asterane/the-grid/electronics/current-sources/board_prototype_1.jpg

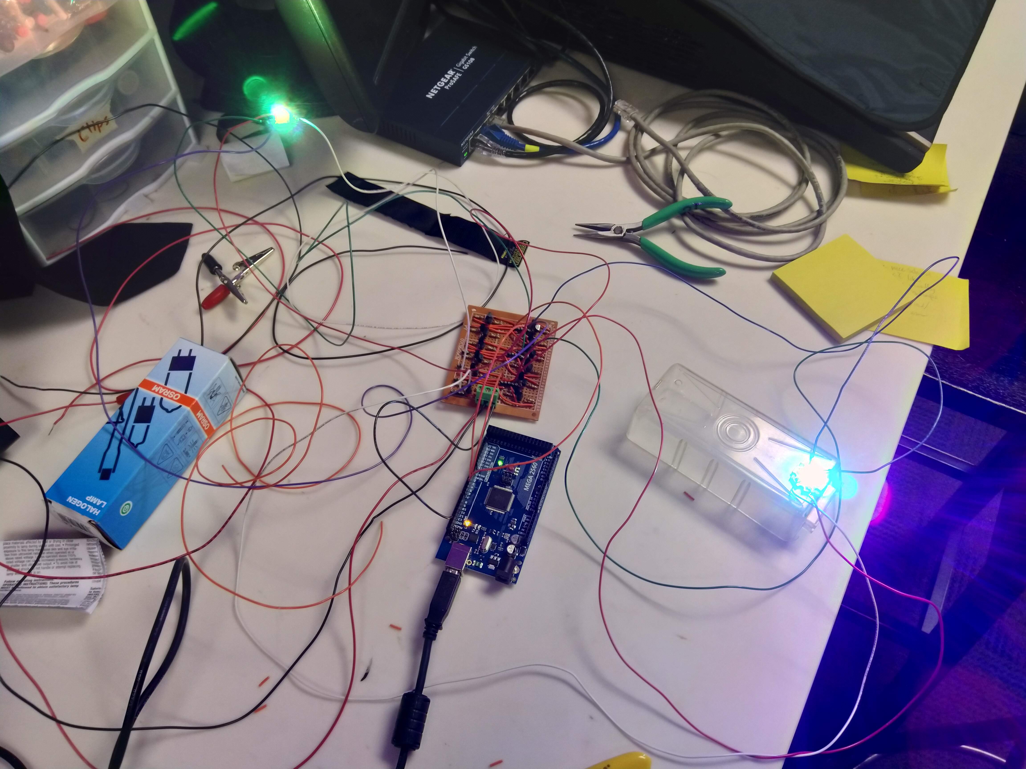
electronics/current-sources/board_prototype_1.jpg
