asterane/the-grid/electronics/current-sources/board_prototype_2.jpg

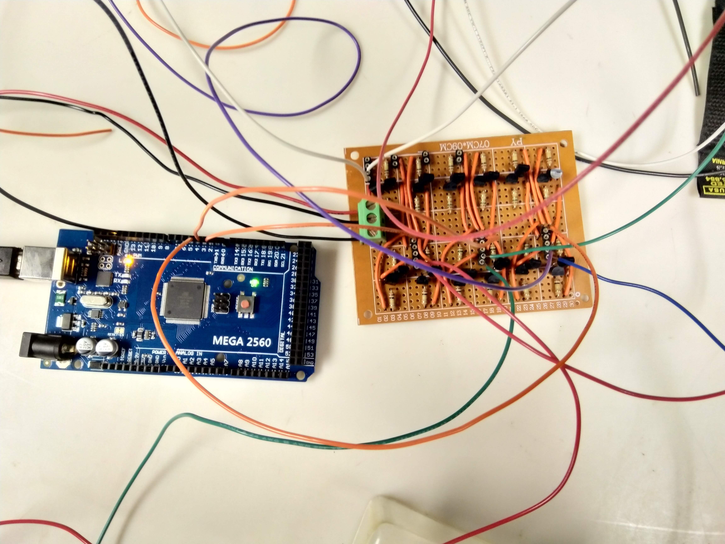
electronics/current-sources/board_prototype_2.jpg
