asterane/the-grid/electronics/current-sources/board_prototype_3.jpg

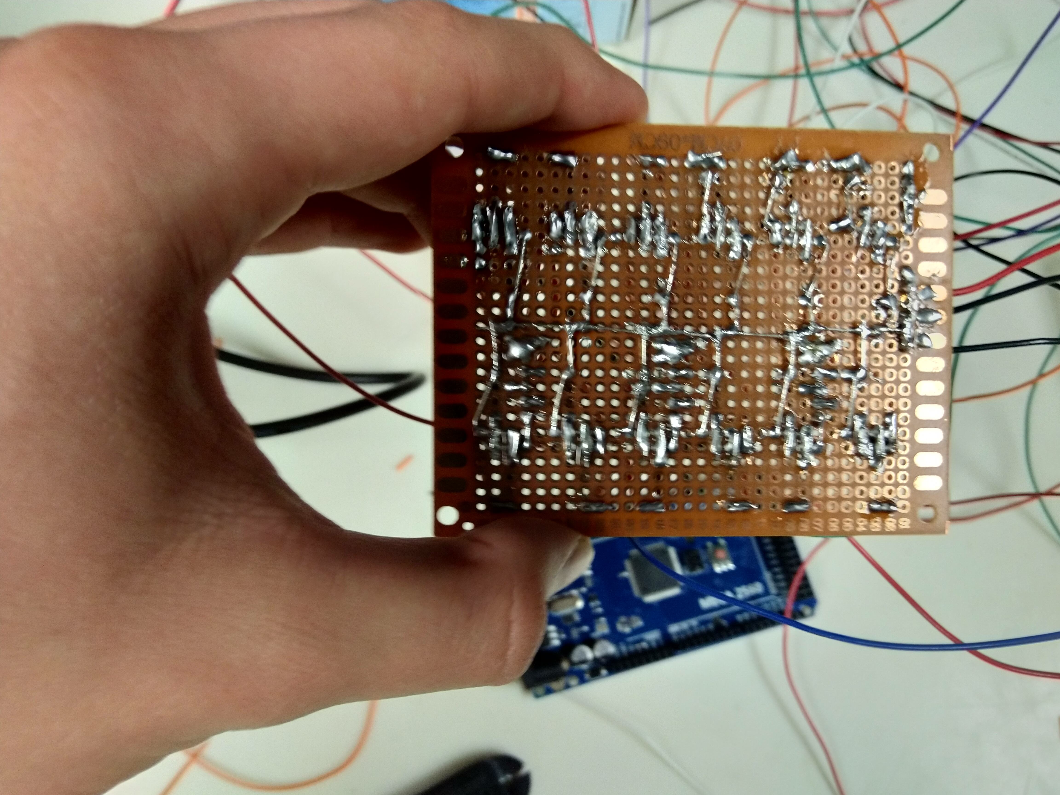
electronics/current-sources/board_prototype_3.jpg
