asterane/the-grid/electronics/current-sources/board_prototype_4.jpg

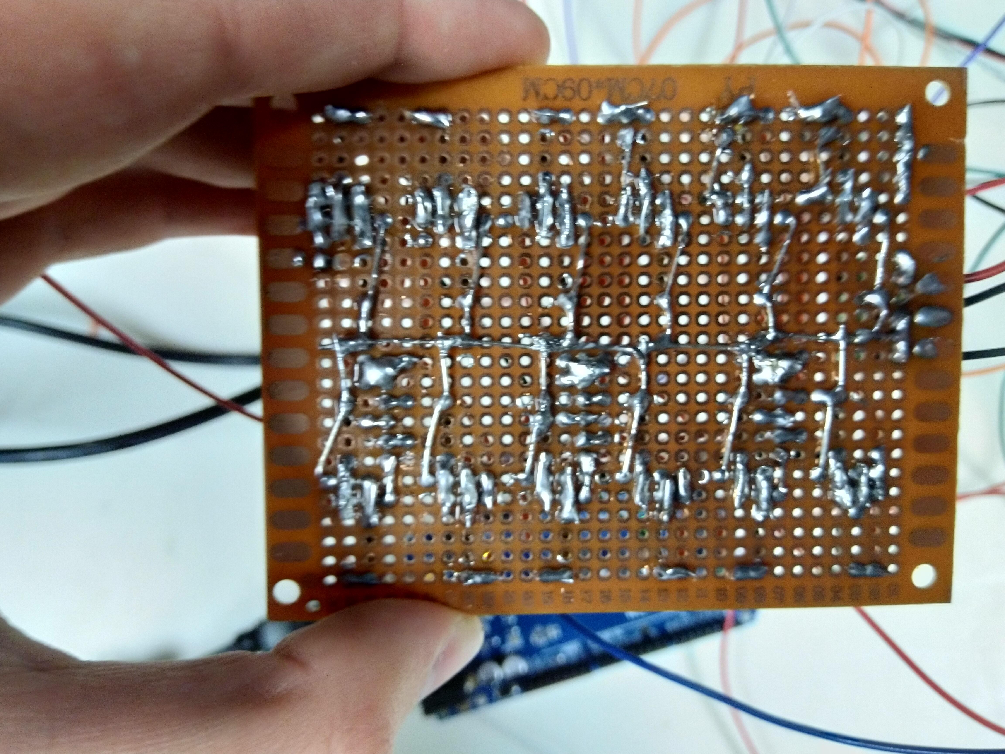
electronics/current-sources/board_prototype_4.jpg
