asterane/the-grid/electronics/current-sources/board_prototype_5.jpg

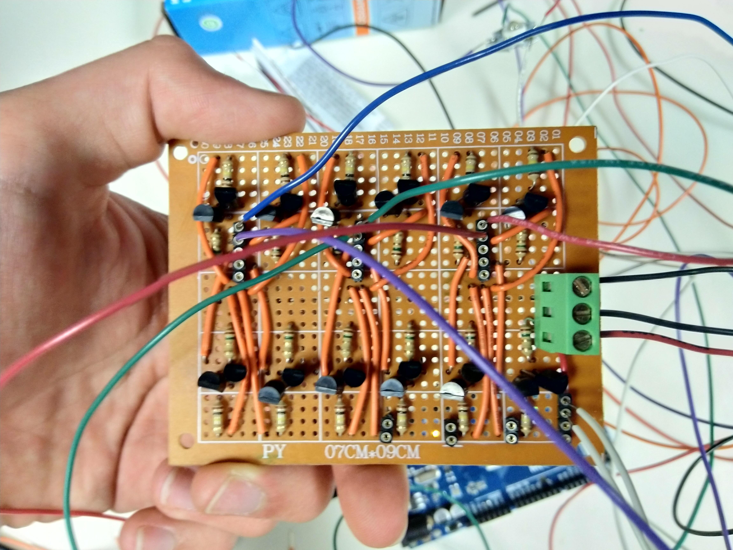
electronics/current-sources/board_prototype_5.jpg
