asterane/the-grid/electronics/current-sources/board_prototype_6.jpg

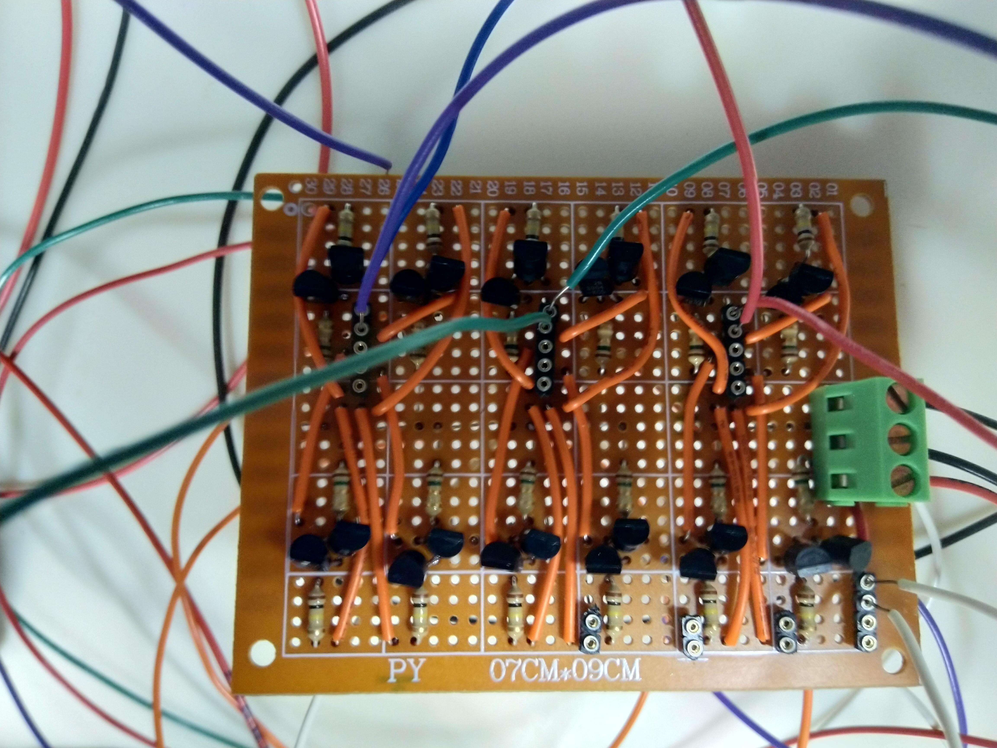
electronics/current-sources/board_prototype_6.jpg
