asterane/the-grid/electronics/current-sources/finished_boards_1.jpg

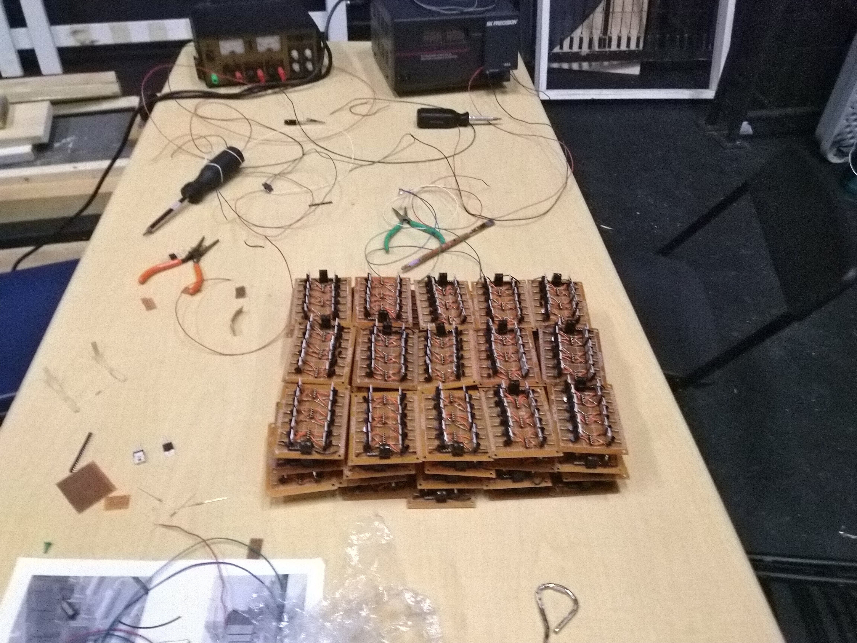
electronics/current-sources/finished_boards_1.jpg
