asterane/the-grid/electronics/current-sources/finished_boards_2.jpg

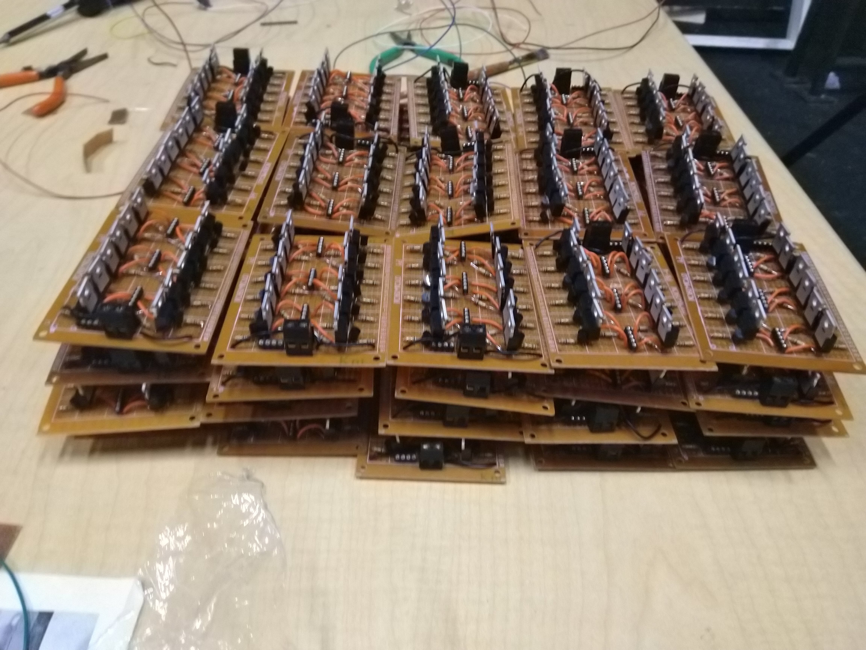
electronics/current-sources/finished_boards_2.jpg
