asterane/the-grid/electronics/current-sources/renderings/board1.png

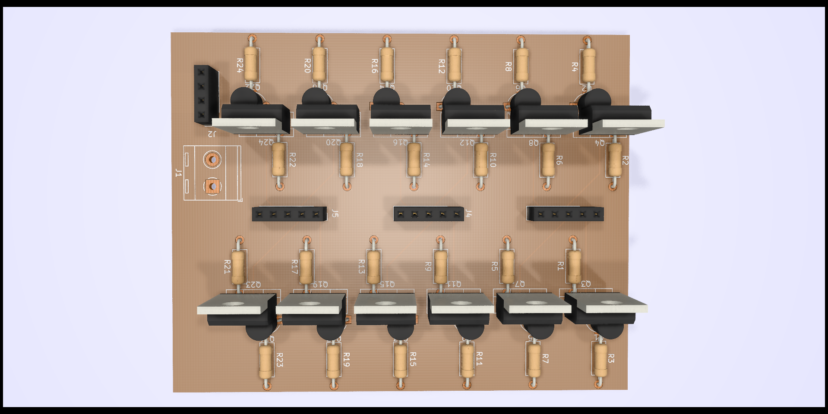
electronics/current-sources/renderings/board1.png
