asterane/the-grid/electronics/current-sources/renderings/board2.png

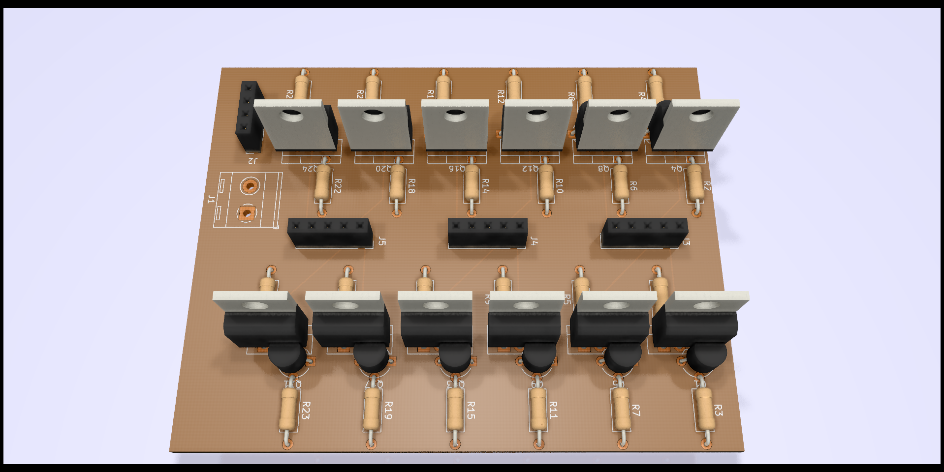
electronics/current-sources/renderings/board2.png
