asterane/the-grid/electronics/current-sources/renderings/board3.png

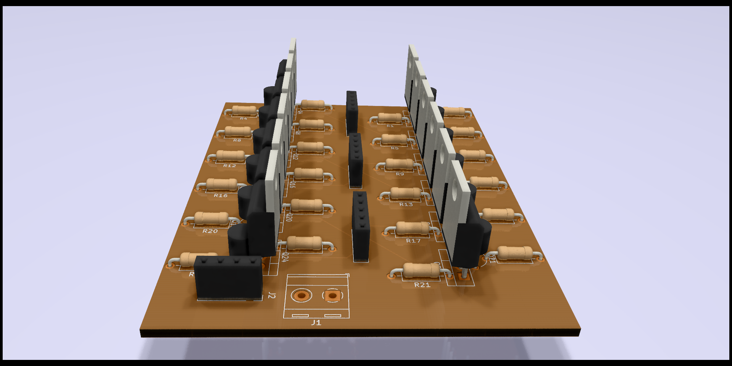
electronics/current-sources/renderings/board3.png
