asterane/the-grid/electronics/current-sources/renderings/board4.png

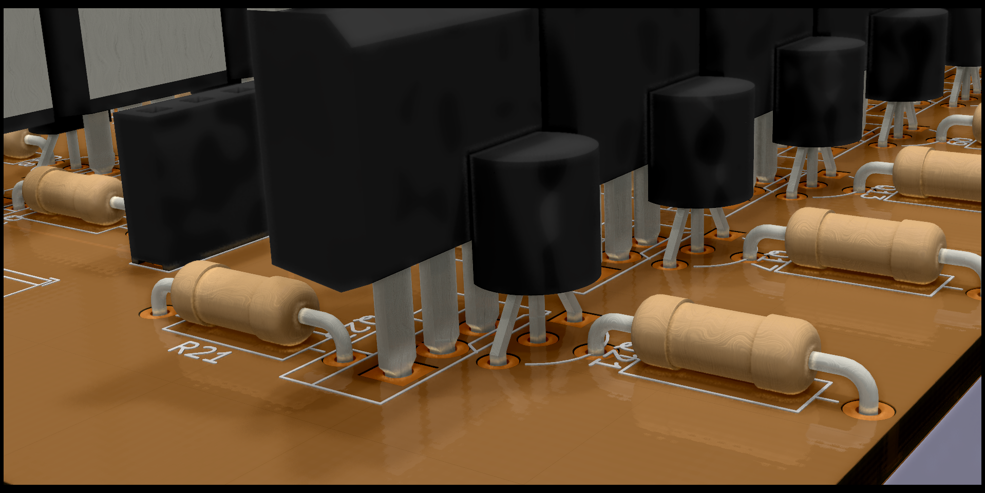
electronics/current-sources/renderings/board4.png
