asterane/the-grid/electronics/current-sources/renderings/board5.png

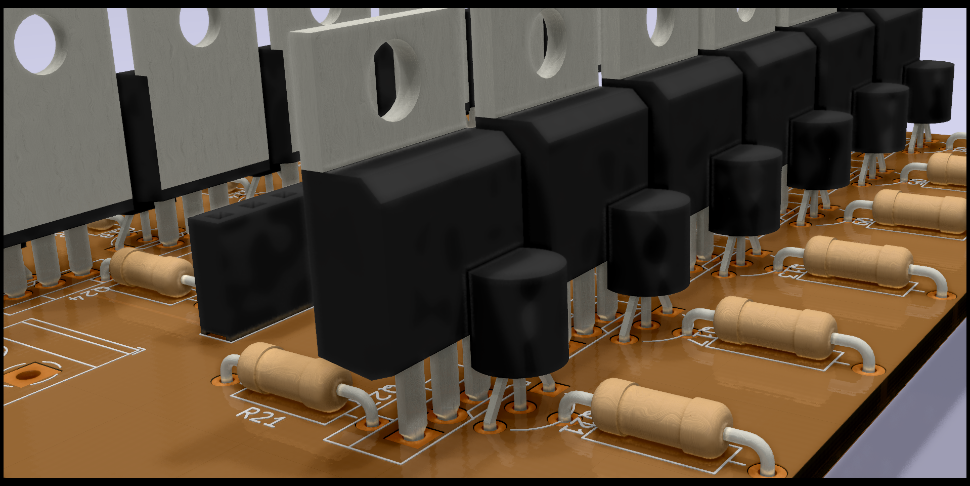
electronics/current-sources/renderings/board5.png
