asterane/the-grid/electronics/current-sources/renderings/board6.png

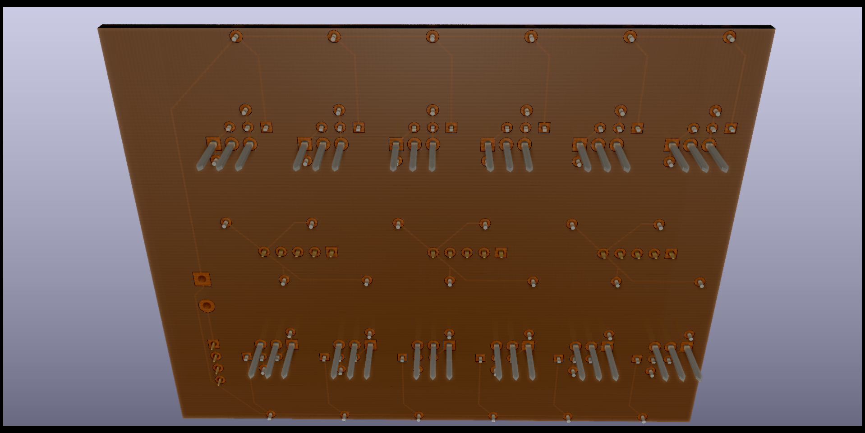
electronics/current-sources/renderings/board6.png
