asterane/the-grid/electronics/current-sources/renderings/board7.png

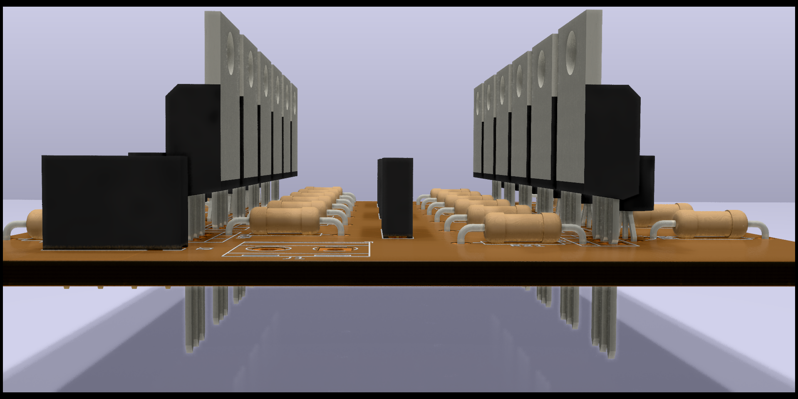
electronics/current-sources/renderings/board7.png
