asterane/the-grid/electronics/current-sources/renderings/board8.png

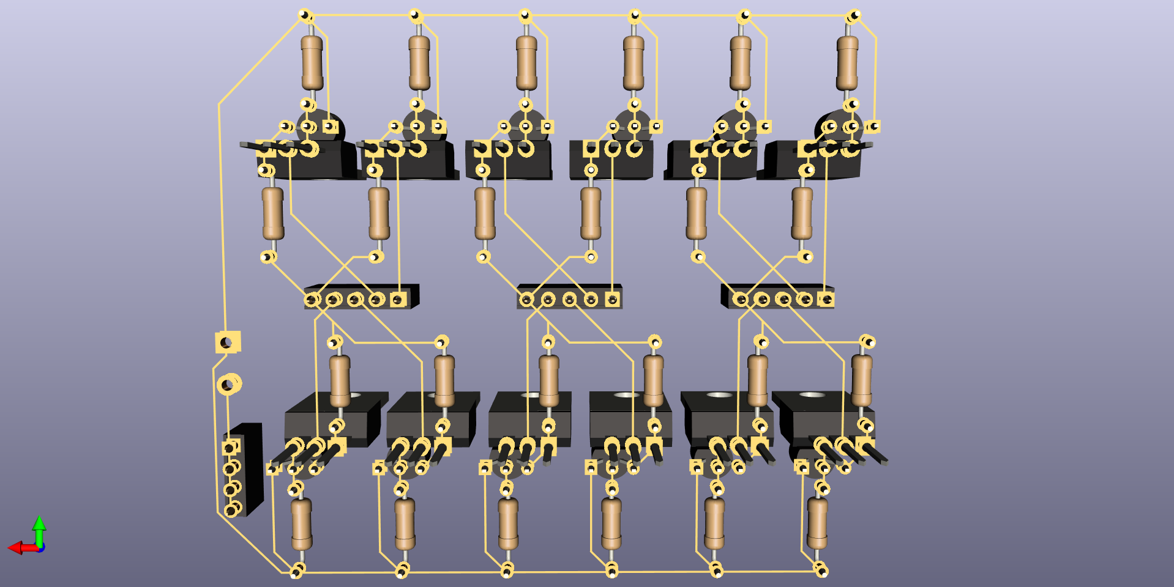
electronics/current-sources/renderings/board8.png
