asterane/the-grid/electronics/current-sources/renderings/board9.png

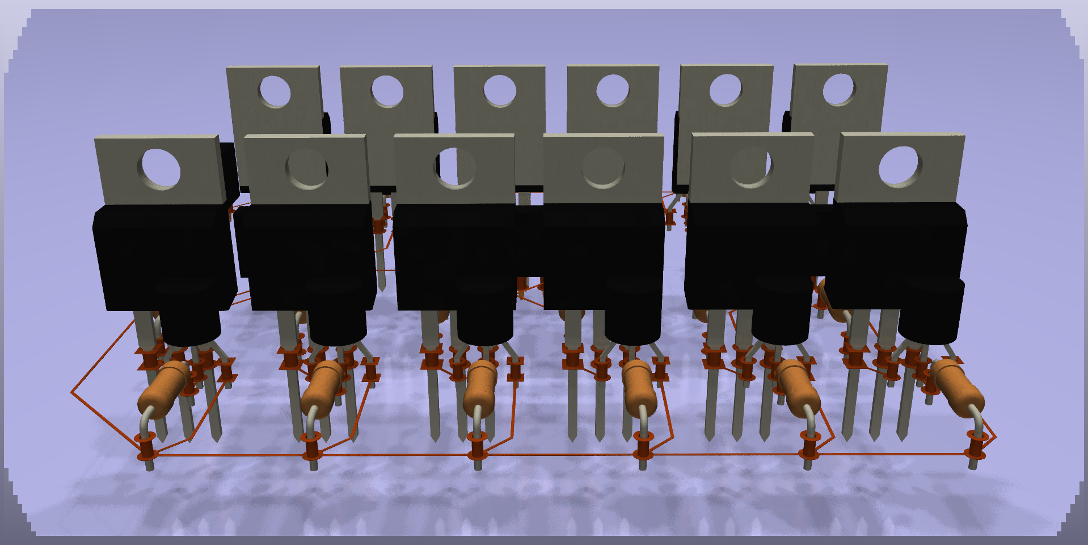
electronics/current-sources/renderings/board9.png
