asterane/the-grid/electronics/current-sources/renderings/board10.png

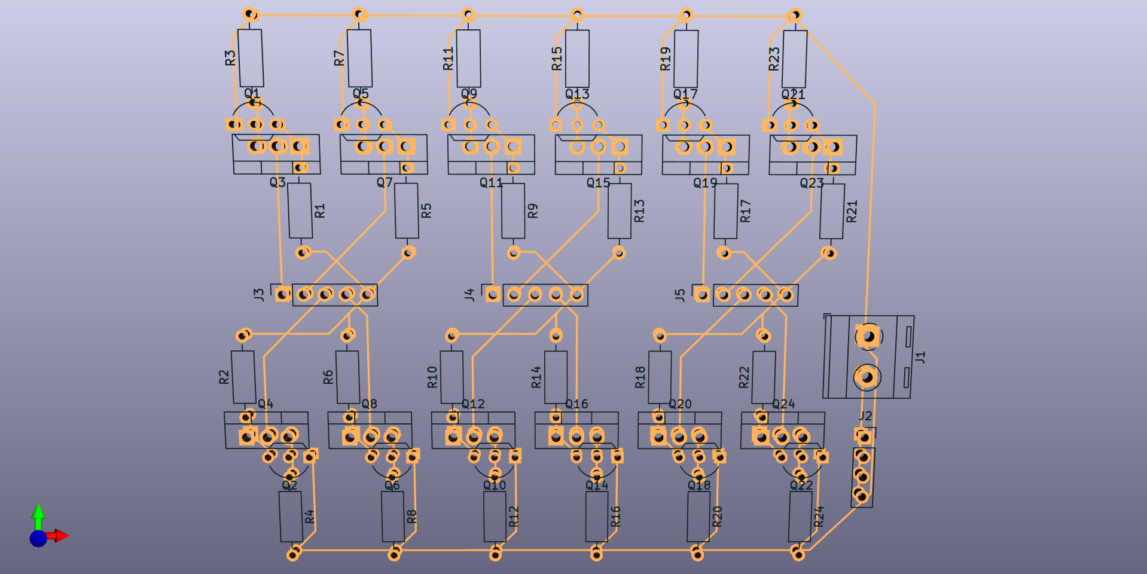
electronics/current-sources/renderings/board10.png
