asterane/the-grid/electronics/current-sources/renderings/board11.png

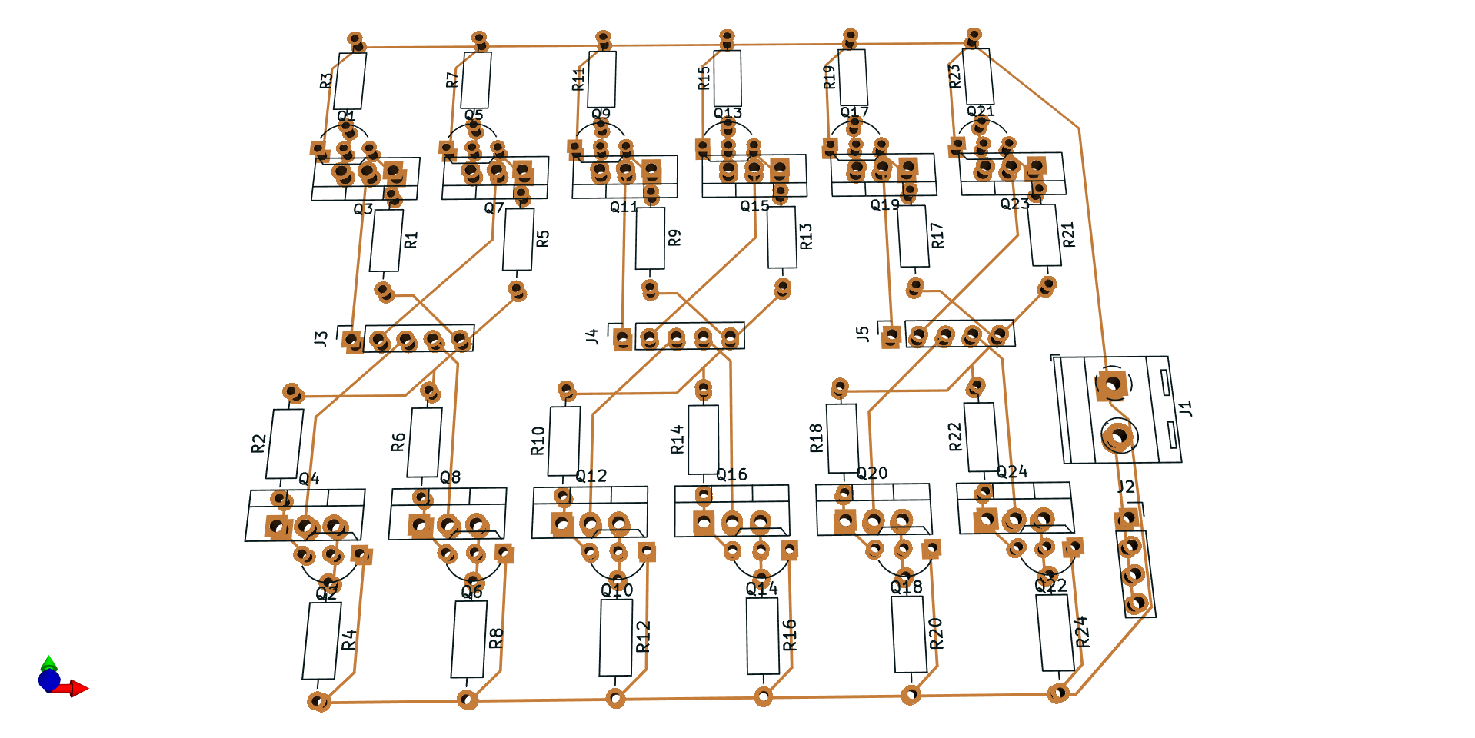
electronics/current-sources/renderings/board11.png
