asterane/the-grid/electronics/current-sources/renderings/board12.png

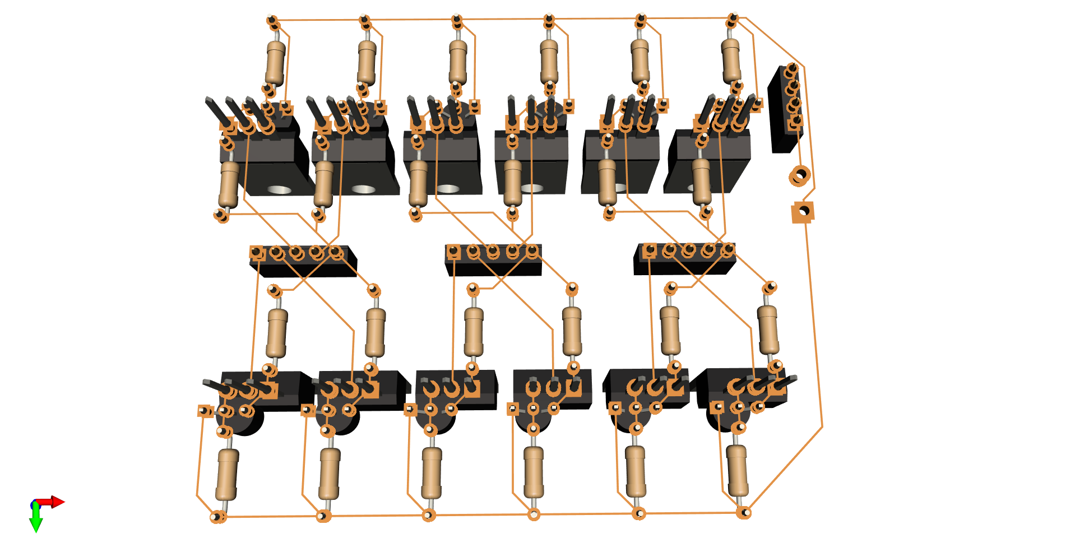
electronics/current-sources/renderings/board12.png
