asterane/the-grid/electronics/current-sources/renderings/board13.png

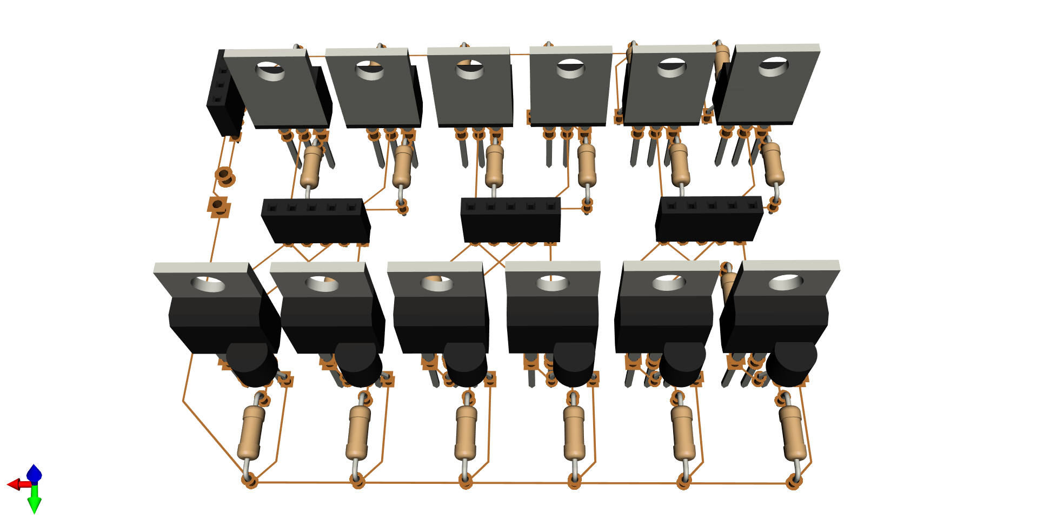
electronics/current-sources/renderings/board13.png
