asterane/the-grid/electronics/current-sources/renderings/board14.png

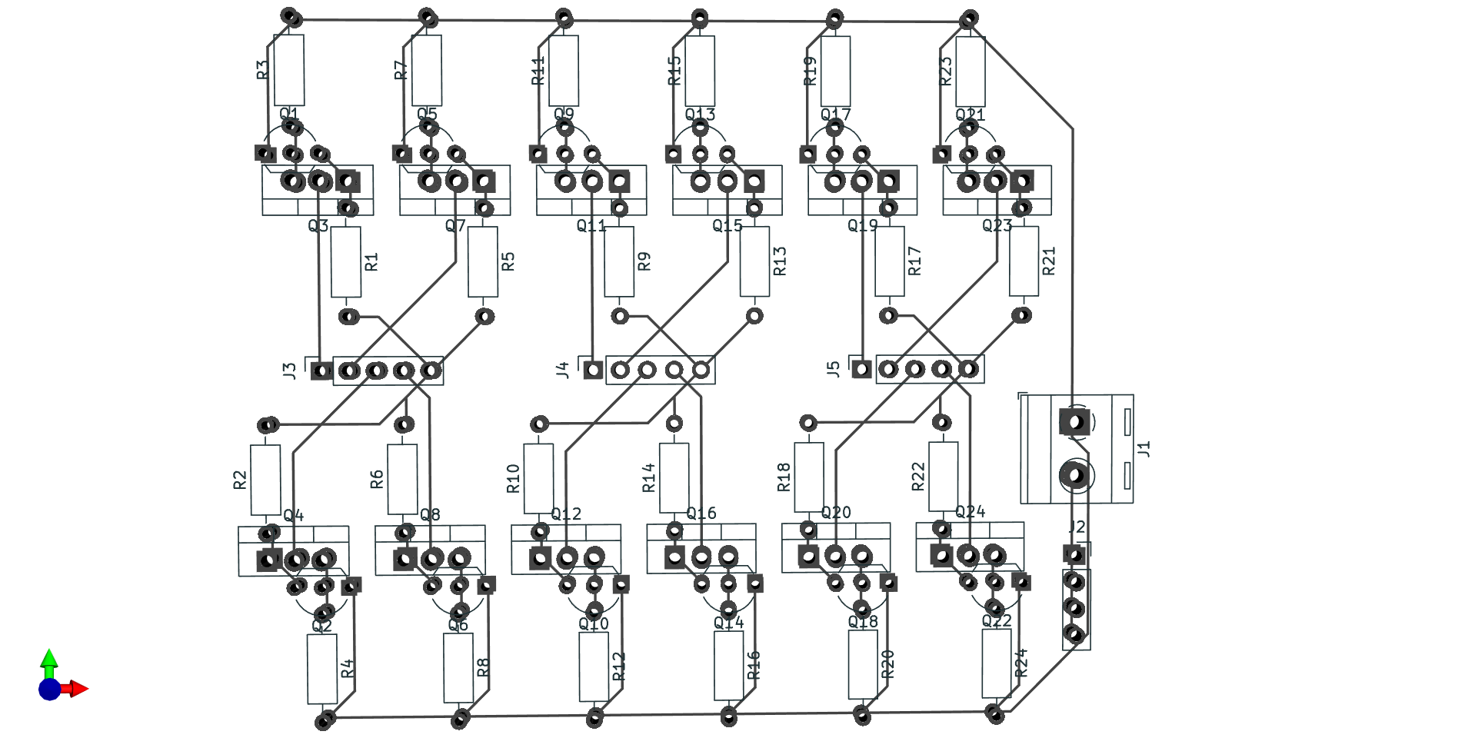
electronics/current-sources/renderings/board14.png
