asterane/the-grid/electronics/current-sources/renderings/board15.png

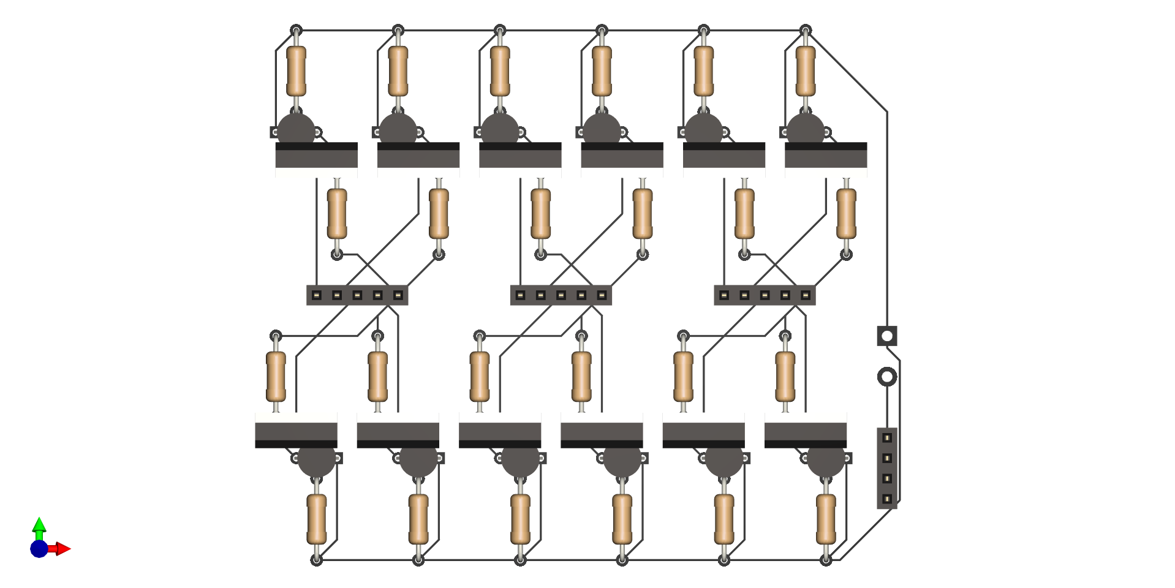
electronics/current-sources/renderings/board15.png
