asterane/the-grid/electronics/current-sources/renderings/board16.png

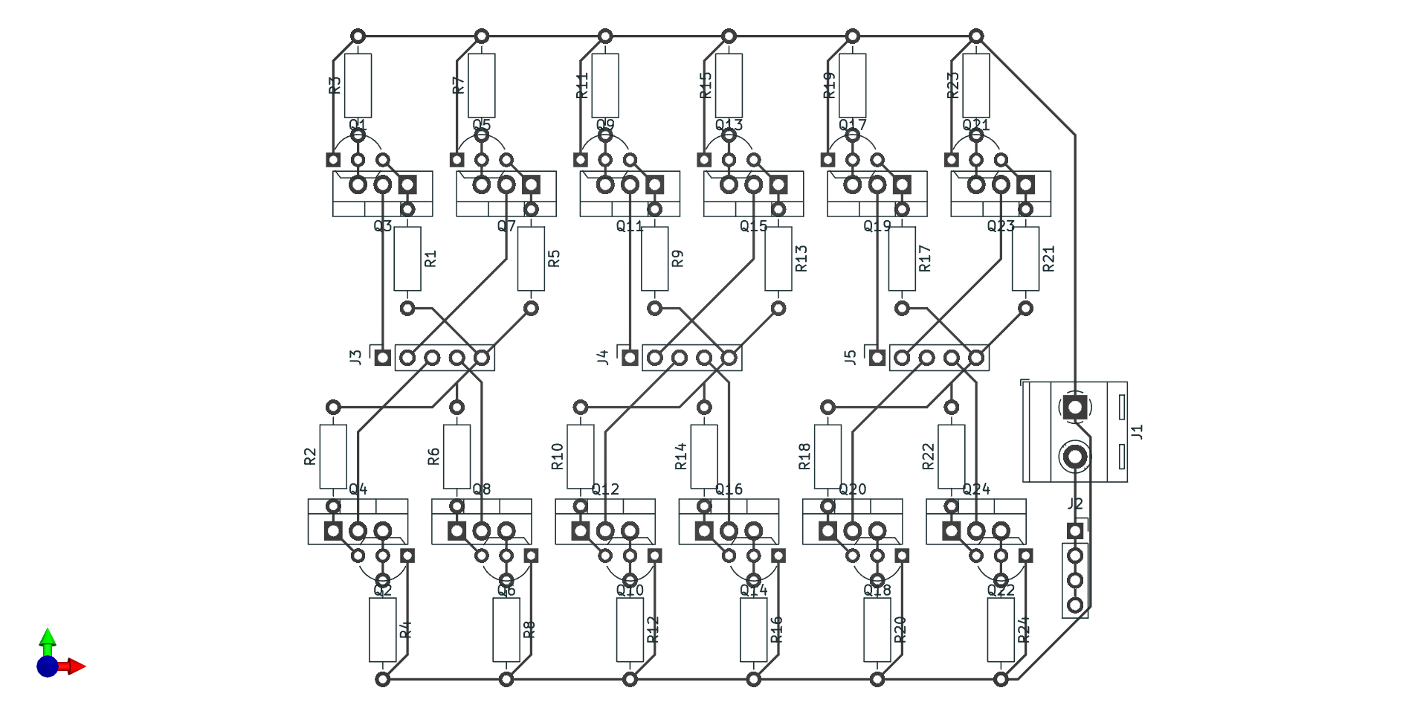
electronics/current-sources/renderings/board16.png
