asterane/the-grid/electronics/current-sources/renderings/board17.png

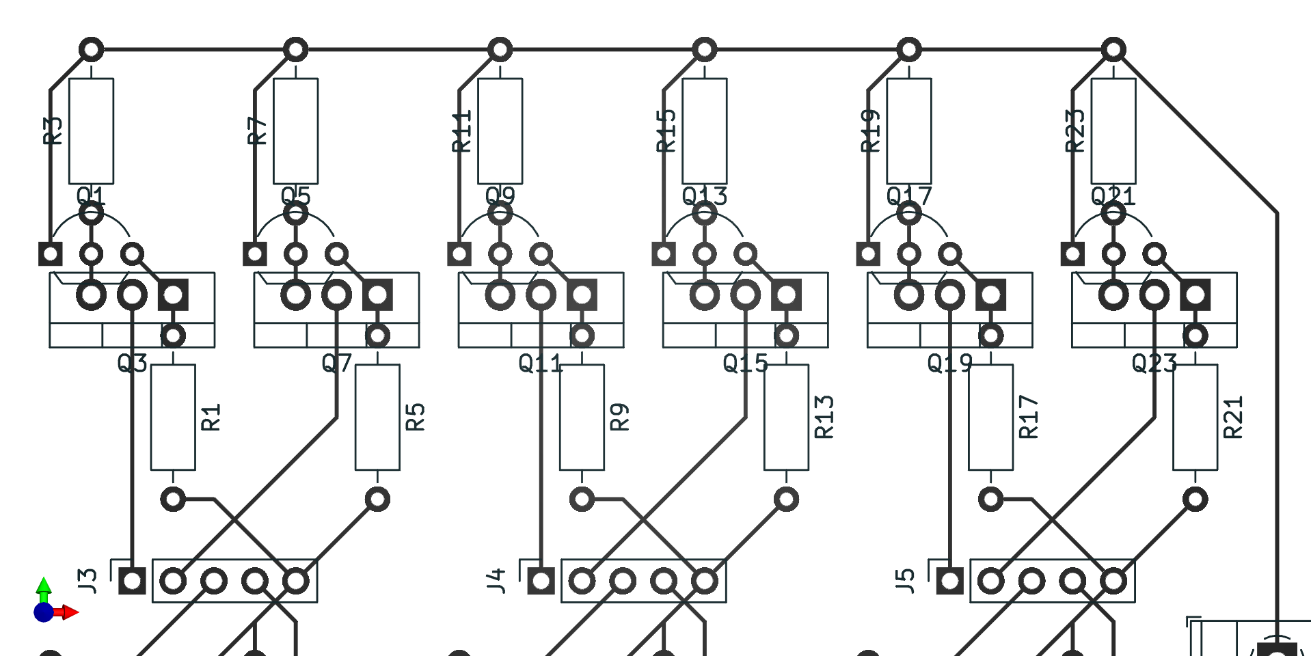
electronics/current-sources/renderings/board17.png
