asterane/the-grid/electronics/current-sources/renderings/board18.png

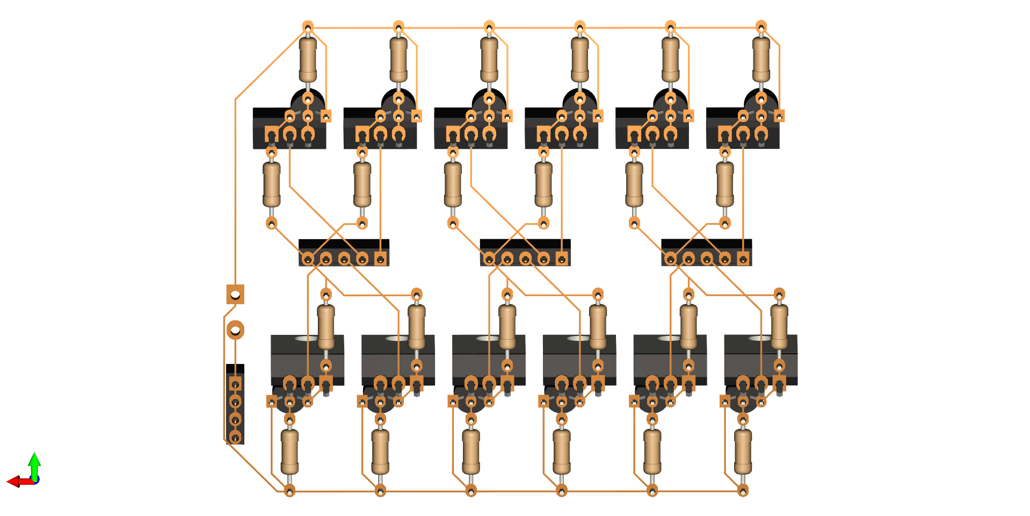
electronics/current-sources/renderings/board18.png
