asterane/the-grid/electronics/integration_01.jpg

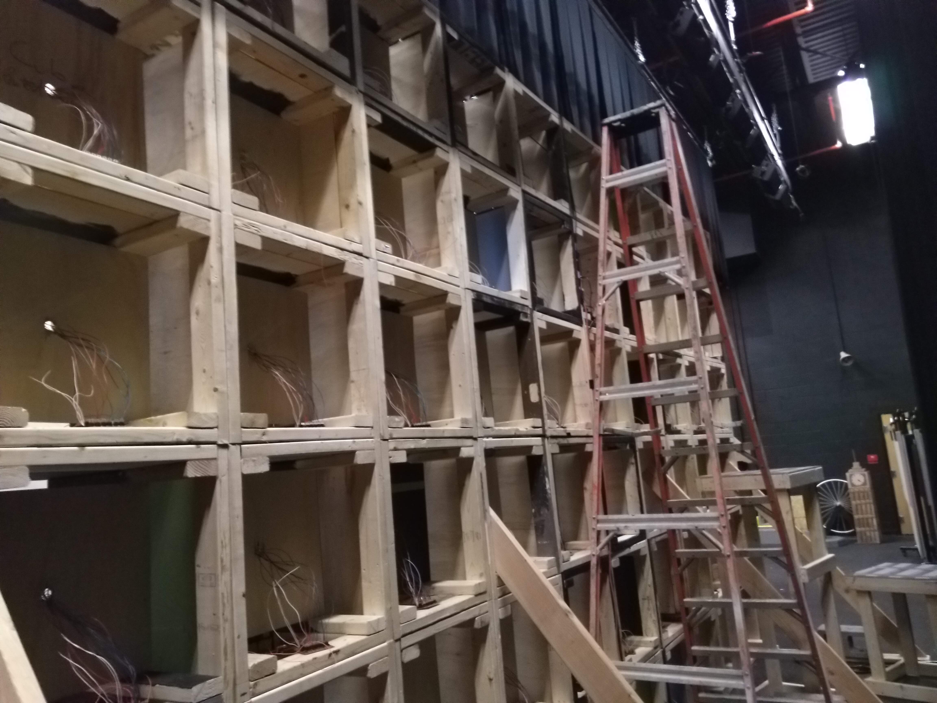
electronics/integration_01.jpg
