asterane/the-grid/electronics/integration_02.jpg

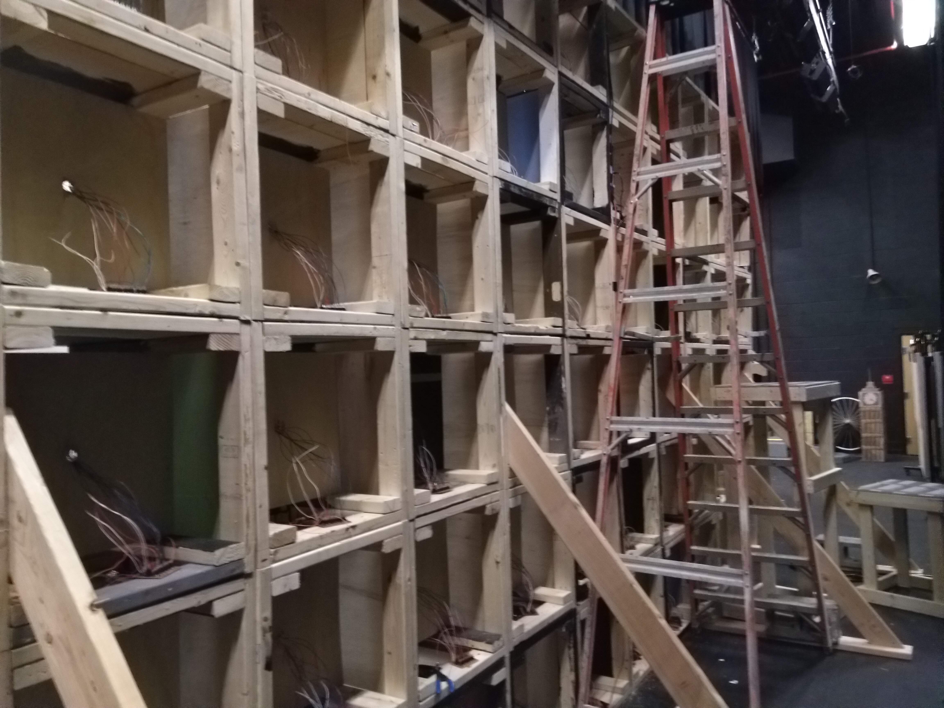
electronics/integration_02.jpg
