asterane/the-grid/electronics/integration_03.jpg

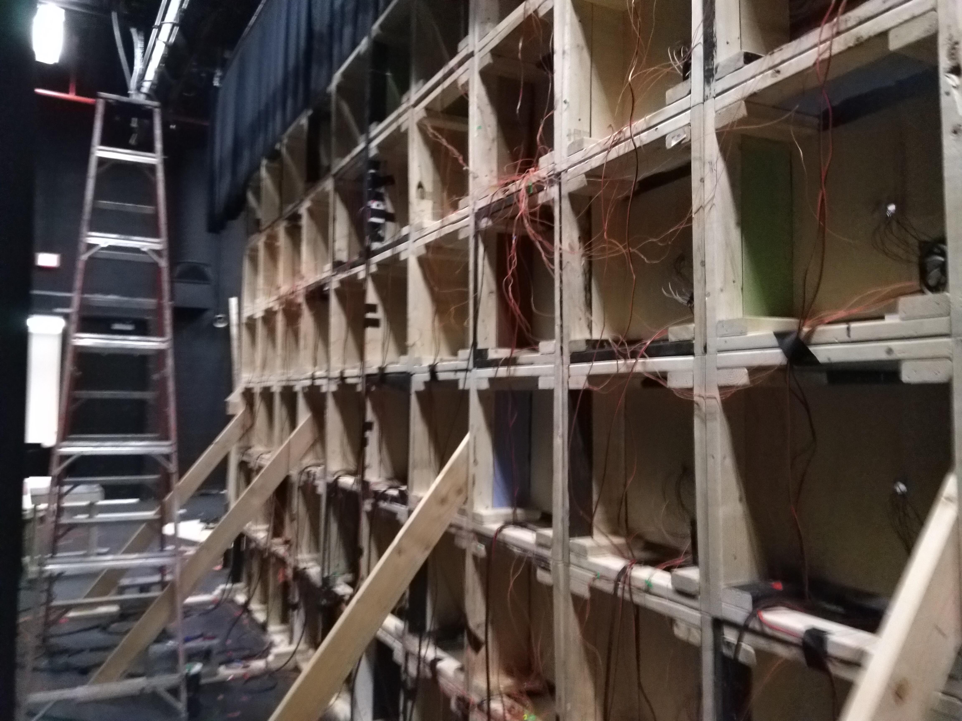
electronics/integration_03.jpg
