asterane/the-grid/electronics/integration_04.jpg

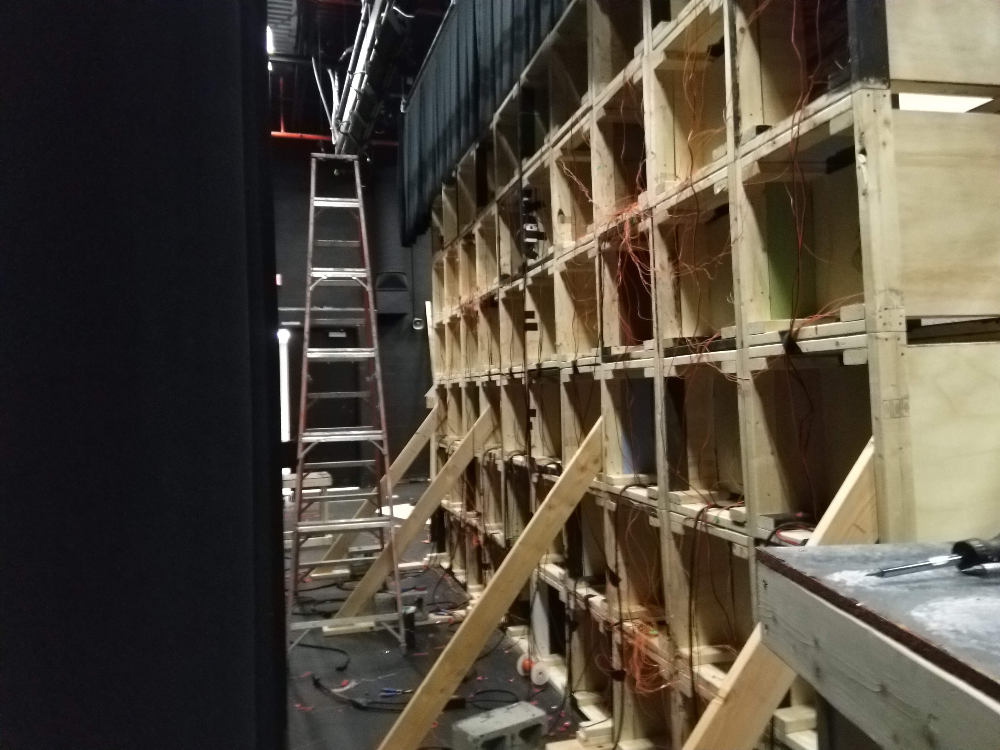
electronics/integration_04.jpg
