asterane/the-grid/electronics/integration_05.jpg

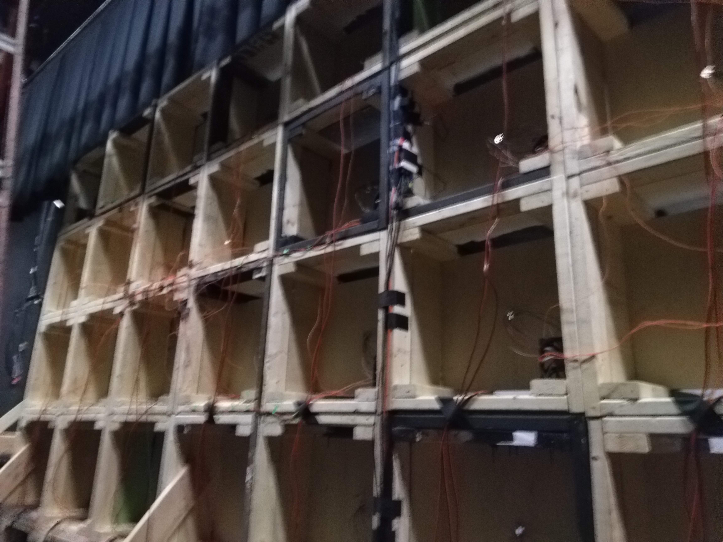
electronics/integration_05.jpg
