asterane/the-grid/electronics/integration_06.jpg

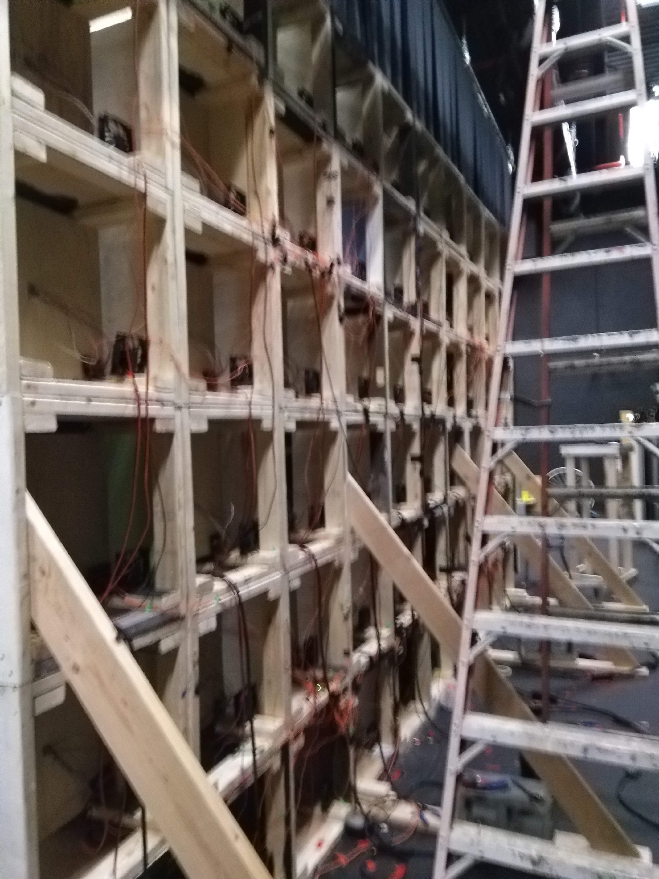
electronics/integration_06.jpg
