asterane/the-grid/electronics/integration_07.jpg

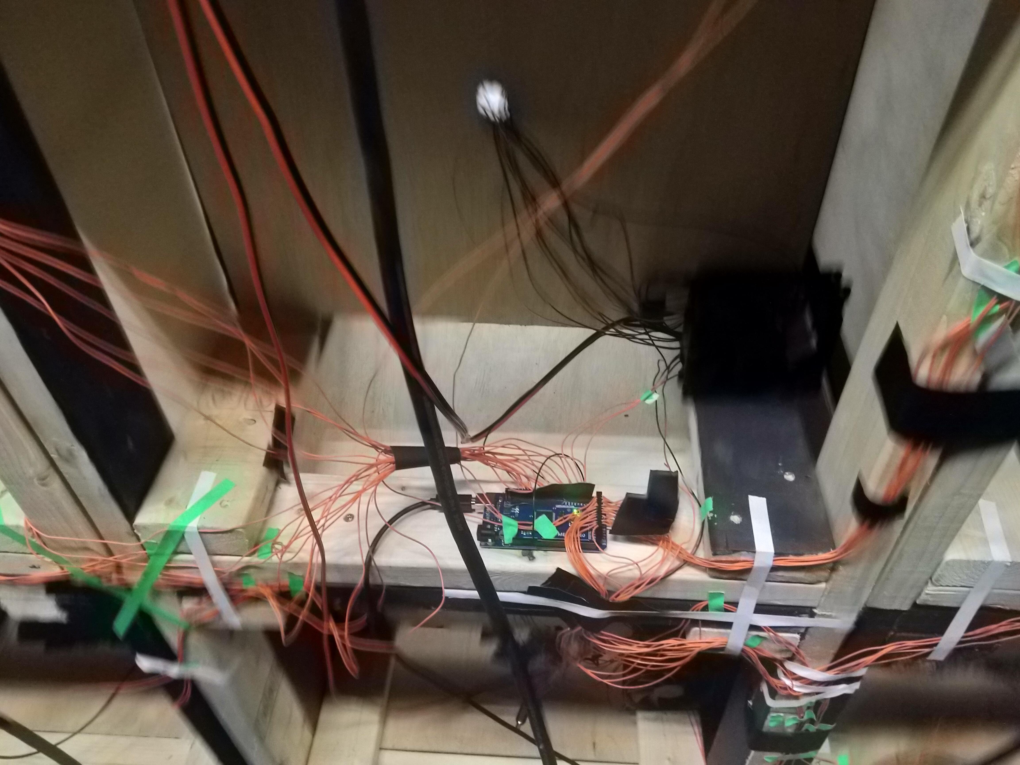
electronics/integration_07.jpg
