asterane/the-grid/electronics/integration_08.jpg

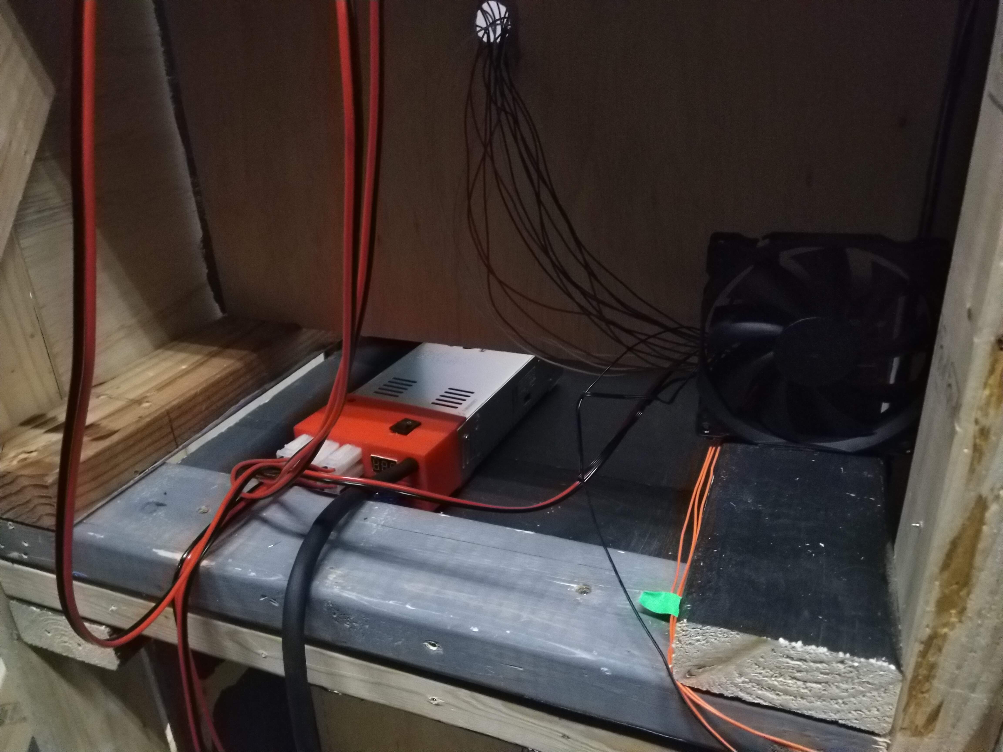
electronics/integration_08.jpg
