asterane/the-grid/electronics/integration_09.jpg

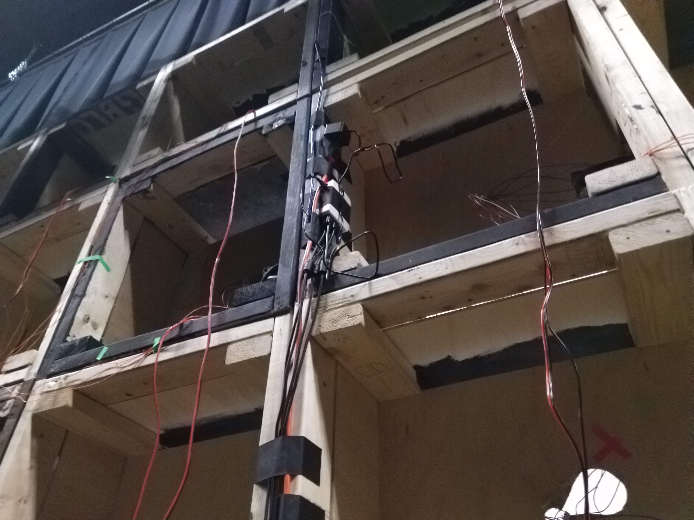
electronics/integration_09.jpg
