asterane/the-grid/electronics/integration_10.jpg

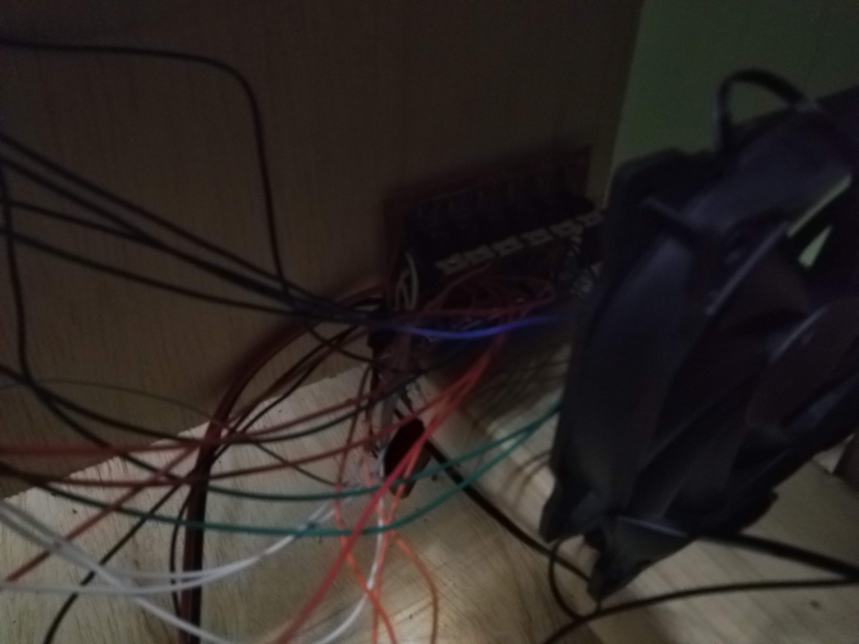
electronics/integration_10.jpg
