asterane/the-grid/electronics/integration_11.jpg

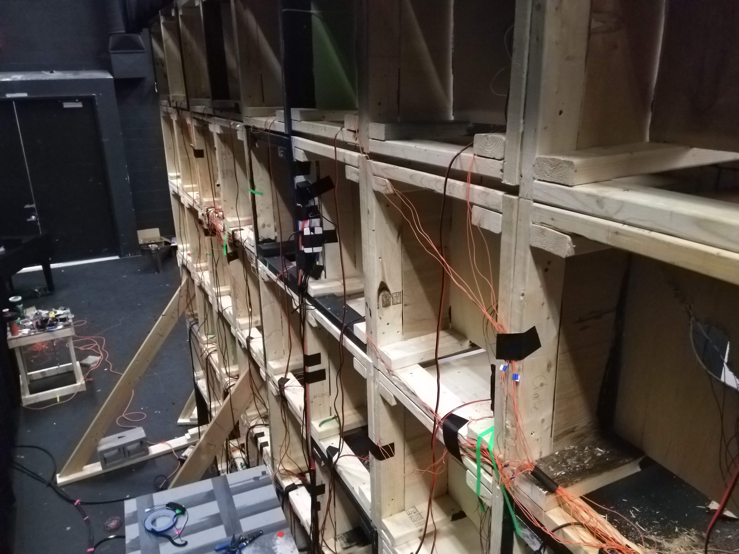
electronics/integration_11.jpg
