asterane/the-grid/electronics/integration_12.jpg

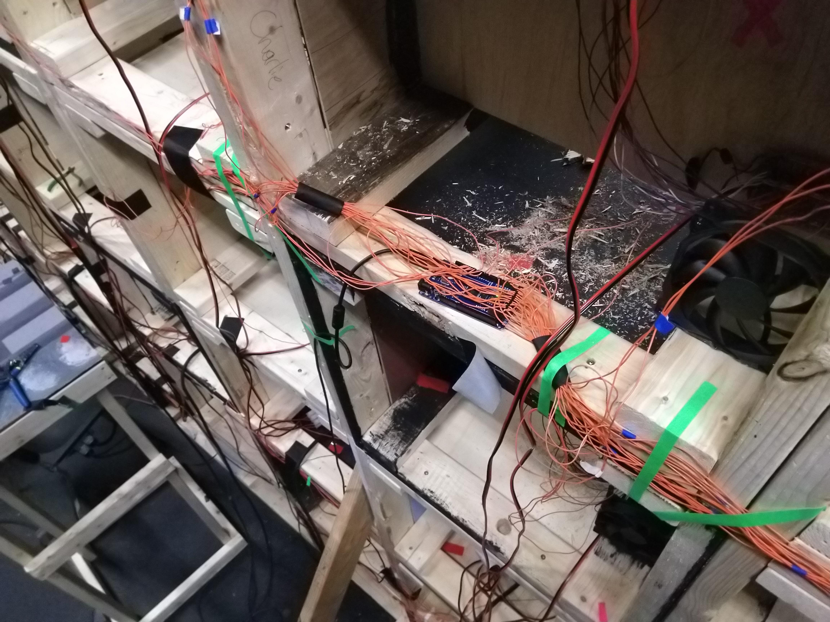
electronics/integration_12.jpg
