asterane/the-grid/electronics/overview.jpg

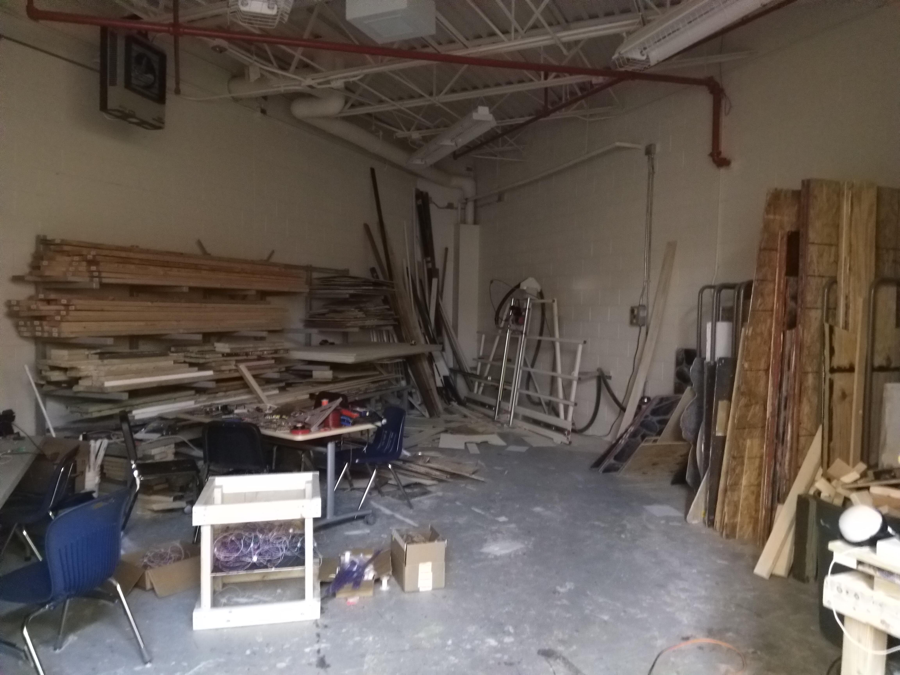
electronics/overview.jpg
