asterane/the-grid/electronics/power-supplies/finished_psu_1.jpg

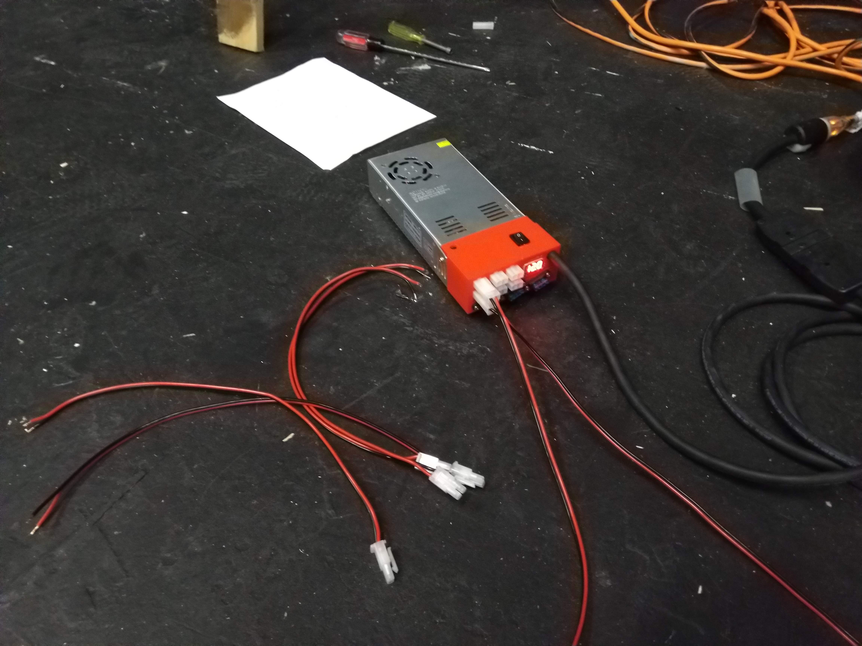
electronics/power-supplies/finished_psu_1.jpg
