asterane/the-grid/electronics/power-supplies/finished_psu_2.jpg

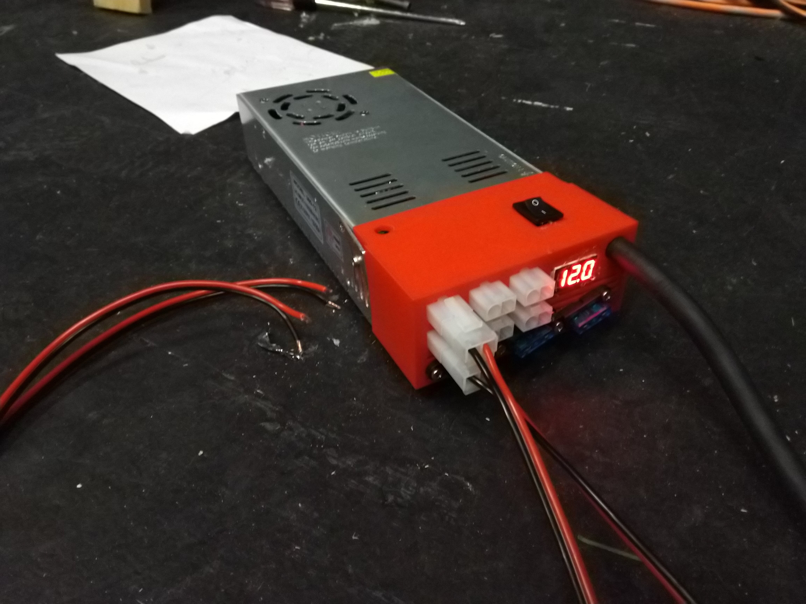
electronics/power-supplies/finished_psu_2.jpg
