asterane/the-grid/electronics/power-supplies/finished_psu_3.jpg

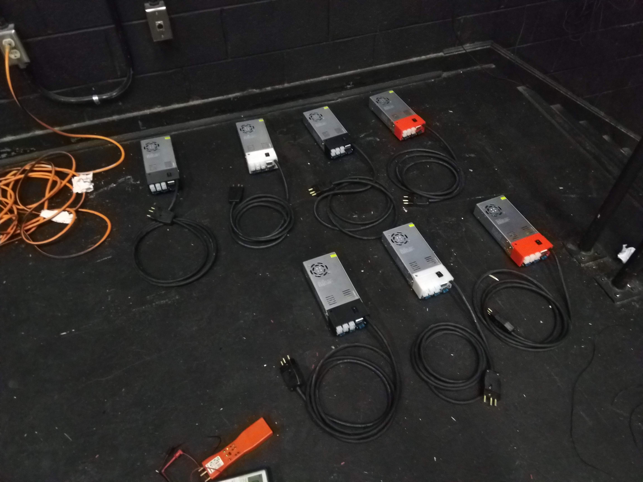
electronics/power-supplies/finished_psu_3.jpg
