asterane/the-grid/electronics/power-supplies/finished_psu_4.jpg

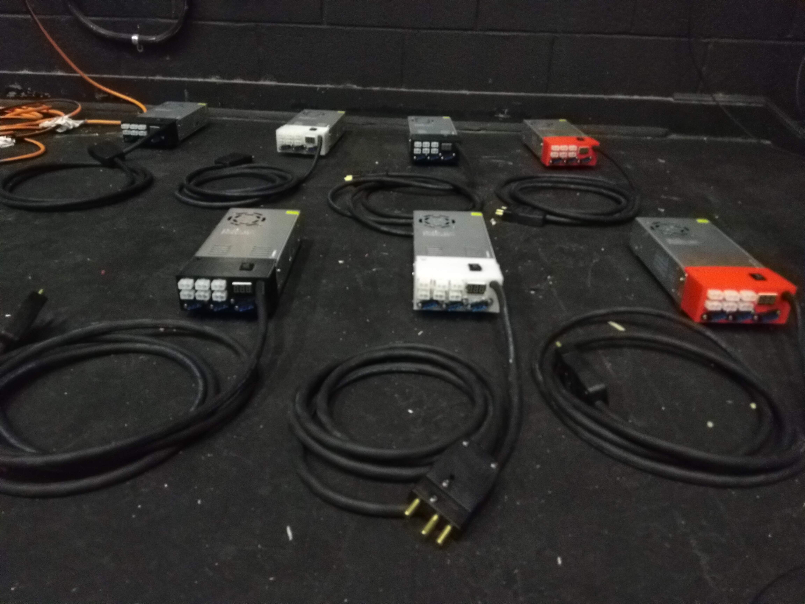
electronics/power-supplies/finished_psu_4.jpg
