asterane/the-grid/electronics/power-supplies/psu_cables_1.jpg

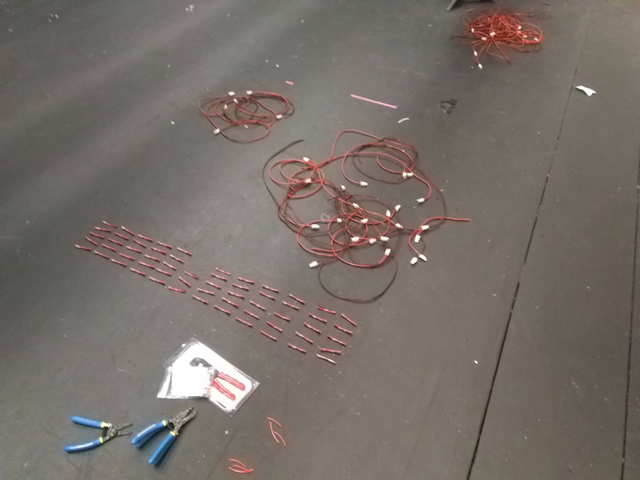
electronics/power-supplies/psu_cables_1.jpg
