asterane/the-grid/electronics/power-supplies/psu_cables_2.jpg

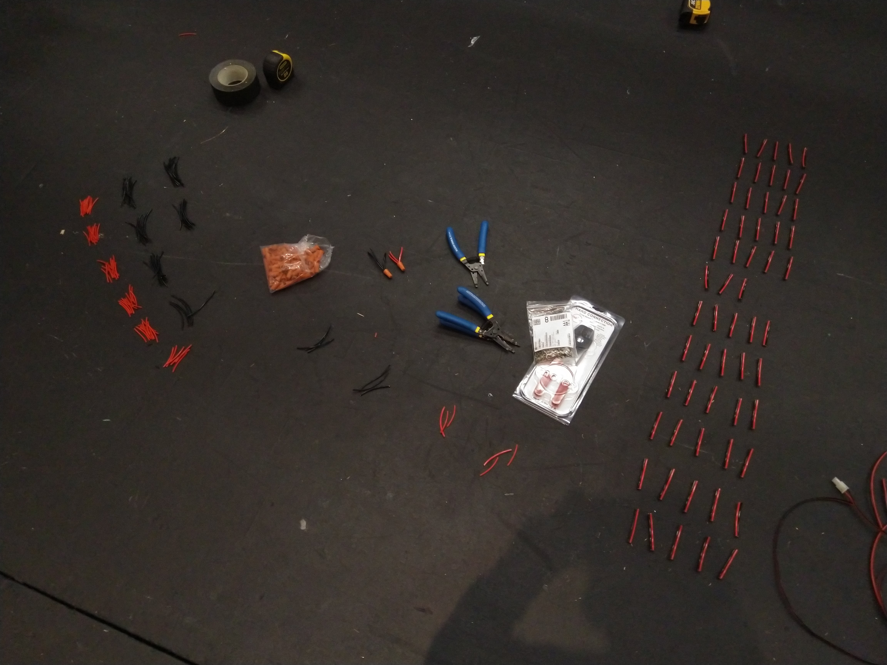
electronics/power-supplies/psu_cables_2.jpg
