asterane/the-grid/electronics/power-supplies/psu_cover_render.png

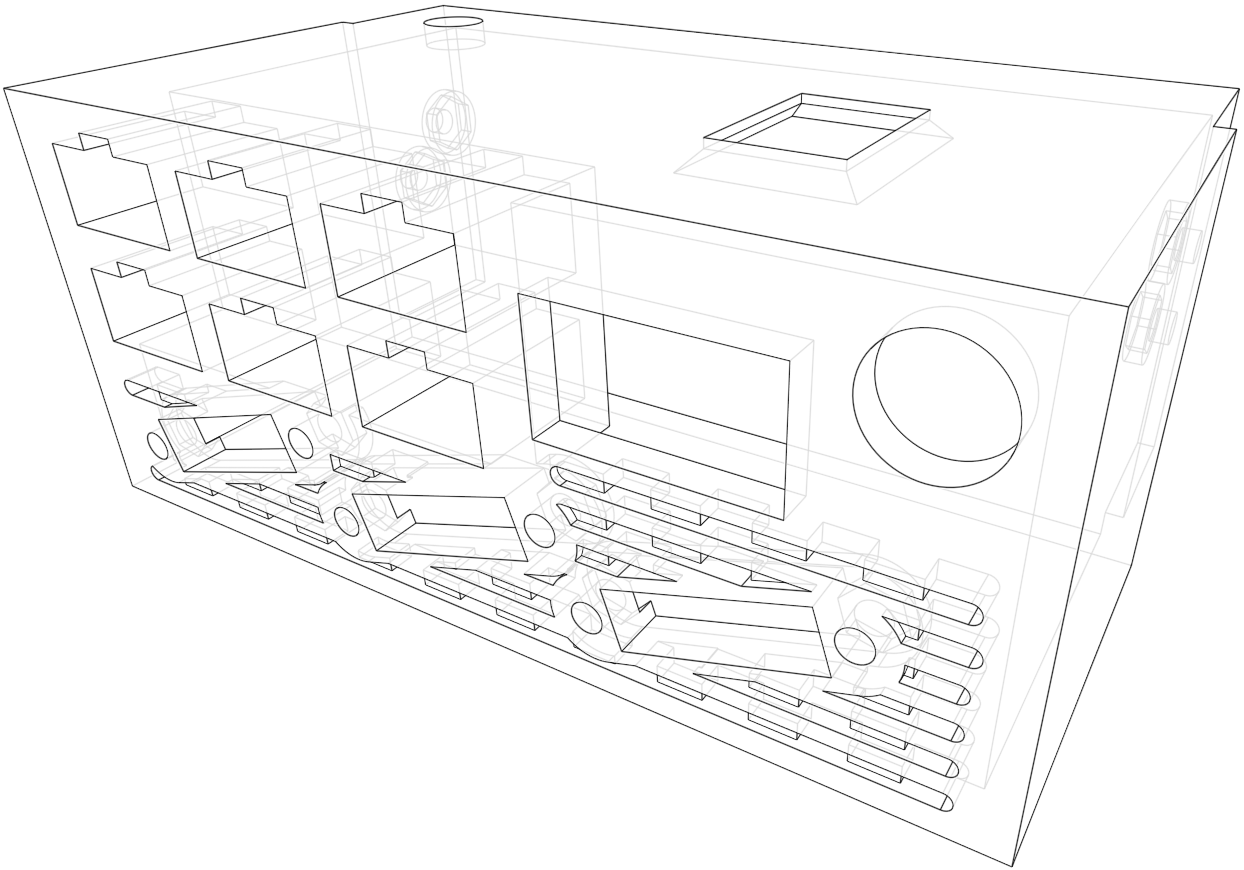
electronics/power-supplies/psu_cover_render.png
