asterane/the-grid/media/pictures/all_on_1.jpg

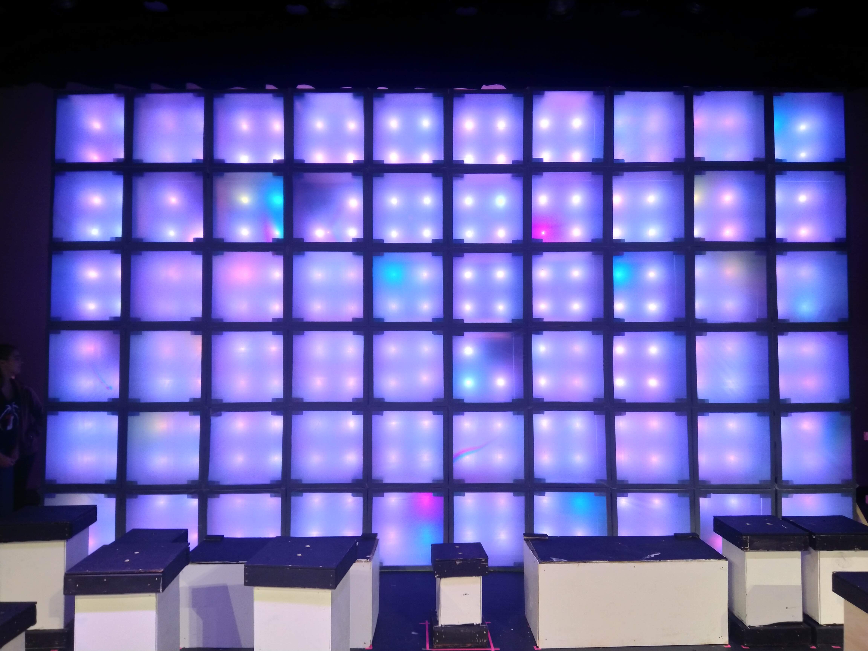
media/pictures/all_on_1.jpg
