asterane/the-grid/media/pictures/all_on_2.jpg

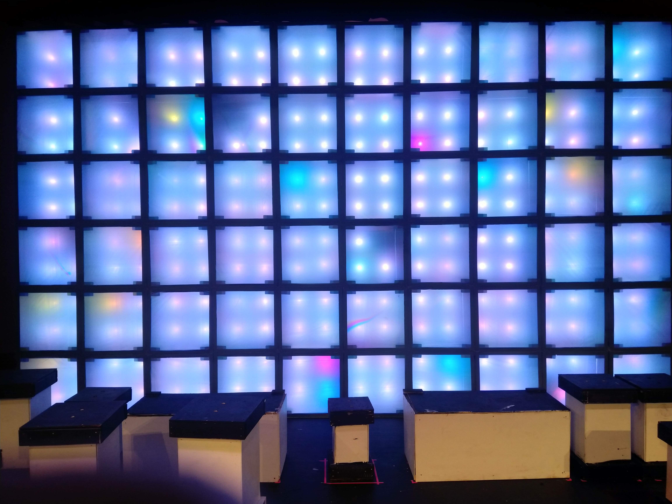
media/pictures/all_on_2.jpg
