asterane/the-grid/media/pictures/celebration_1.jpg

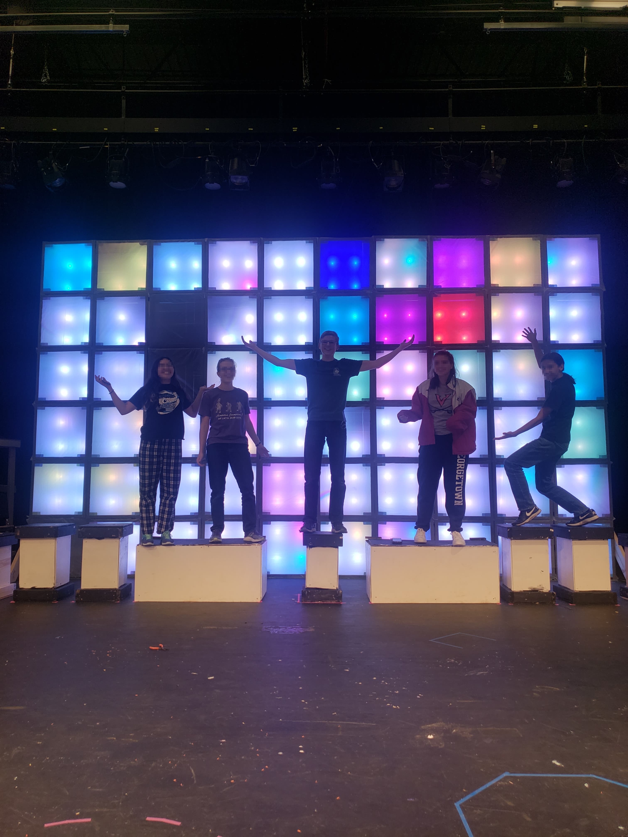
media/pictures/celebration_1.jpg
