asterane/the-grid/media/pictures/celebration_2.jpg

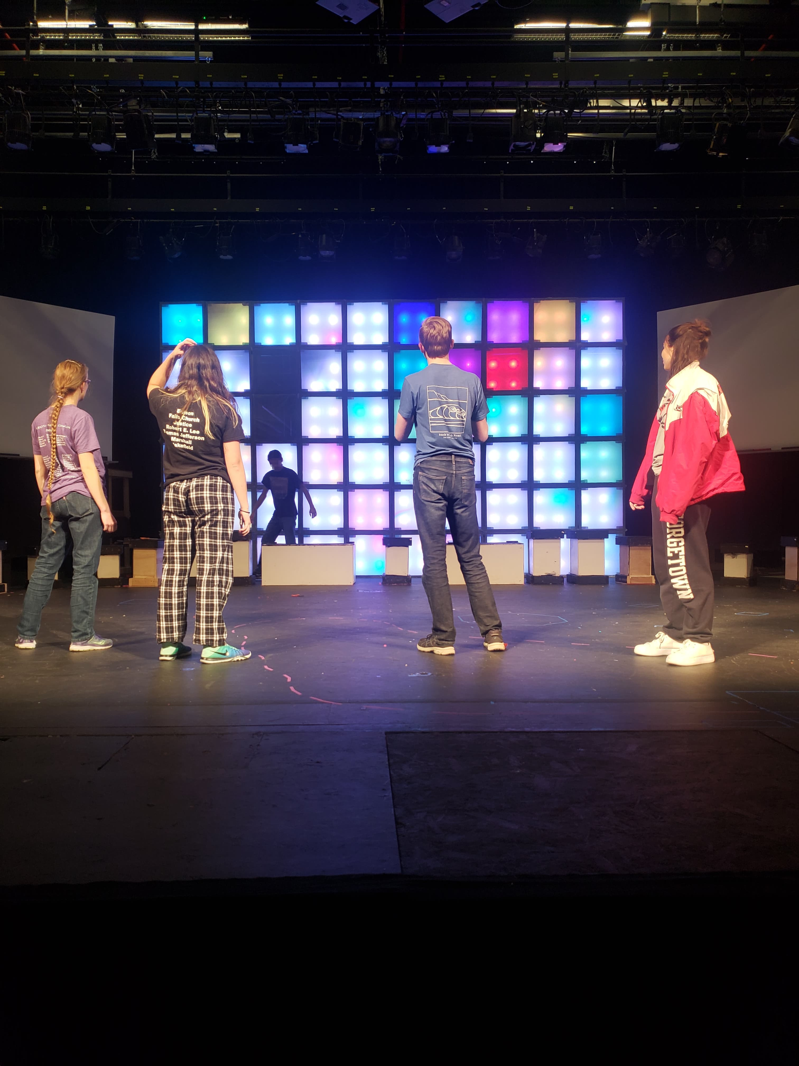
media/pictures/celebration_2.jpg
