asterane/the-grid/media/pictures/celebration_crop.jpg

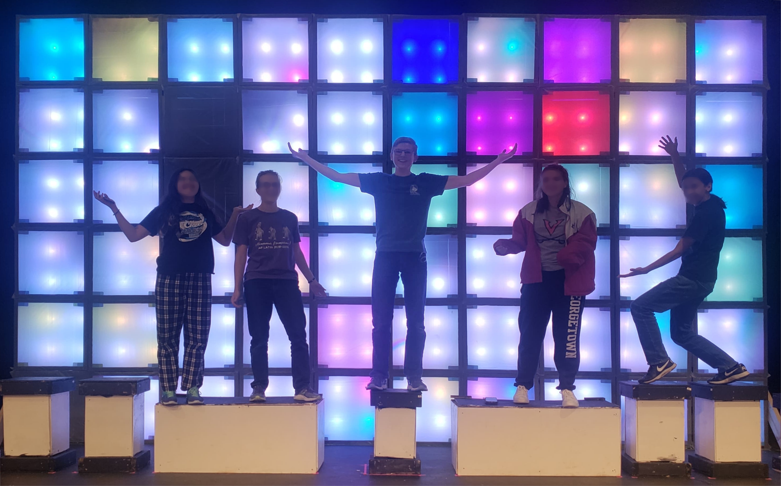
media/pictures/celebration_crop.jpg
