asterane/the-grid/media/pictures/finished_1.jpg

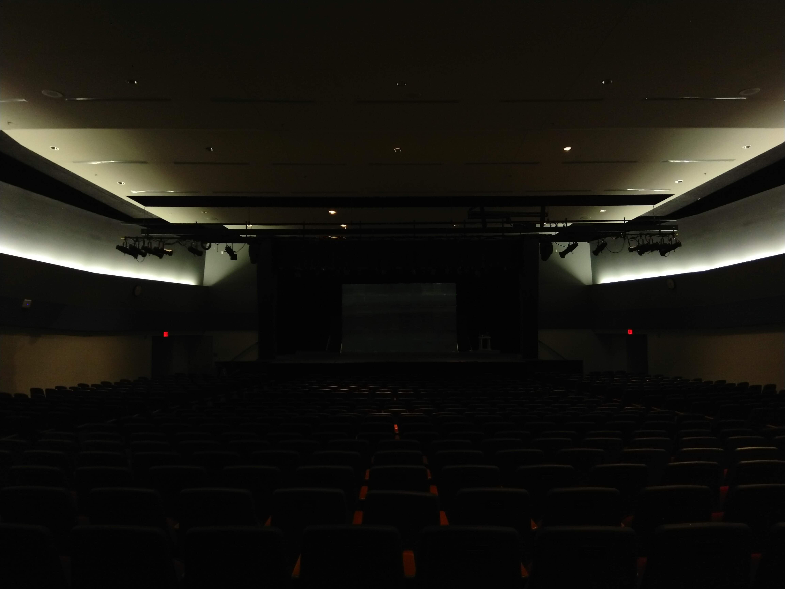
media/pictures/finished_1.jpg
