asterane/the-grid/media/pictures/finished_2.jpg

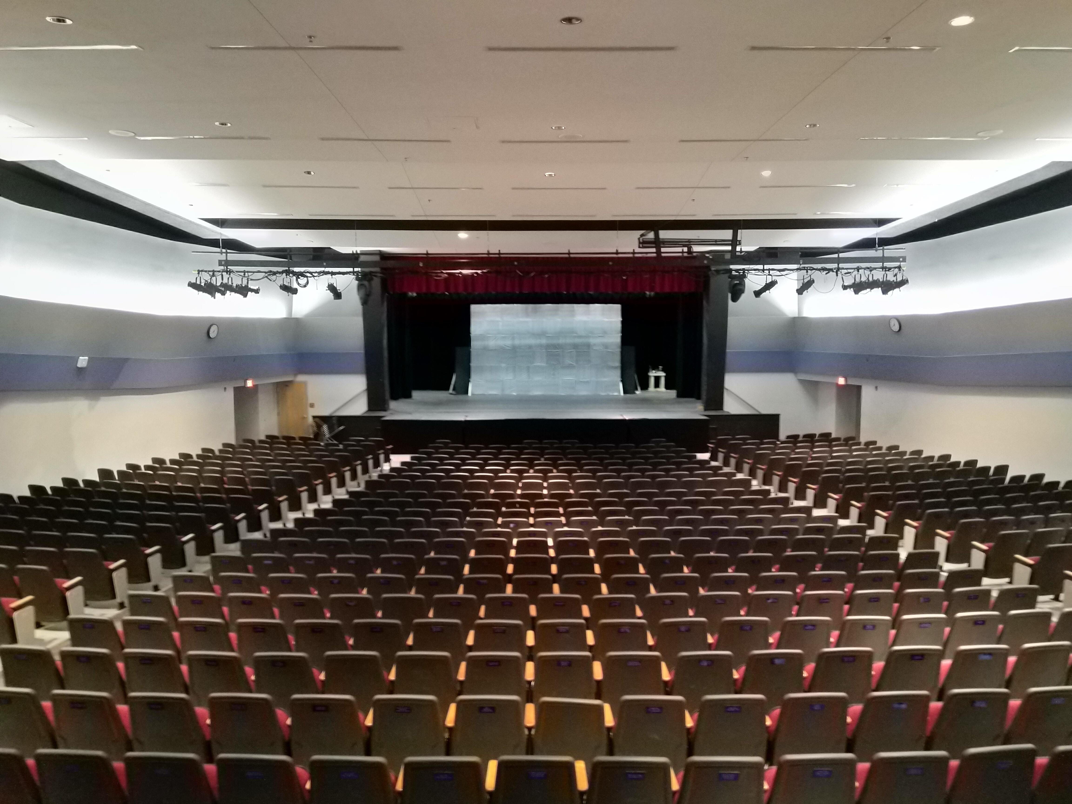
media/pictures/finished_2.jpg
