asterane/the-grid/media/pictures/finished_3.jpg

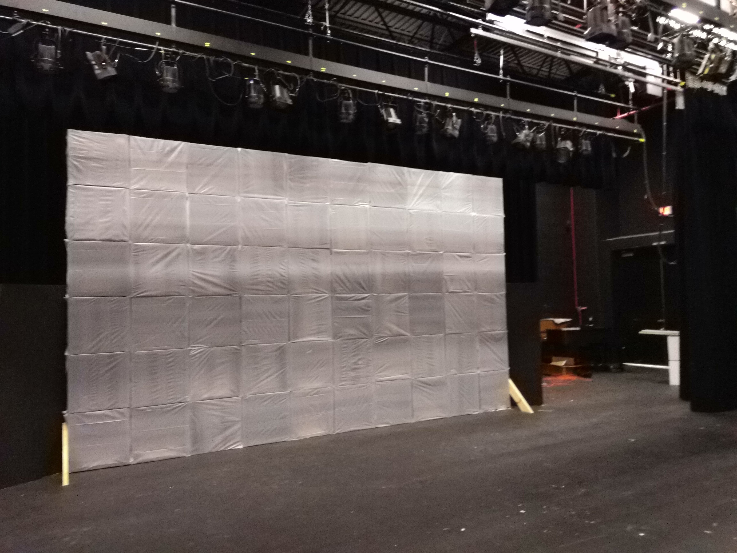
media/pictures/finished_3.jpg
