asterane/the-grid/media/pictures/finished_4.jpg

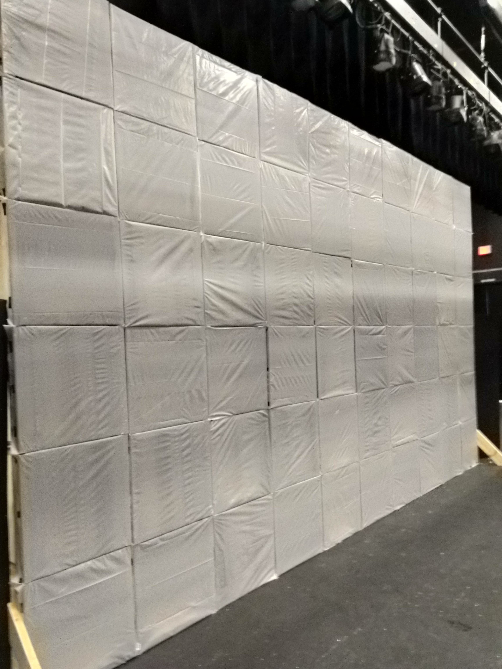
media/pictures/finished_4.jpg
