asterane/the-grid/media/pictures/first_light_1.jpg

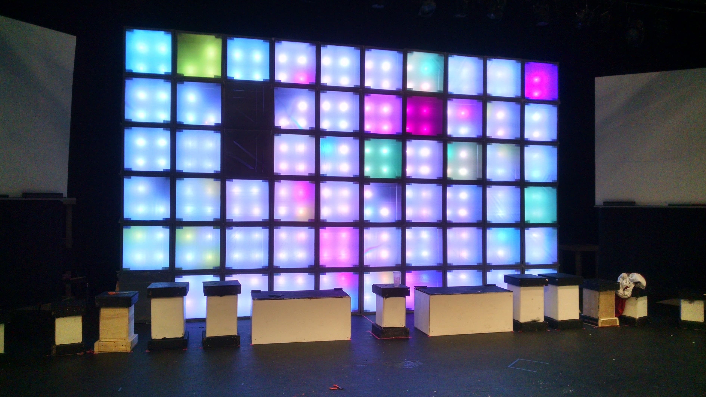
media/pictures/first_light_1.jpg
