asterane/the-grid/media/pictures/first_light_2.jpg

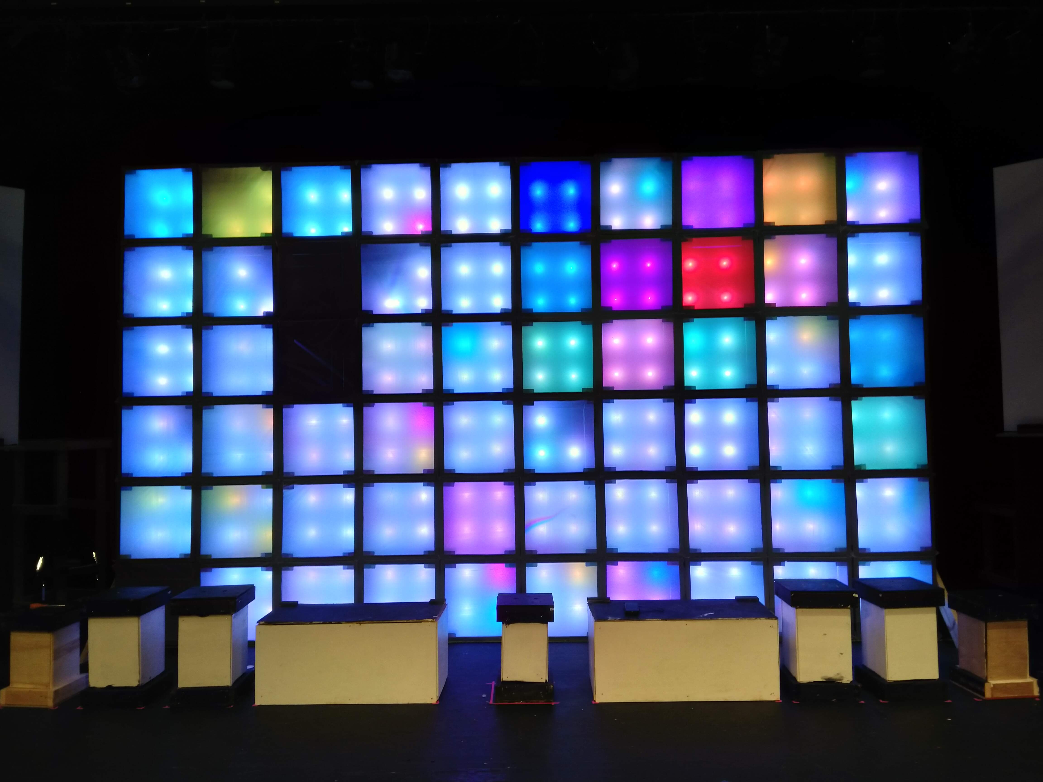
media/pictures/first_light_2.jpg
