asterane/the-grid/media/pictures/first_light_3.jpg

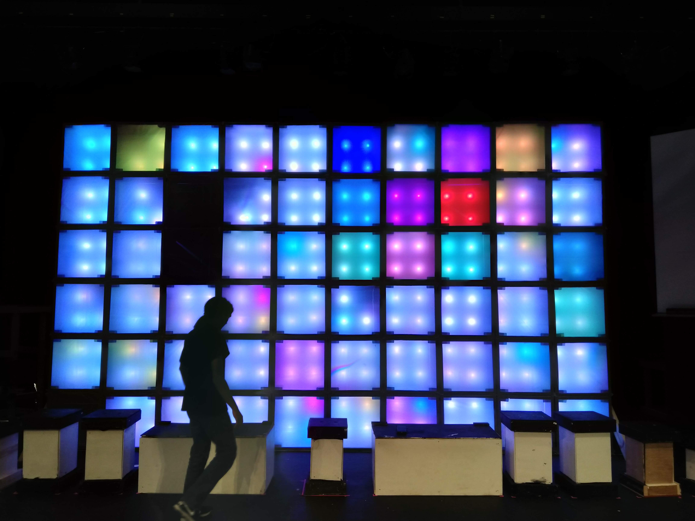
media/pictures/first_light_3.jpg
