asterane/the-grid/media/pictures/first_light_4.jpg

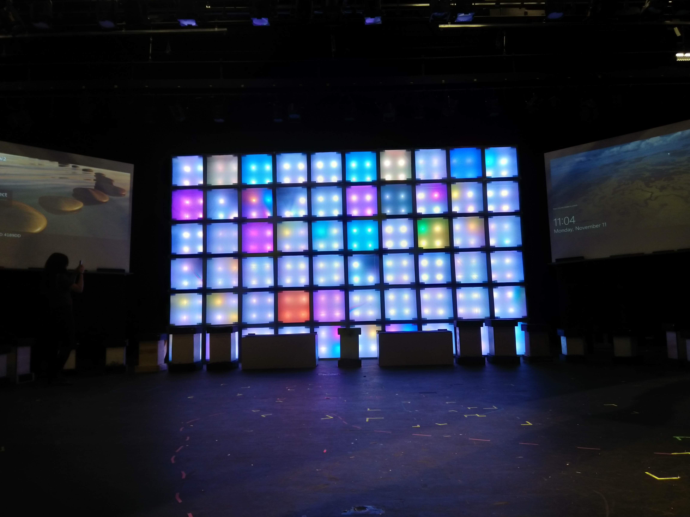
media/pictures/first_light_4.jpg
