asterane/the-grid/media/pictures/first_light_5.jpg

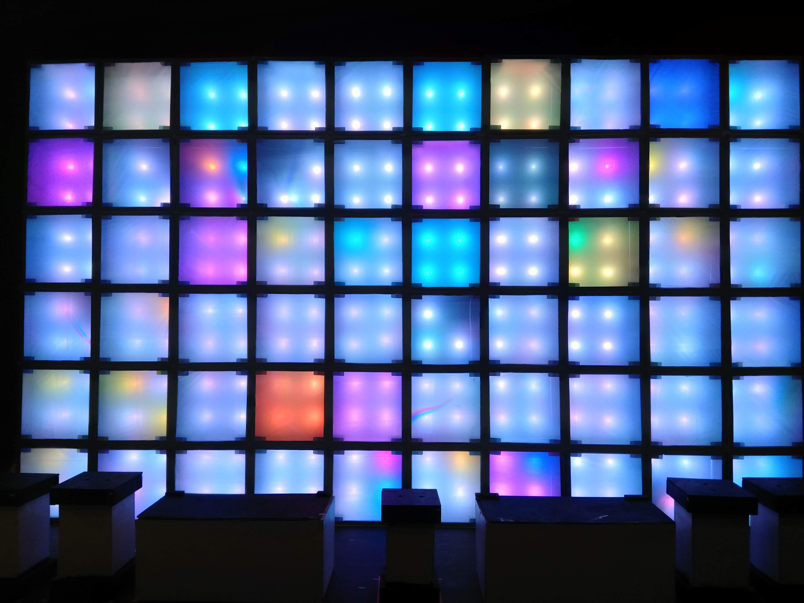
media/pictures/first_light_5.jpg
