asterane/the-grid/media/pictures/flag_1.jpg

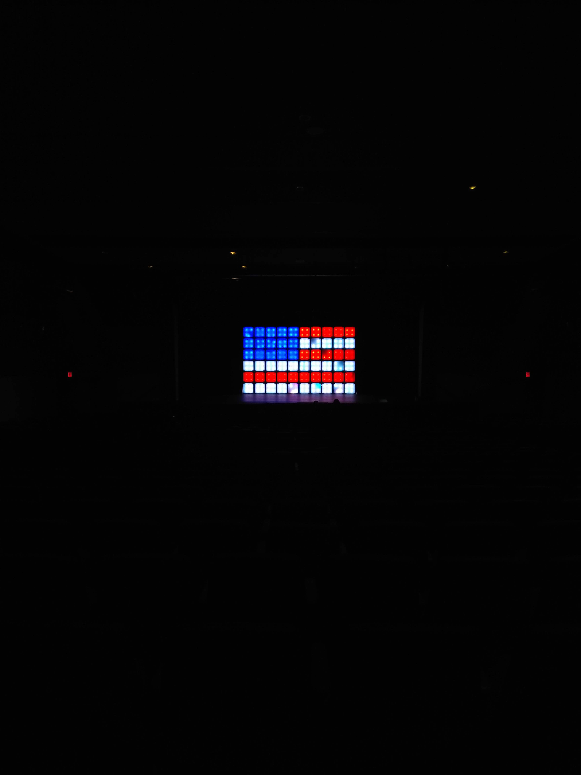
media/pictures/flag_1.jpg
