asterane/the-grid/media/pictures/flag_2.jpg

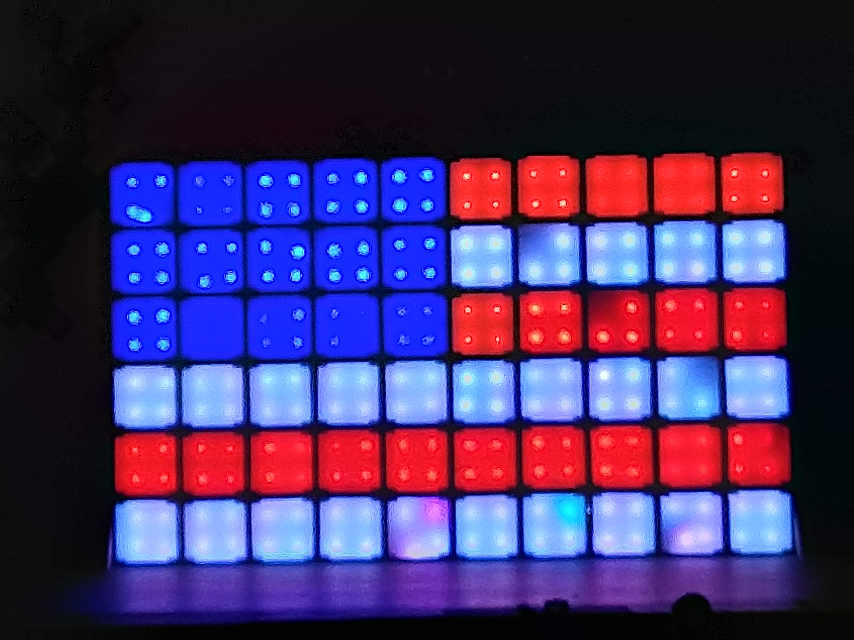
media/pictures/flag_2.jpg
