asterane/the-grid/media/pictures/full_set.jpg

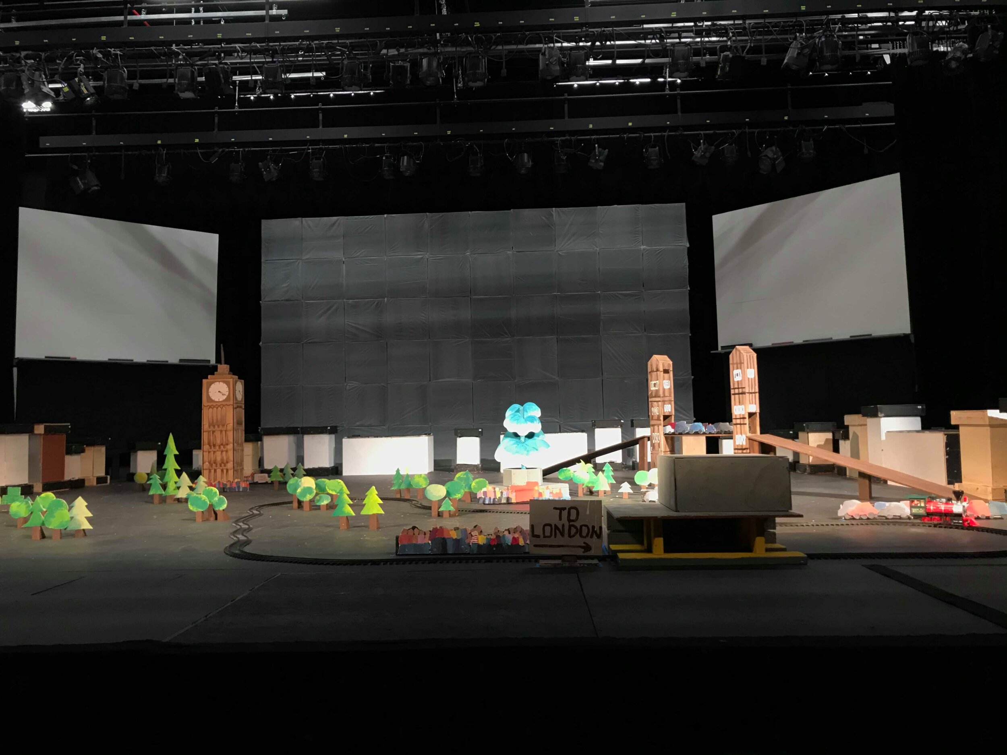
media/pictures/full_set.jpg
