asterane/the-grid/media/pictures/grid.jpg

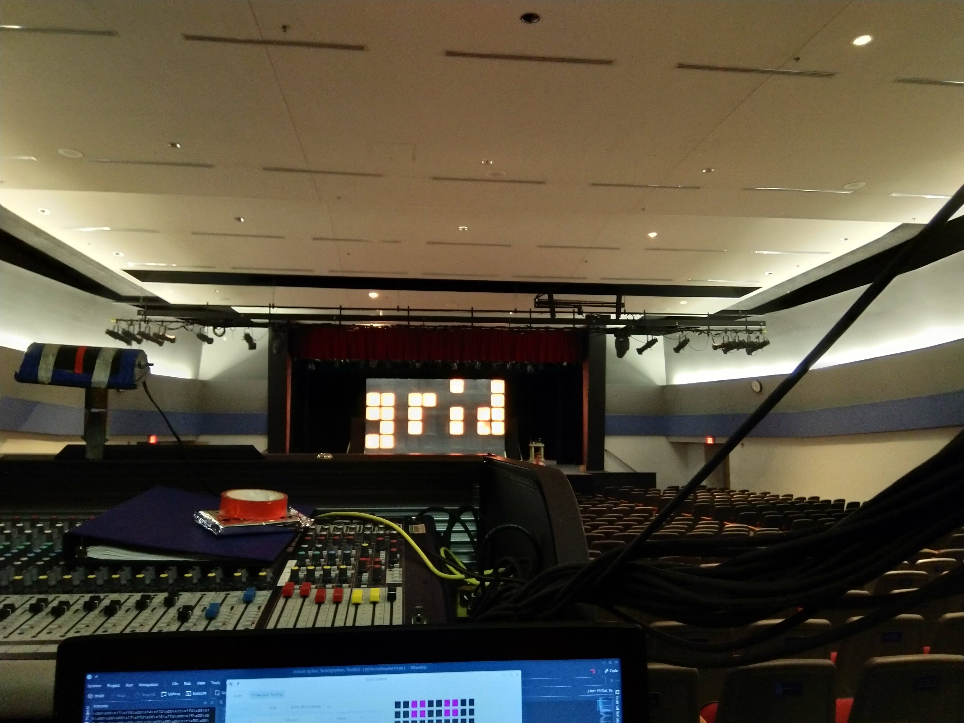
media/pictures/grid.jpg
