asterane/the-grid/media/pictures/group_shot.jpg

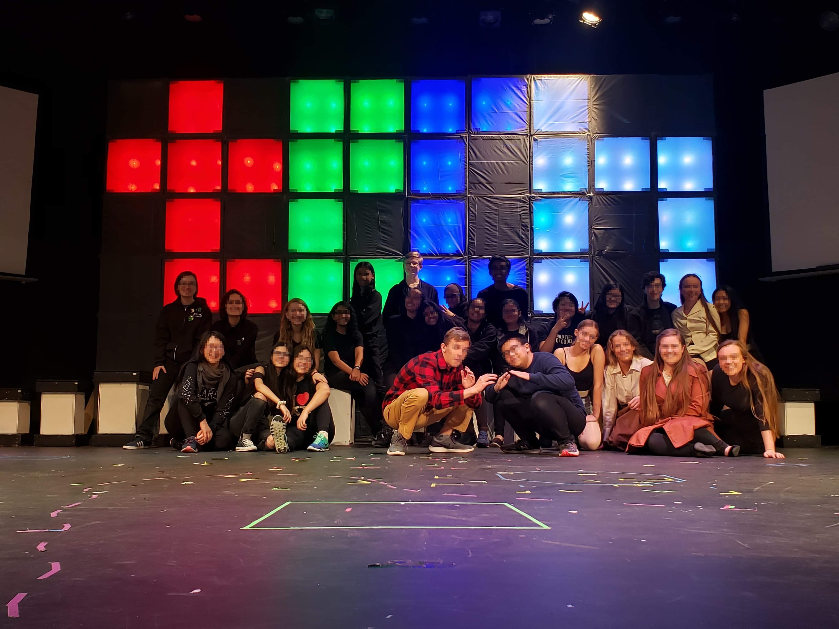
media/pictures/group_shot.jpg
