asterane/the-grid/media/pictures/heart.jpg

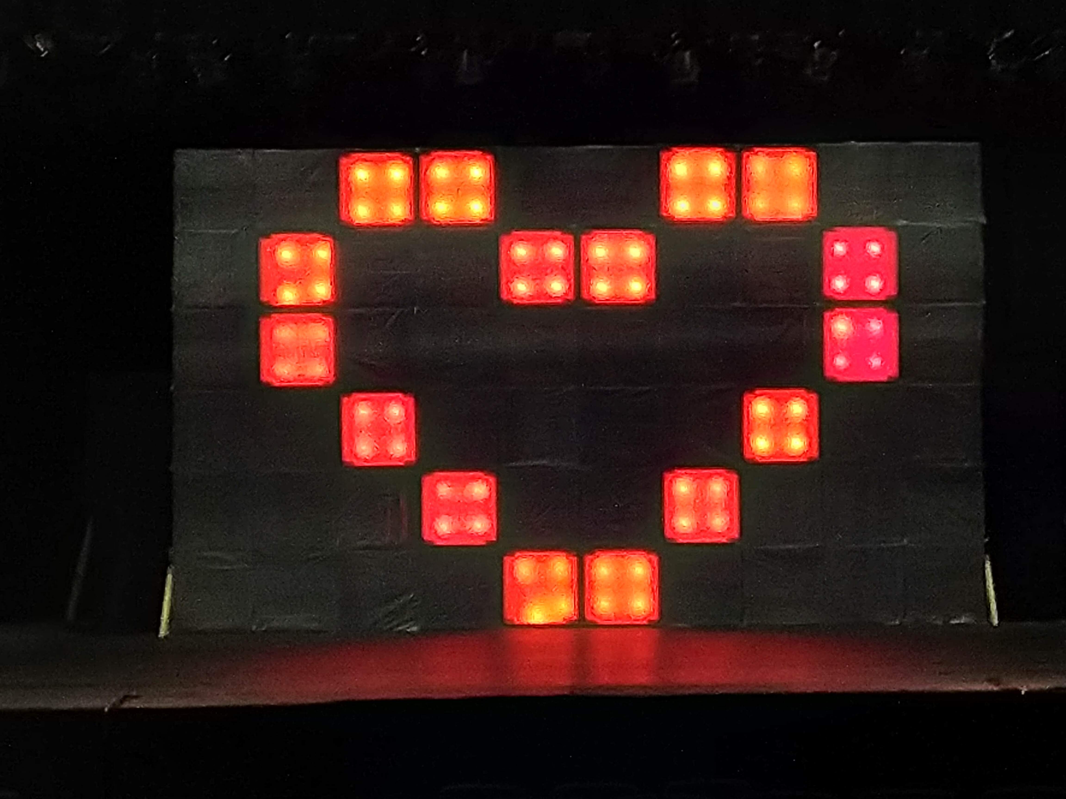
media/pictures/heart.jpg
