asterane/the-grid/media/pictures/purple.jpg

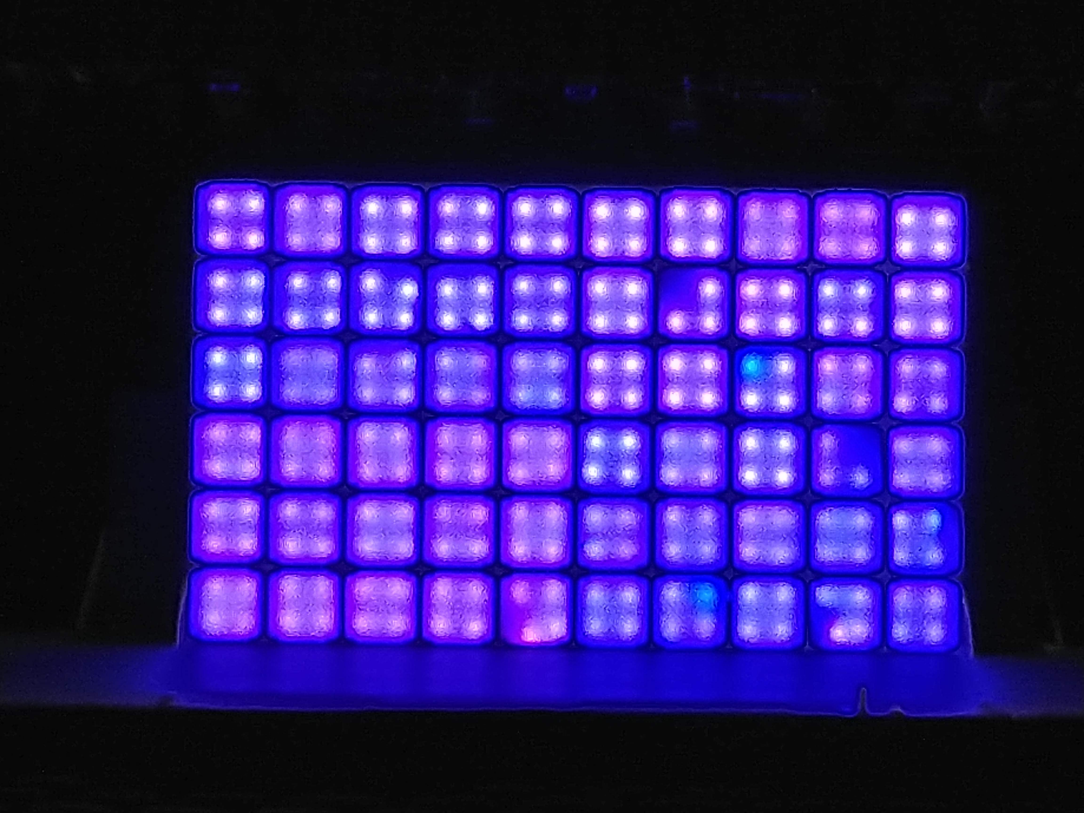
media/pictures/purple.jpg
