asterane/the-grid/media/pictures/rain.jpg

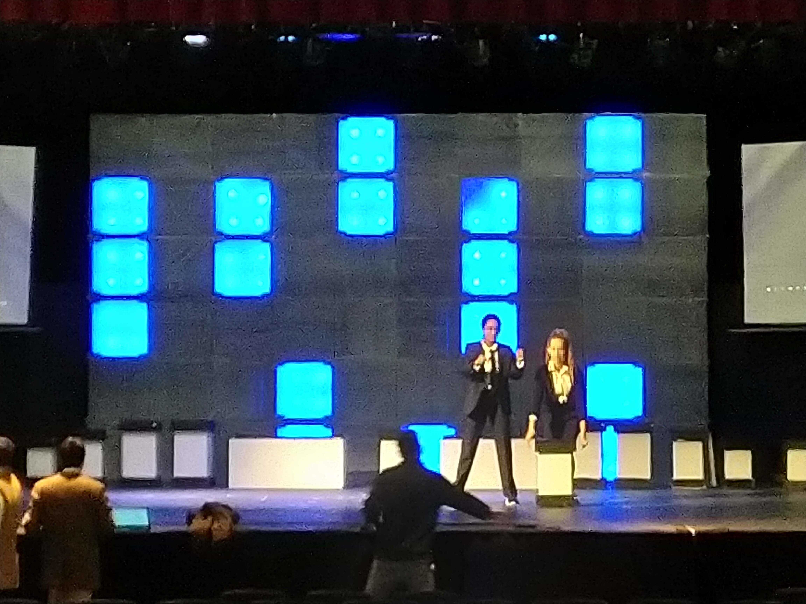
media/pictures/rain.jpg
