asterane/the-grid/media/pictures/tech.jpg

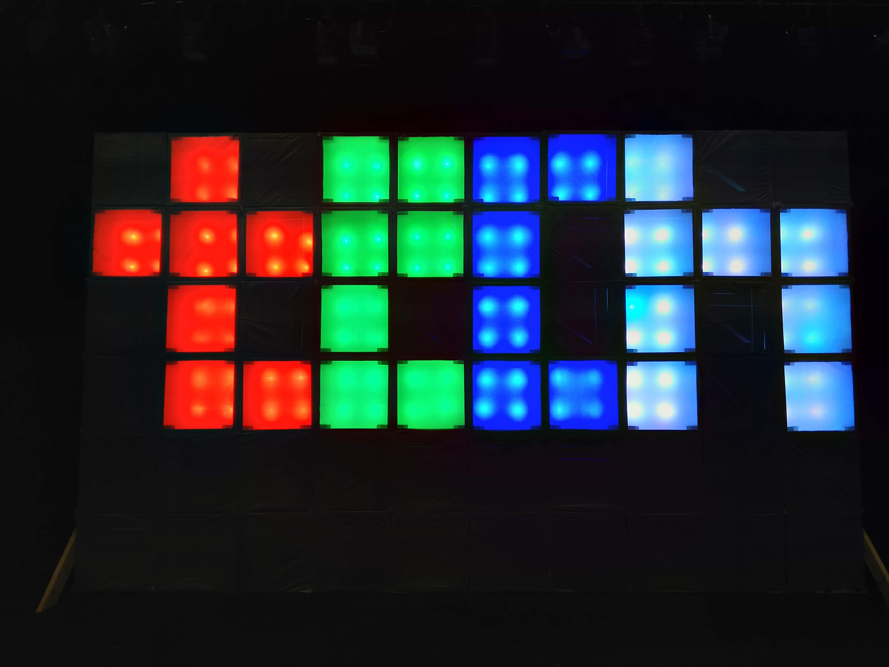
media/pictures/tech.jpg
