asterane/the-grid/media/pictures/the_end.jpg

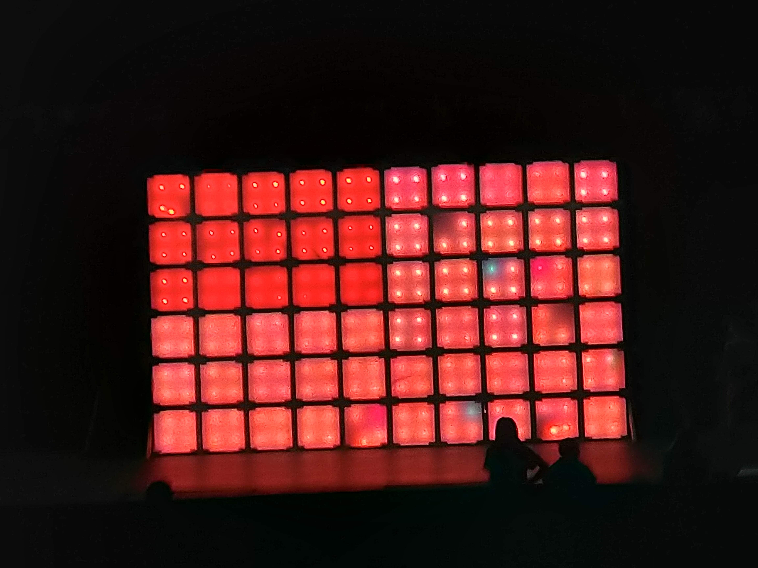
media/pictures/the_end.jpg
