asterane/the-grid/media/pictures/yeet_1.jpg

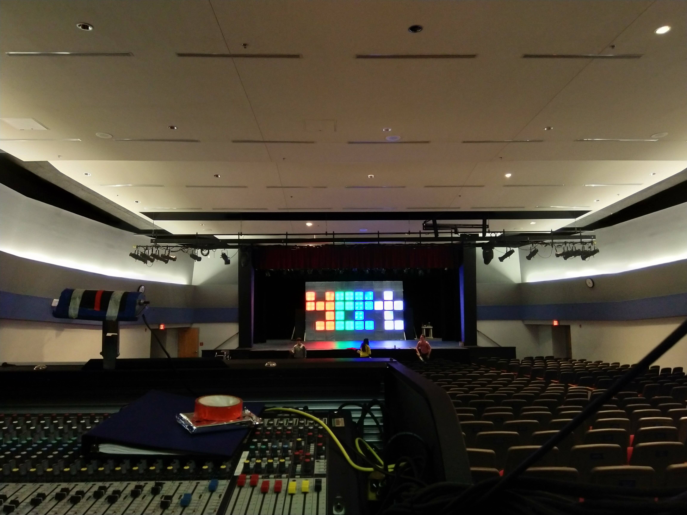
media/pictures/yeet_1.jpg
