asterane/the-grid/media/pictures/yeet_2.jpg

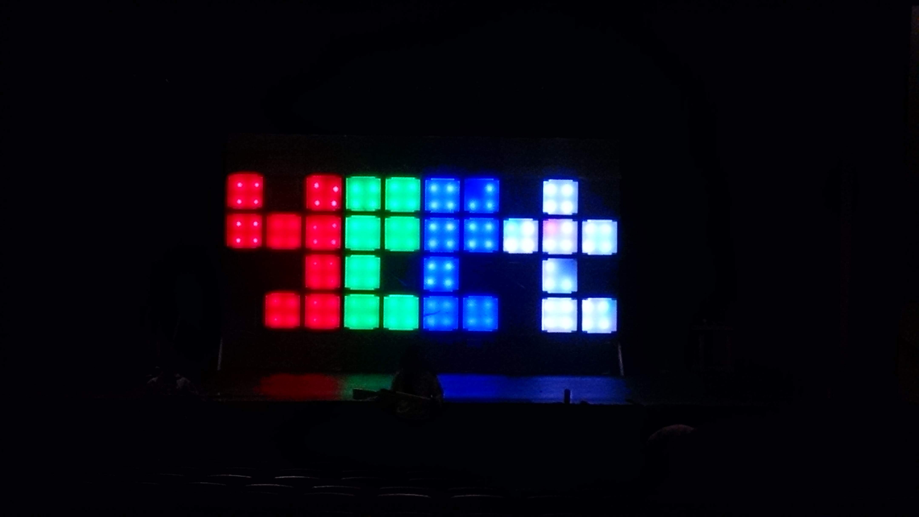
media/pictures/yeet_2.jpg
