asterane/the-grid/software/adobe_rgb.jpg

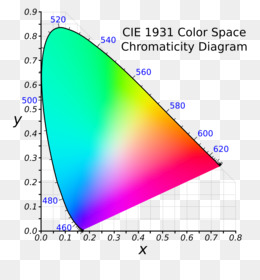
software/adobe_rgb.jpg
