asterane/the-grid/structure/cubes_1.jpg

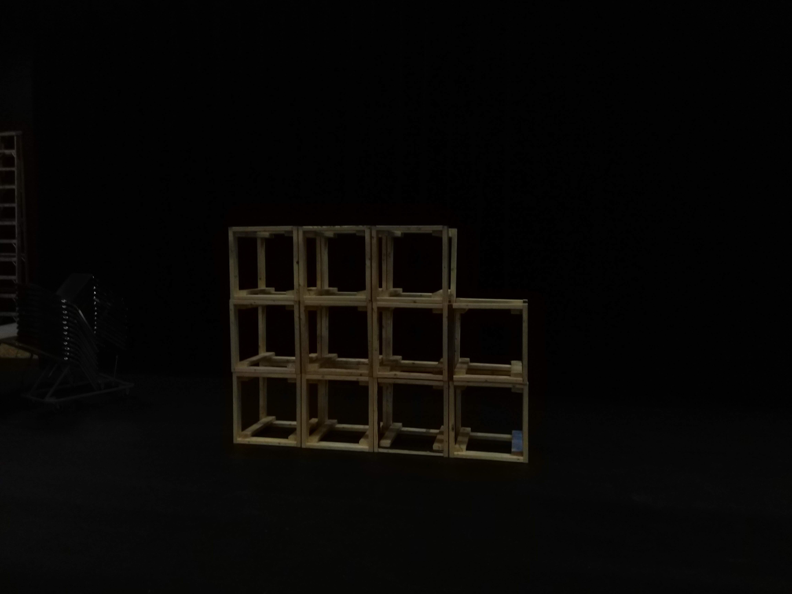
structure/cubes_1.jpg
