asterane/the-grid/structure/cubes_2.jpg

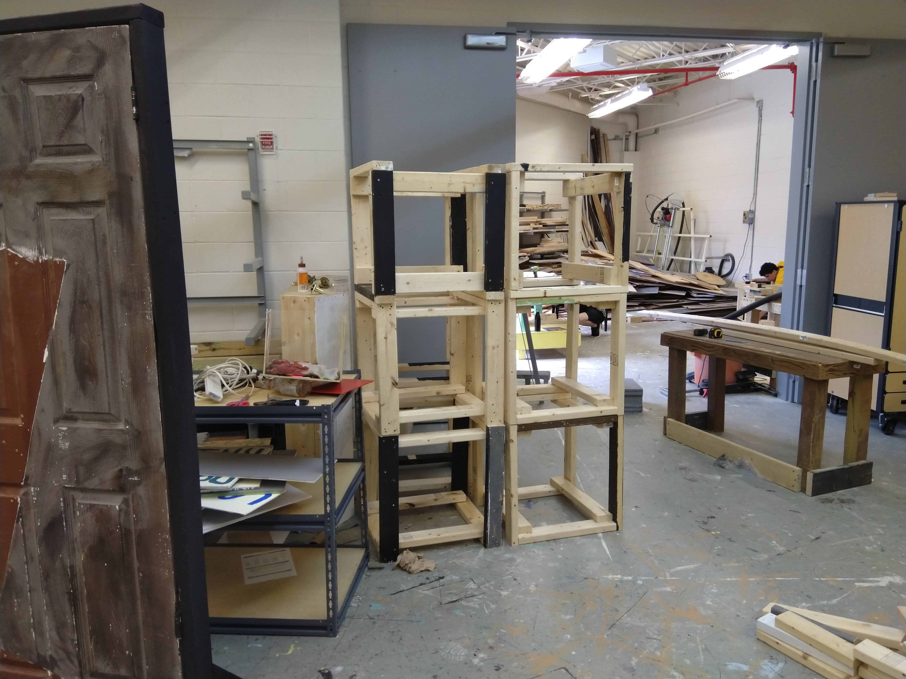
structure/cubes_2.jpg
