asterane/the-grid/structure/cubes_3.jpg

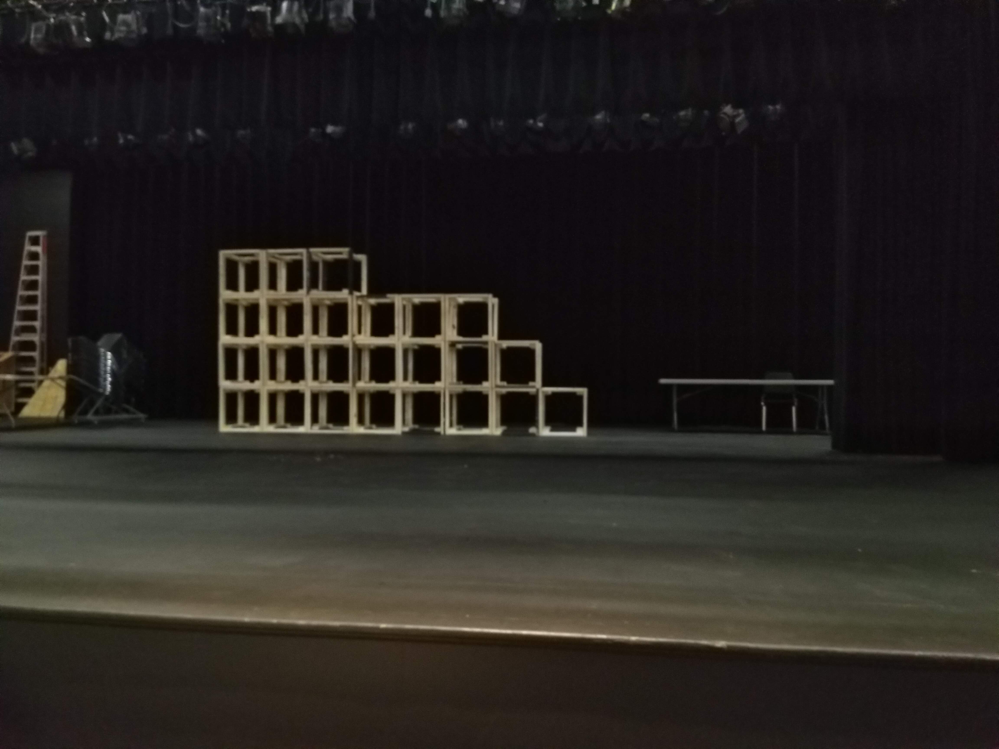
structure/cubes_3.jpg
