asterane/the-grid/structure/cubes_4.jpg

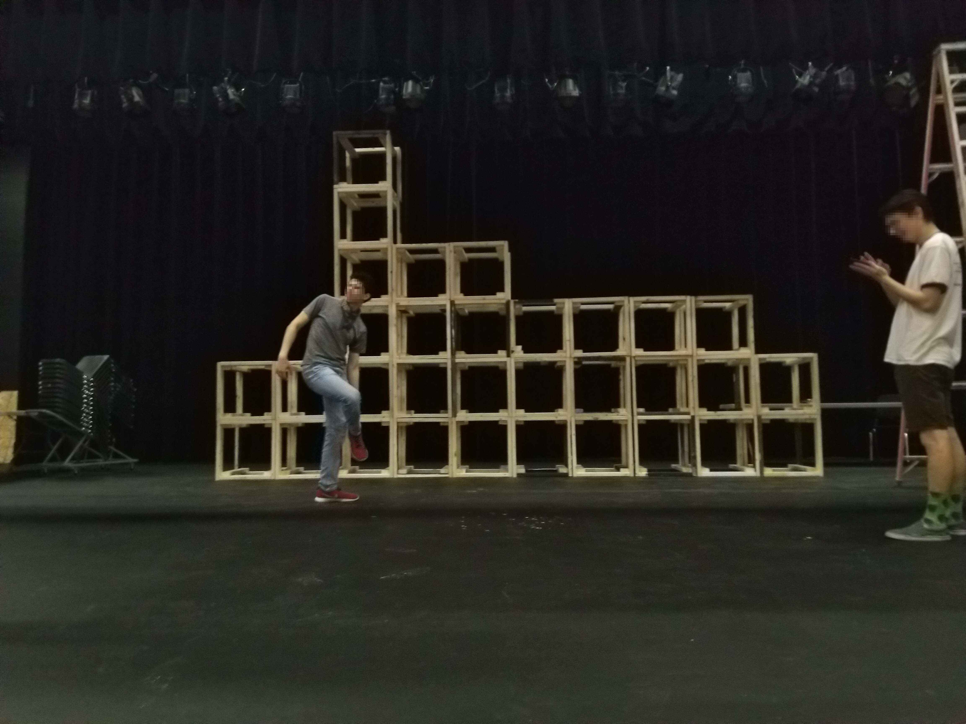
structure/cubes_4.jpg
