asterane/the-grid/structure/cubes_5.jpg

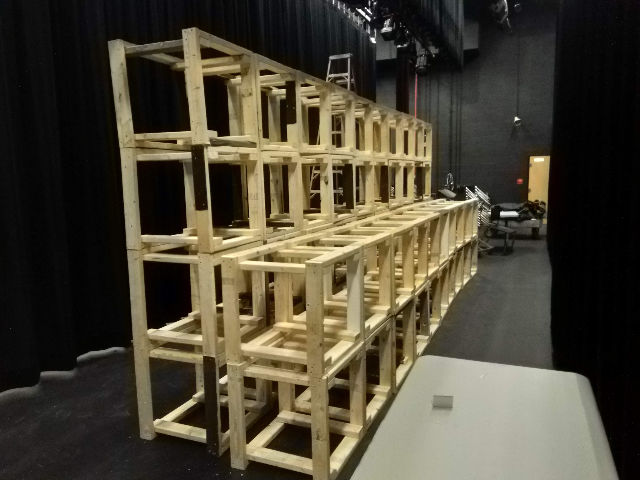
structure/cubes_5.jpg
