asterane/the-grid/structure/cubes_6.jpg

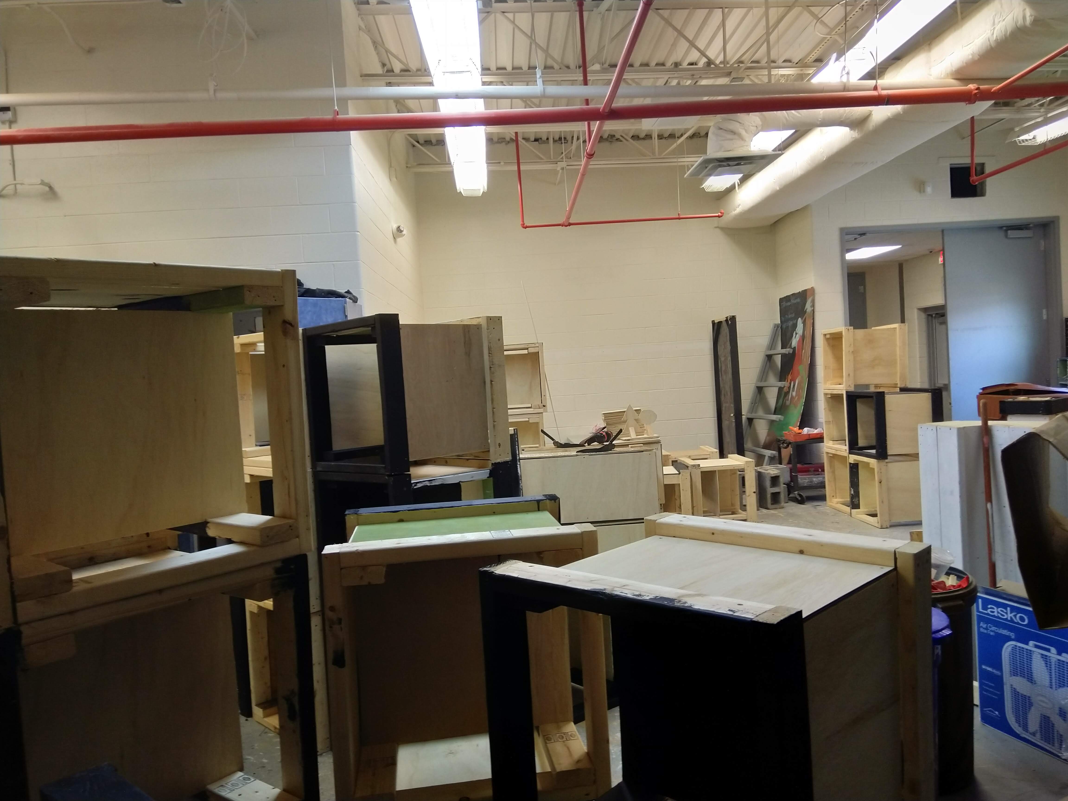
structure/cubes_6.jpg
