asterane/the-grid/structure/cubes_7.jpg

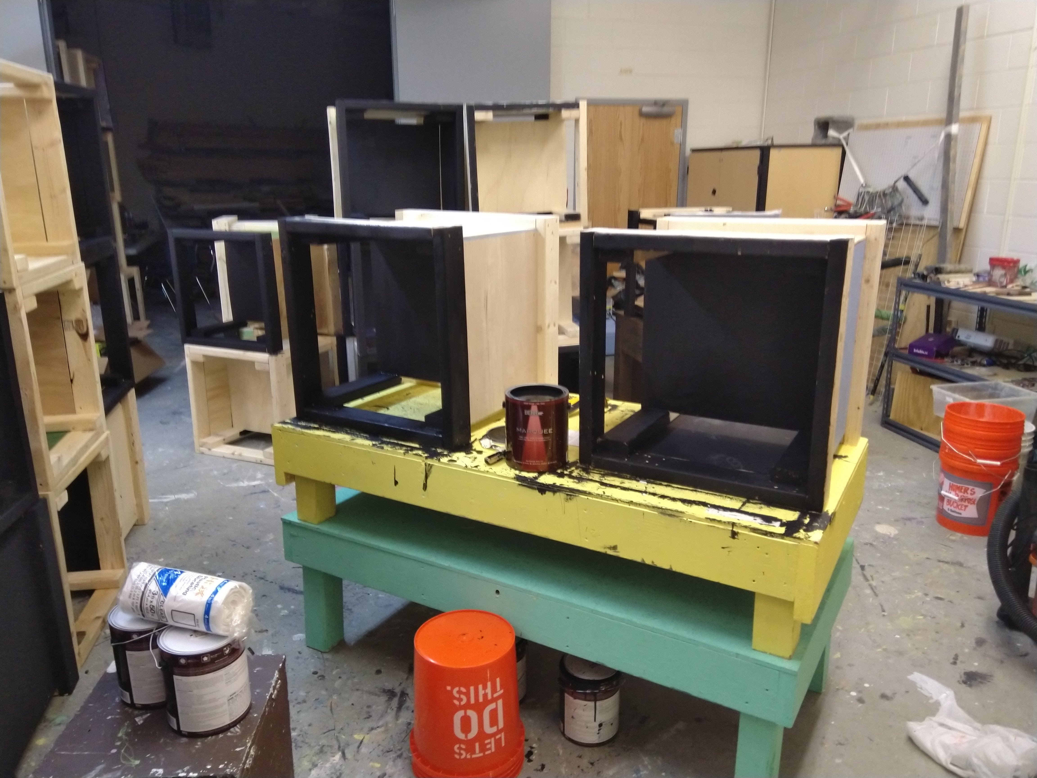
structure/cubes_7.jpg
