asterane/the-grid/structure/grid_1.jpg

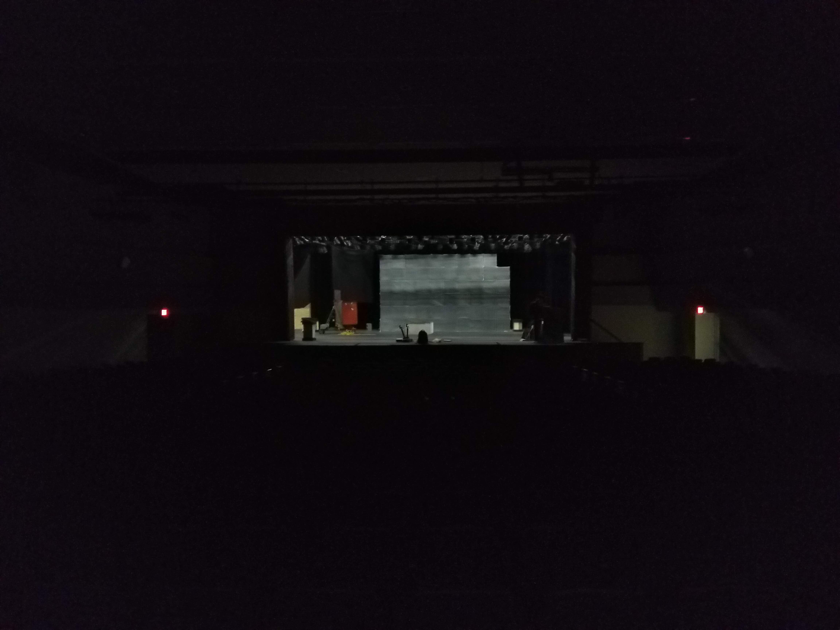
structure/grid_1.jpg
