asterane/the-grid/structure/grid_2.jpg

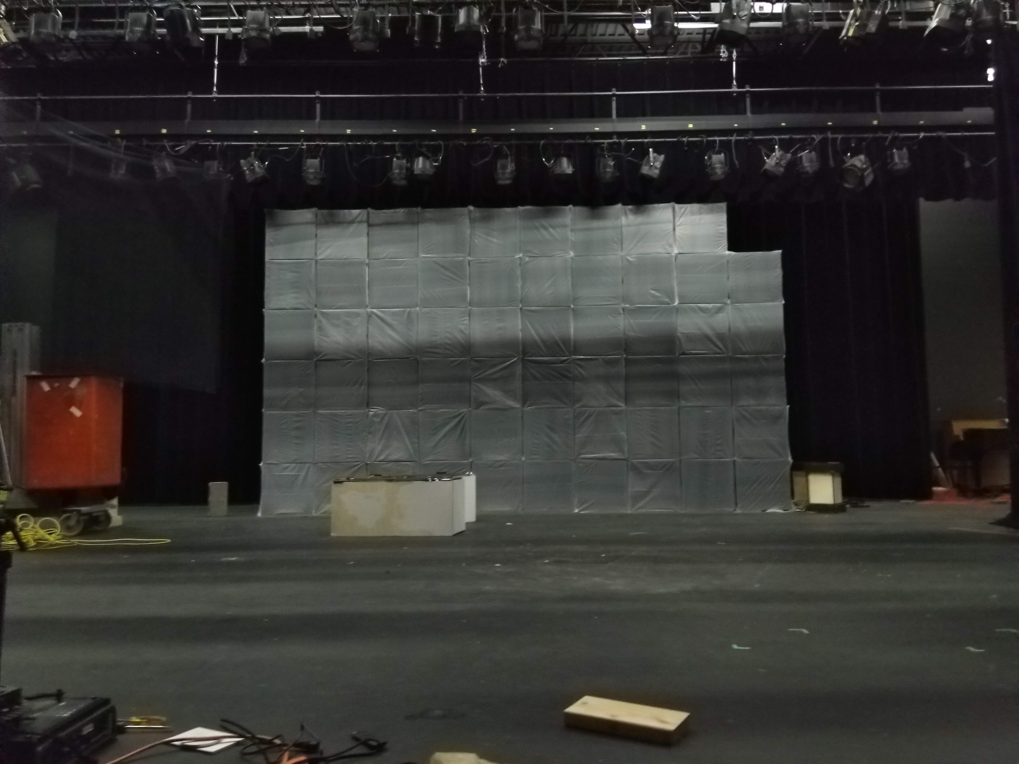
structure/grid_2.jpg
