asterane/the-grid/structure/grid_4.jpg

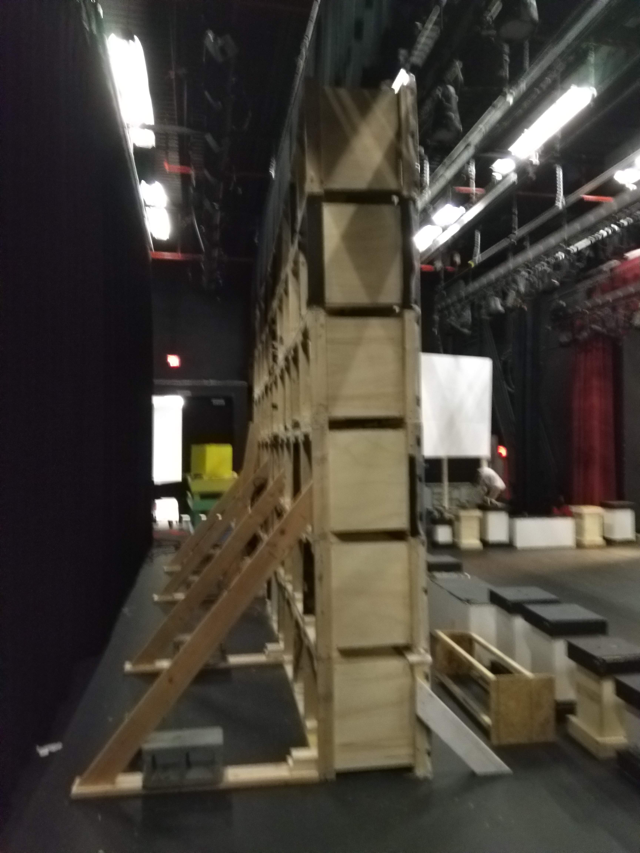
structure/grid_4.jpg
