asterane/the-grid/structure/grid_5.jpg

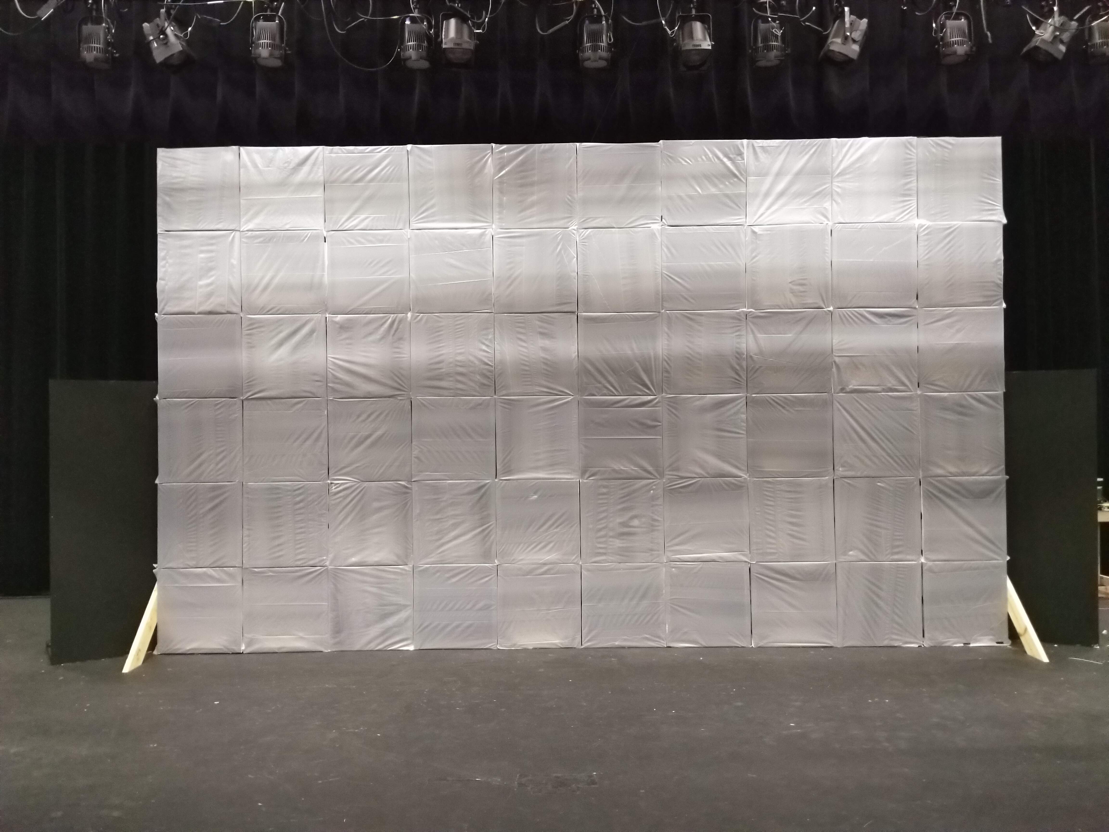
structure/grid_5.jpg
