asterane/the-grid/structure/props.jpg

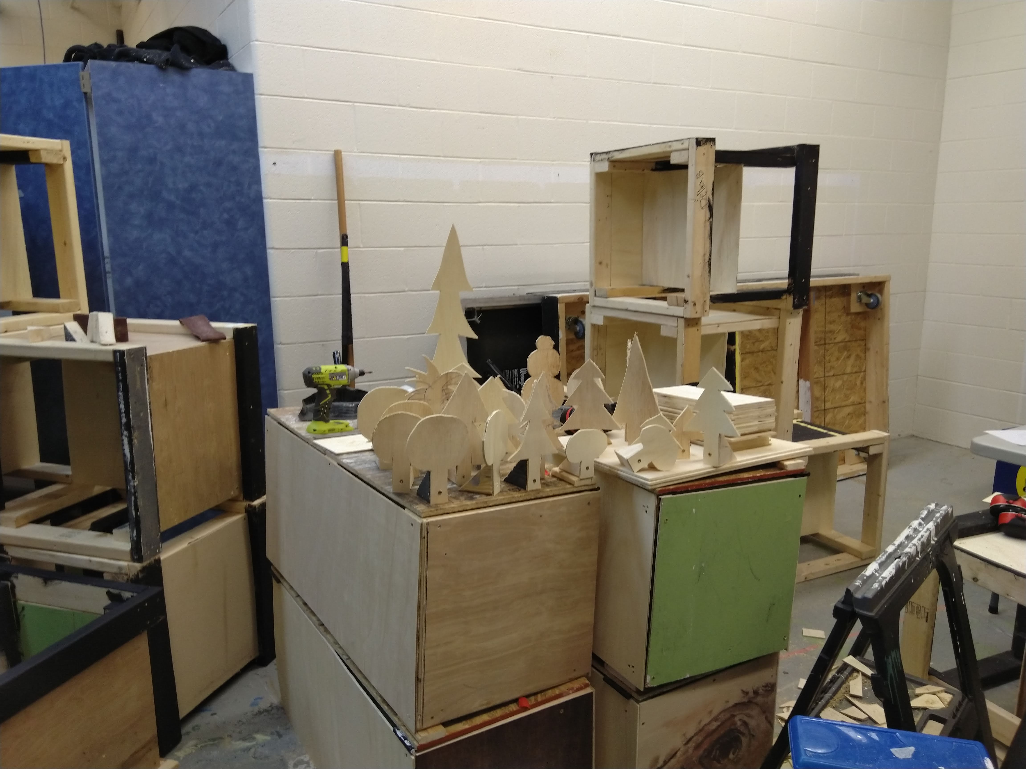
structure/props.jpg
