asterane/the-grid/structure/stage_render.png

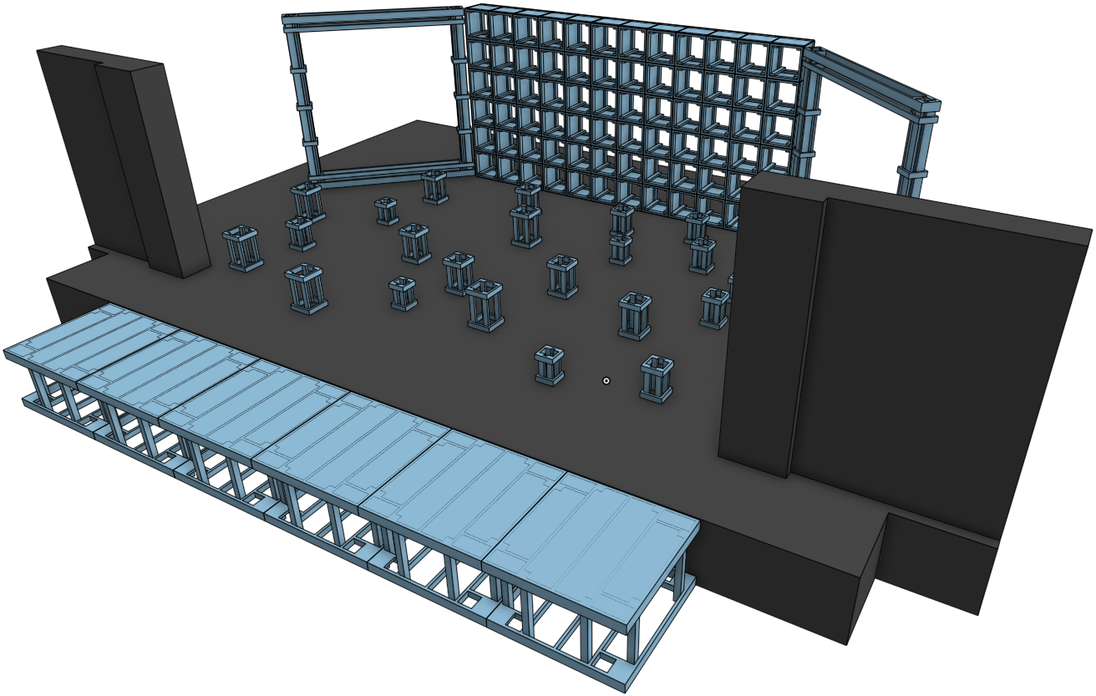
structure/stage_render.png
