asterane/the-grid/structure/support.png

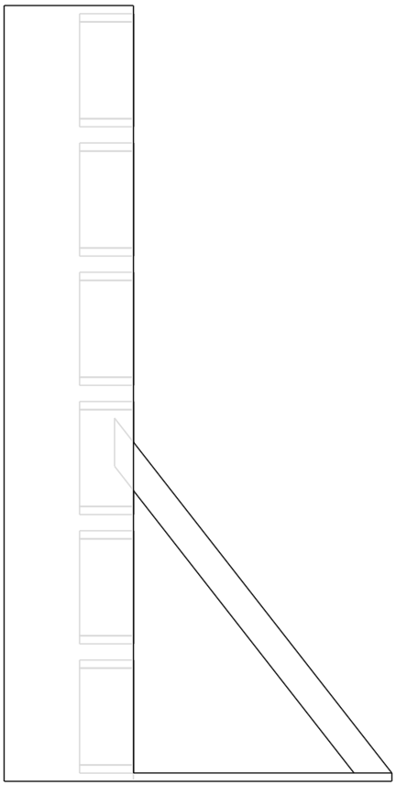
structure/support.png
