asterane/the-grid/structure/teardown_1.jpg

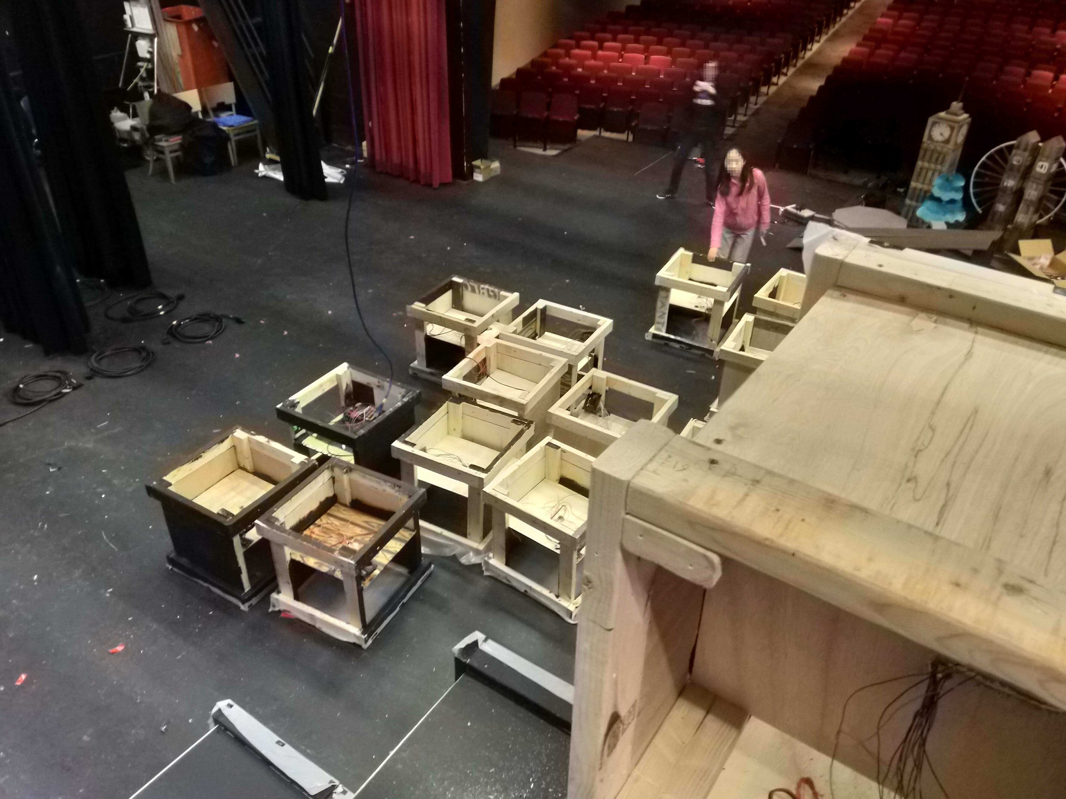
structure/teardown_1.jpg
