asterane/the-grid/structure/teardown_2.jpg

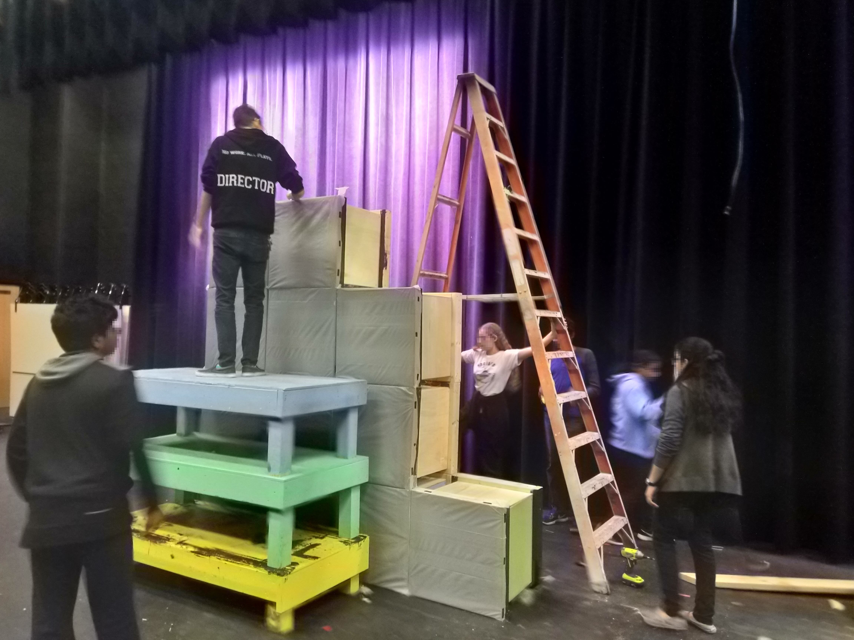
structure/teardown_2.jpg
