asterane/the-grid/structure/teardown_3.jpg

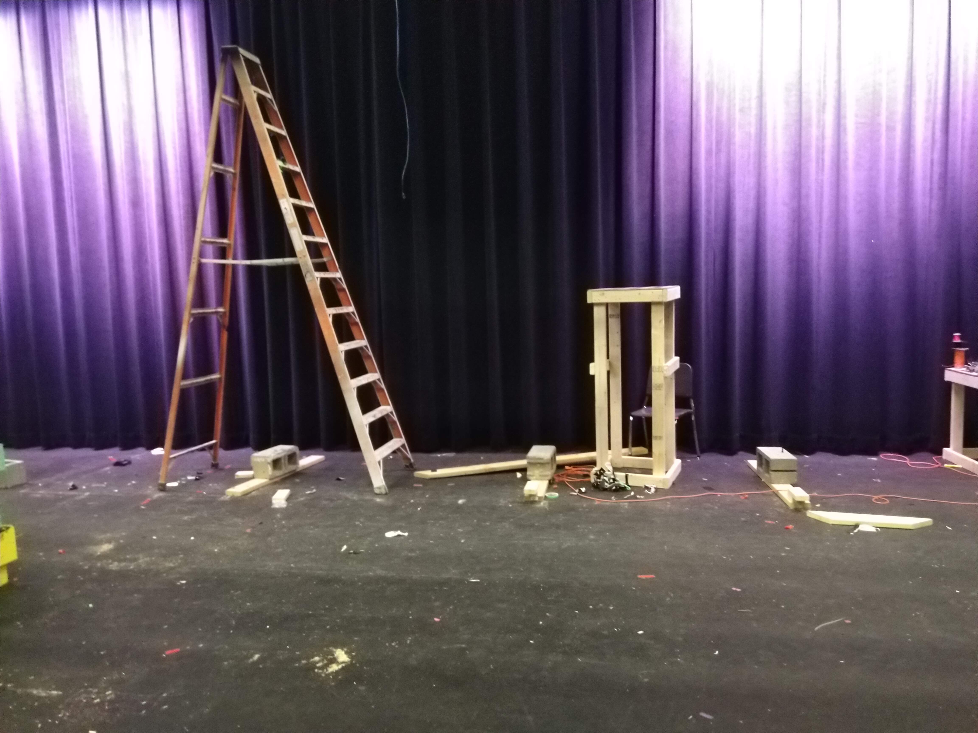
structure/teardown_3.jpg
