asterane/the-grid/structure/teardown_4.jpg

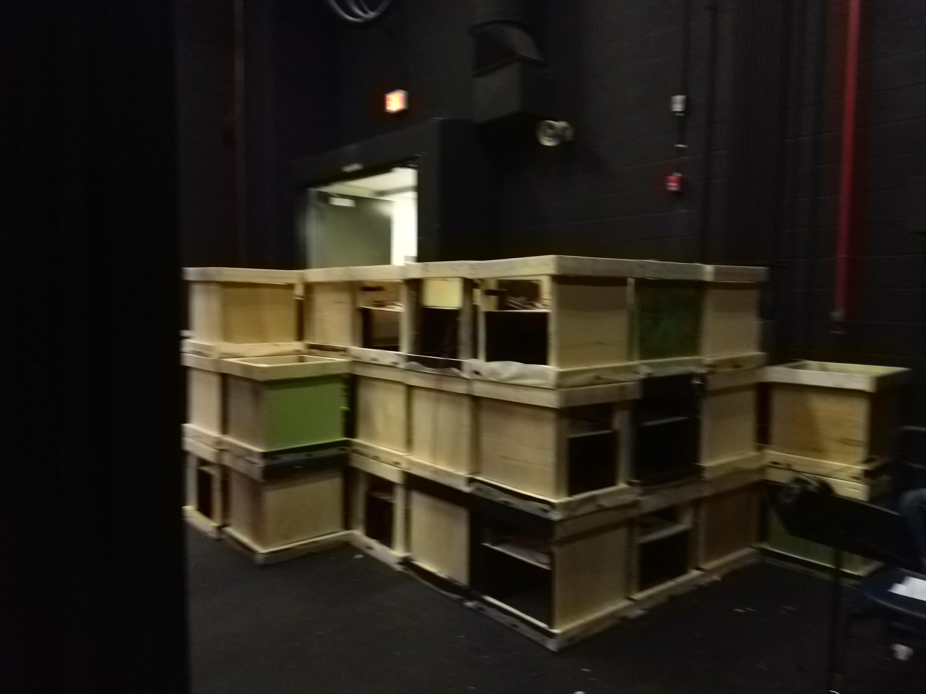
structure/teardown_4.jpg
