asterane/the-grid/Bill of Materials.ods

Item | Price | Quantity | Total | Link
ROUND 1
3W RGB LED | $2.36 | 250 | $590.00 | https://www.adafruit.com/product/2530
Arduino MEGA 2560 | $9.99 | 4 | $39.96 | https://www.microcenter.com/product/486545/inland-arduino-mega-2560
Raspberry Pi 4 2GB | $45.00 | 1 | $45.00 | https://www.microcenter.com/product/608436/4-model-b---2gb-ddr4
Raspberry Pi 4 15W supply | $9.99 | 1 | $9.99 | https://www.microcenter.com/product/608170/4-official-15w-power-supply-us---black
32GB microSDHC card | $3.49 | 1 | $3.49 | https://www.microcenter.com/product/485584/32gb-microsdhc-class-10-flash-memory-card
Raspberry Pi 4 case | $7.99 | 1 | $7.99 | https://www.microcenter.com/product/608178/4-official-case---red-white
Raspberry Pi heat sinks | $3.99 | 1 | $3.99 | https://www.microcenter.com/product/505079/low-profile-aluminum-heat-sink-for-raspberry-pi---2-piece
1.5 ohm resistor | $0.02 | 750 | $13.50 | https://www.mouser.com/ProductDetail/Yageo/CFR-25JR-52-1R5
100k ohm resistor | $0.02 | 750 | $13.50 | https://www.mouser.com/ProductDetail/Yageo/CFR-25JR-52-100K
IGFET transistor | $0.13 | 750 | $96.75 | https://www.mouser.com/ProductDetail/ON-Semiconductor-Fairchild/BS170
BJT transistor | $0.06 | 750 | $42.00 | https://www.mouser.com/ProductDetail/ON-Semiconductor-Fairchild/2N3904BU
10 perfboard plates | $4.95 | 4 | $19.80 | https://www.adafruit.com/product/2670
100ft white 24 AWG wire | $7.58 | 2 | $15.16 | https://bulkwire.com/solid-hookup-wire-300volt-ul1007
100ft black 24 AWG wire | $7.58 | 2 | $15.16 | https://bulkwire.com/solid-hookup-wire-300volt-ul1007
100ft orange 24 AWG wire | $7.58 | 2 | $15.16 | https://bulkwire.com/solid-hookup-wire-300volt-ul1007
100ft red 24 AWG wire | $7.58 | 2 | $15.16 | https://bulkwire.com/solid-hookup-wire-300volt-ul1007
100ft green 24 AWG wire | $7.58 | 2 | $15.16 | https://bulkwire.com/solid-hookup-wire-300volt-ul1007
100ft blue 24 AWG wire | $7.58 | 2 | $15.16 | https://bulkwire.com/solid-hookup-wire-300volt-ul1007
250ft red/black 16 AWG zip wire | $75.96 | 1 | $75.96 | https://bulkwire.com/red-black-bonded-zip-cord
50g 0.6mm solder | $7.59 | 3 | $22.77 | https://www.amazon.com/WYCTIN-Solder-Electrical-Soldering-0-11lbs/dp/B071G1J3W6/
100ft 12/3 AWG cable | $110.00 | 1 | $110.00 | https://www.amazon.com/12-Bulk-Cable-3-Wire-Electrical/dp/B004749P38/
20A 125V stage pin connector | $10.40 | 10 | $104.00 | https://www.amazon.com/Marinco-20M-Bates-Stage-Inline/dp/B00E4Q64CO/
12V 30A power supply | $17.98 | 10 | $179.80 | https://www.amazon.com/MENZO-Universal-Regulated-Switching-Computer/dp/B06VWV5YCH/
2 position screw terminal block | $0.41 | 65 | $26.46 | https://www.mouser.com/ProductDetail/TE-Connectivity/796949-2
20 position SIP socket | $0.74 | 65 | $47.91 | https://www.mouser.com/ProductDetail/Mill-Max/310-47-120-41-001000
Solder flux pen | $7.99 | 1 | $7.99 | https://www.amazon.com/SRA-Soldering-Products-PEN_RMA-99-20/dp/B008OC3VMU/
Solder removal tools | $8.98 | 1 | $8.98 | https://www.amazon.com/Desoldering-Solder-Sucker-Length-Remover/dp/B07BB8DGMP/
Weller digital soldering station | $116.00 | 3 | $348.00 | https://www.amazon.com/Weller-WE1010NA-Digital-Soldering-Station/dp/B077JDGY1J/
5 Weller ETM soldering tips | $12.98 | 1 | $12.98 | https://www.amazon.com/Quality-Replacement-WELLER-WESD51-WE1010NA/dp/B07FXGXBNT/
Wire stripper 20-30 AWG | $18.29 | 2 | $36.58 | https://www.amazon.com/Stripper-Stranded-Klein-Tools-11057/dp/B000XEUPMQ/
Wire stripper 10-18 AWG | $19.54 | 1 | $19.54 | https://www.amazon.com/Stripper-Stranded-Klein-Tools-11057/dp/B00080DPNQ/
Needlenose pliers | $9.99 | 3 | $29.97 | https://www.amazon.com/Professional-Flat-Needle-Pliers-5-Inch/dp/B071ZMRZBG/
3 Anti-static wrist straps | $7.09 | 1 | $7.09 | https://www.amazon.com/Anti-Static-Wrist-Straps-Anti-Static/dp/B017164JHA
Brass solder tip cleaner | $10.95 | 3 | $32.85 | https://www.adafruit.com/product/1172
Soldering vise | $27.24 | 3 | $81.72 | https://www.amazon.com/PanaVise-Model-Junior-Miniature-Premium/dp/B07PZCRVF6
Soldering helping hand | $6.00 | 3 | $18.00 | https://www.adafruit.com/product/291
Total |  |  | $2,147.52
ROUND 2
IRFZ24 power transistor | $0.34 | 750 | $253.50 | https://www.mouser.com/ProductDetail/Infineon-Technologies/IRFZ24NPBF
2N3904 bipolar transistor | $0.14 | 40 | $5.40 | https://www.mouser.com/ProductDetail/ON-Semiconductor-Fairchild/2N3904BU
1.5 ohm resistor | $0.05 | 40 | $2.00 | https://www.mouser.com/ProductDetail/Yageo/CFR-25JR-52-1R5
100k ohm resistor | $0.05 | 40 | $2.00 | https://www.mouser.com/ProductDetail/Yageo/CFR-25JR-52-100K
100ft orange 24 AWG wire | $7.58 | 4 | $30.32 | https://bulkwire.com/solid-hookup-wire-300volt-ul1007
100ft white 24 AWG wire | $7.58 | 3 | $22.74 | https://bulkwire.com/solid-hookup-wire-300volt-ul1007
100ft red 24 AWG wire | $7.58 | 3 | $22.74 | https://bulkwire.com/solid-hookup-wire-300volt-ul1007
100ft green 24 AWG wire | $7.58 | 3 | $22.74 | https://bulkwire.com/solid-hookup-wire-300volt-ul1007
100ft blue 24 AWG wire | $7.58 | 3 | $22.74 | https://bulkwire.com/solid-hookup-wire-300volt-ul1007
10 perfboard plates | $4.95 | 3 | $14.85 | https://www.adafruit.com/product/2670
100 orange twist connectors | $6.32 | 1 | $6.32 | https://www.amazon.com/Orange-Wire-Connector-Twist-Ribbed/dp/B01L0GFV10/
Micro HDMI to HDMI cable | $5.98 | 1 | $5.98 | https://www.amazon.com/Rankie-Micro-Supports-Ethernet-Return/dp/B00Z07JYLE/
USB A to B cable 15 ft | $8.99 | 4 | $35.96 | https://www.amazon.com/UGREEN-Printer-Scanner-Brother-Lexmark/dp/B00P0FO0ZG/
50g 0.6mm solder | $7.59 | 5 | $37.95 | https://www.amazon.com/WYCTIN-Solder-Electrical-Soldering-0-11lbs/dp/B071G1J3W6/
3 anti-static wrist straps | $7.09 | 1 | $7.09 | https://www.amazon.com/Anti-Static-Wrist-Straps-Anti-Static/dp/B017164JHA/
3 - 120mm cooling fans | $9.99 | 2 | $19.98 | https://www.amazon.com/uphere-3-Pack-Computer-120mm-Cooling/dp/B072LDYKQ6/
Total |  |  | $512.31
ROUND 3
100g 0.6mm solder | $9.59 | 3 | $28.77 | https://www.amazon.com/MAIYUM-63-37-Solder-Electrical-Soldering/dp/B076QD1W9X/
Molex pin housing (6.7mm) | $0.30 | 66 | $19.87 | https://www.mouser.com/ProductDetail/Molex/19-09-2029?qs=LQQHZ4xw2XC5dznzjhhjnQ%3D%3D
Molex socket housing (6.7mm) | $0.32 | 66 | $21.05 | https://www.mouser.com/ProductDetail/Molex/19-09-1029?qs=404muyNbhLGM%2FJzO7I4sLA%3D%3D
Terminal pin (14-20 AWG) | $0.11 | 135 | $14.45 | https://www.mouser.com/ProductDetail/?qs=gyiXALOU6QVb%2FFd3LWsjcA%3D%3D
Terminal socket (14-20 AWG) | $0.12 | 135 | $15.66 | https://www.mouser.com/ProductDetail/?qs=hSmm4fxMIuOBwlHgELpuCQ%3D%3D
FASTON 187 terminal (14 AWG) | $0.07 | 100 | $7.20 | https://www.mouser.com/ProductDetail/TE-Connectivity-AMP/2293895-1-Loose-Piece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
Molex universal hand crimper | $57.84 | 1 | $57.84 | https://www.mouser.com/ProductDetail/Molex/63811-1000?qs=u6Gr9%2FNt%252B%2F9oql%252Bd80isUQ%3D%3D
SPST switch (15A) | $1.33 | 11 | $14.63 | https://www.mouser.com/ProductDetail/Marquardt-Switches/18011908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
2.1mm DC power connector | $1.33 | 5 | $6.65 | https://www.mouser.com/ProductDetail/CUI/PP-050A
IRFZ24 power transistor | $0.34 | 100 | $33.80 | https://www.mouser.com/ProductDetail/Infineon-Technologies/IRFZ24NPBF
2N3904 bipolar transistor | $0.06 | 120 | $6.72 | https://www.mouser.com/ProductDetail/ON-Semiconductor-Fairchild/2N3904BU
1.5 ohm resistor | $0.05 | 40 | $2.00 | https://www.mouser.com/ProductDetail/Yageo/CFR-25JR-52-1R5
5.1 ohm resistor | $0.02 | 100 | $1.80 | https://www.mouser.com/ProductDetail/Yageo/CFR-25JB-52-5R1
100k ohm resistor | $0.02 | 100 | $1.80 | https://www.mouser.com/ProductDetail/Yageo/CFR-25JR-52-100K
20 position SIP socket | $0.81 | 10 | $8.14 | https://www.mouser.com/ProductDetail/Mill-Max/310-47-120-41-001000
100 steel M3-0.5 10mm screws | $13.04 | 1 | $13.04 | https://www.amazon.com/Stainless-Machine-Finish-Phillips-Threads/dp/B000FN3NNS/
100 steel M3-0.5 hex nuts | $8.46 | 1 | $8.46 | https://www.amazon.com/Steel-M3-0-5-Threads-Made-Pack/dp/B000NBIH92/
3 - 120mm cooling fans | $9.99 | 20 | $199.80 | https://www.amazon.com/uphere-3-Pack-Computer-120mm-Cooling/dp/B072LDYKQ6/
25 ATC - 15A fuses | $5.39 | 4 | $21.56 | https://www.amazon.com/Baomain-Blade-ATC-15-Fast-Acting-Automotive/dp/B01M62E5M9/
10 ATC fuse holders | $7.09 | 3 | $21.27 | https://www.amazon.com/GENEDEY-Automotive-Standard-Holder-Waterproof/dp/B07QV5TWZZ/
Heat shrink tubing kit | $7.89 | 1 | $7.89 | https://www.amazon.com/625pcs-Shrink-Tubing-Tubes-Ratio/dp/B07QM8249H/
Heat gun | $22.99 | 1 | $22.99 | https://www.amazon.com/SEEKONE-Heat-Gun-Hot-Air/dp/B078S5QMFG/
20 small perfboards | $6.49 | 1 | $6.49 | https://www.amazon.com/HiLetgo-Finished-Prototype-Circuit-Breadboard/dp/B00FXHXT80/
100ft red 24 AWG wire | $7.58 | 1 | $7.58 | https://bulkwire.com/solid-hookup-wire-300volt-ul1007
500ft orange 24 AWG wire | $25.67 | 1 | $25.67 | https://bulkwire.com/solid-hookup-wire-300volt-ul1007
100ft red/black 16 AWG zip wire | $33.77 | 1 | $33.77 | https://bulkwire.com/red-black-bonded-zip-cord
50ft red/black 14 AWG zip wire | $26.77 | 1 | $26.77 | https://bulkwire.com/red-black-bonded-zip-cord
Digital LED voltmeter | $1.75 | 11 | $19.25 | https://www.sparkfun.com/products/14313
Wire stripper 10-18 AWG | $19.54 | 2 | $39.08 | https://www.amazon.com/Stripper-Stranded-Klein-Tools-11057/dp/B00080DPNQ/
Total |  |  | $694.00
TOTAL |  |  | $3,353.83
