asterane/the-grid/electronics/current-sources/new_parts_1.jpg

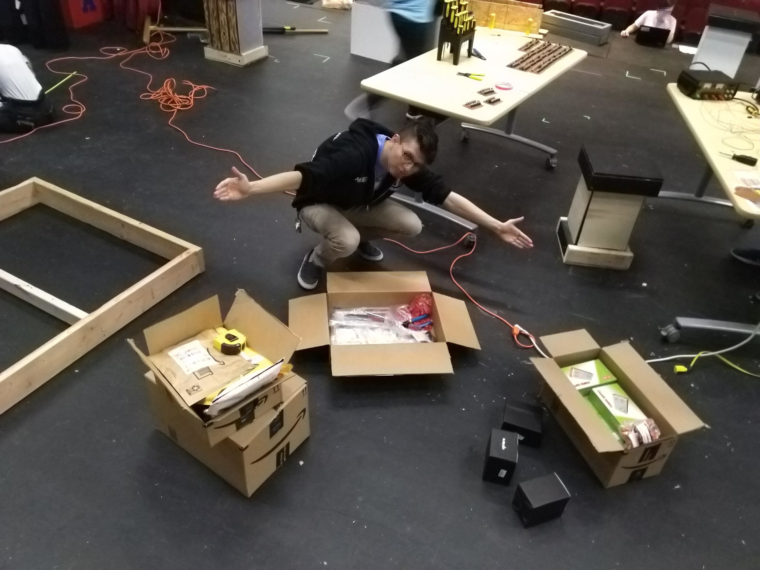
electronics/current-sources/new_parts_1.jpg
