asterane/the-grid/electronics/current-sources/new_parts_2.jpg

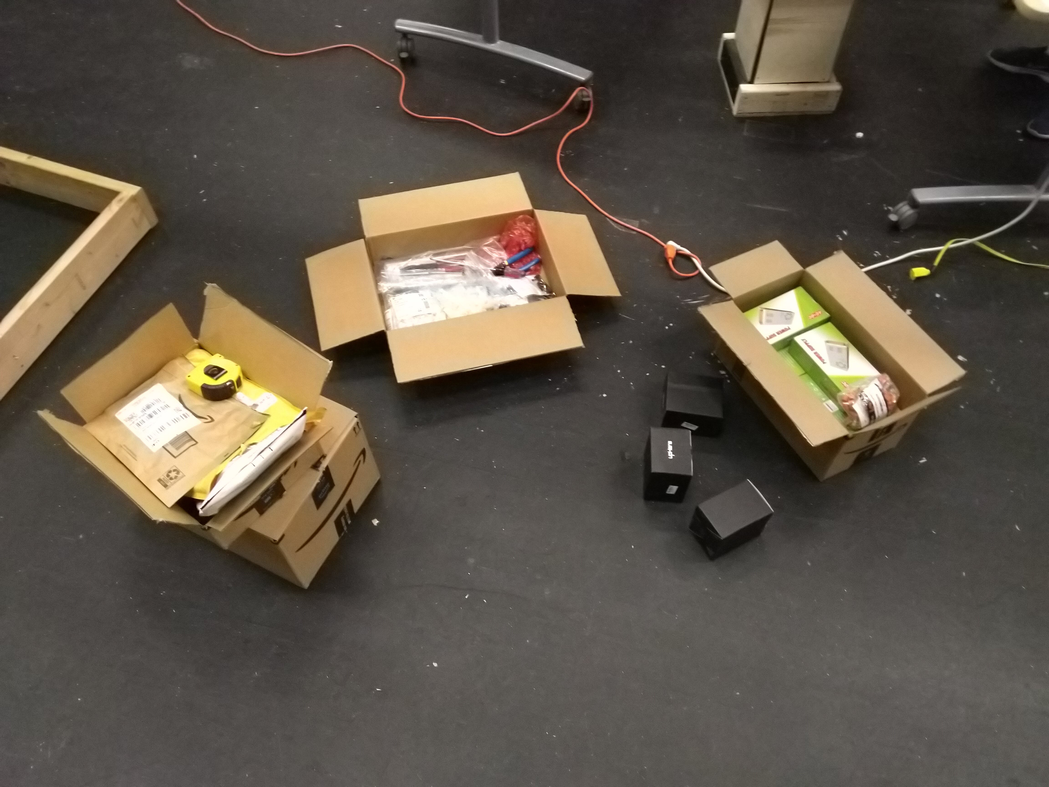
electronics/current-sources/new_parts_2.jpg
