asterane/the-grid/electronics/current-sources/assembly_line_1.jpg

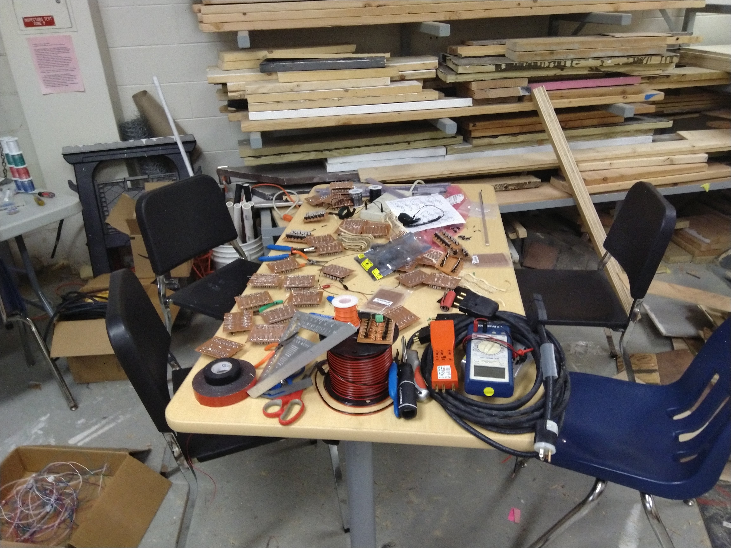
electronics/current-sources/assembly_line_1.jpg
