asterane/the-grid/electronics/current-sources/assembly_line_2.jpg

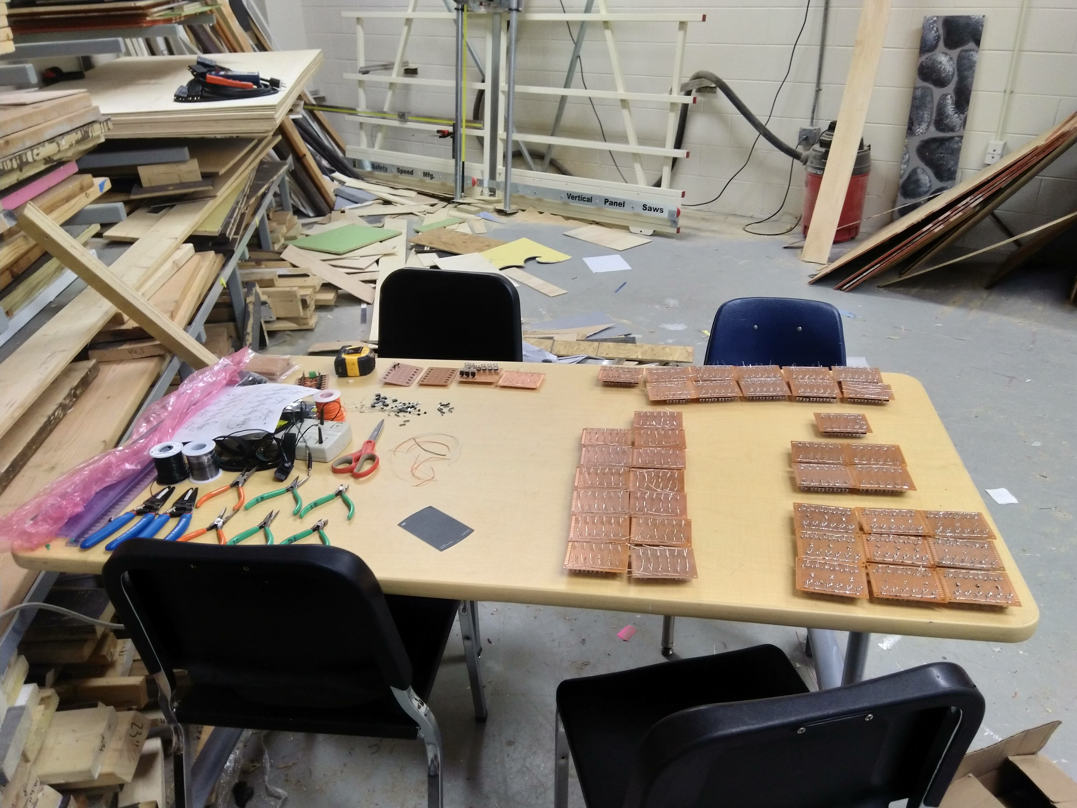
electronics/current-sources/assembly_line_2.jpg
