asterane/the-grid/electronics/current-sources/assembly_line_3.jpg

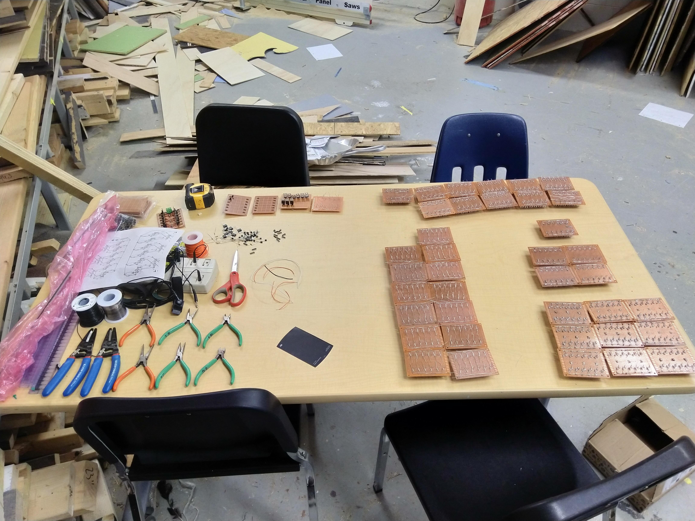
electronics/current-sources/assembly_line_3.jpg
