asterane/the-grid/electronics/current-sources/assembly_line_4.jpg

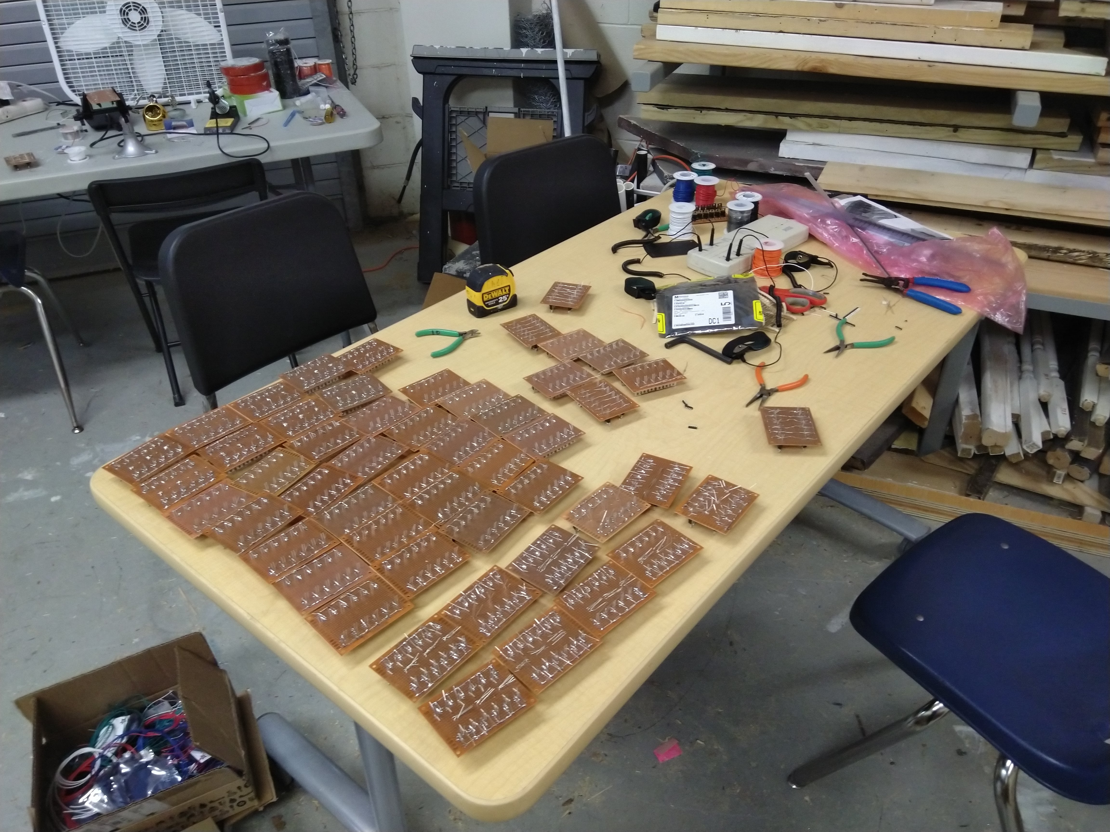
electronics/current-sources/assembly_line_4.jpg
