asterane/the-grid/electronics/current-sources/LED_installation_1.jpg

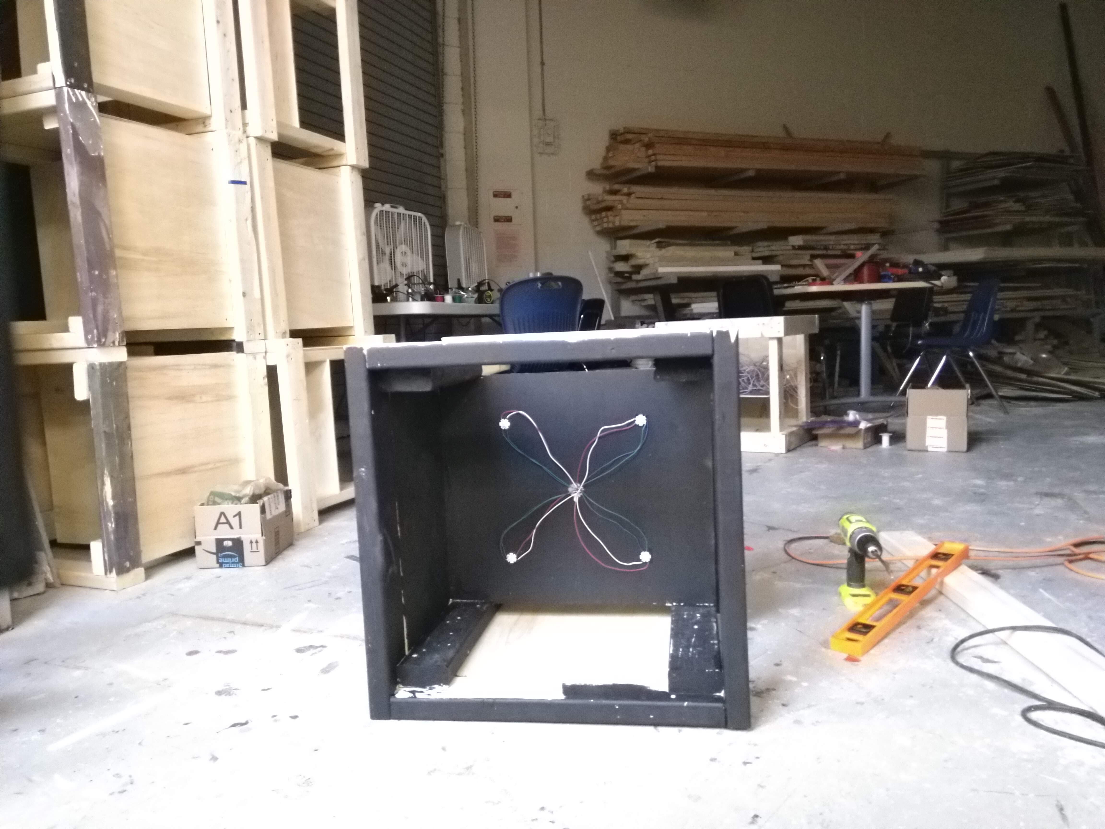
electronics/current-sources/LED_installation_1.jpg
