asterane/the-grid/electronics/current-sources/LED_installation_2.jpg

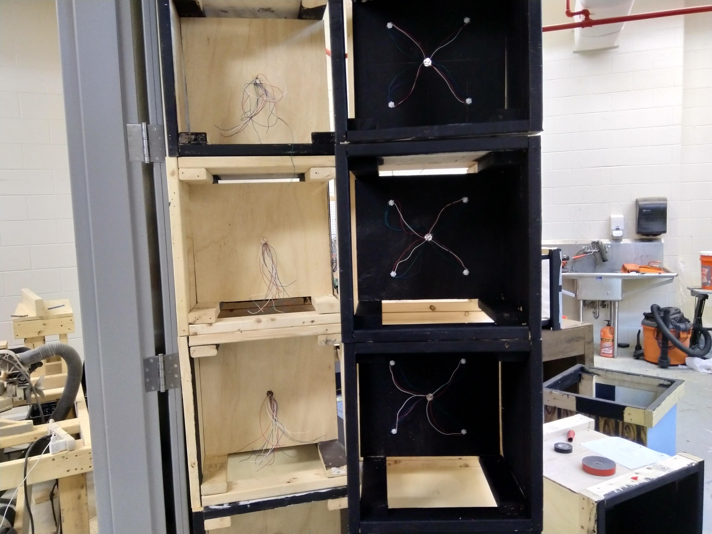
electronics/current-sources/LED_installation_2.jpg
