asterane/the-grid/electronics/current-sources/soldering_station_1.jpg

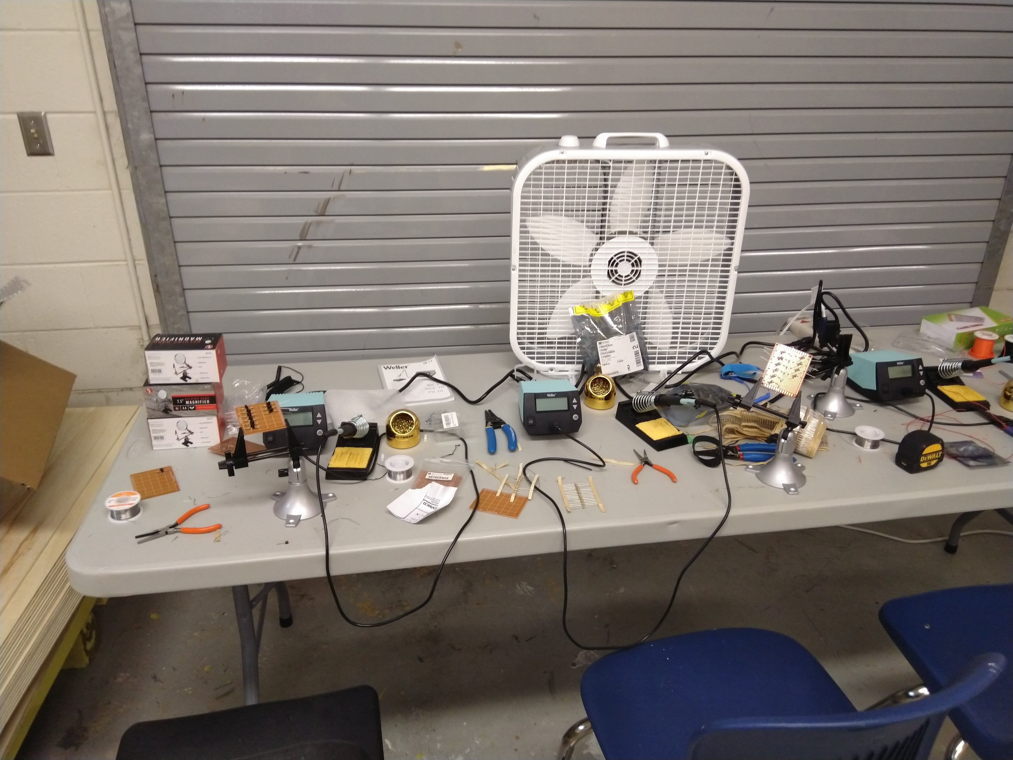
electronics/current-sources/soldering_station_1.jpg
