asterane/the-grid/electronics/current-sources/soldering_station_2.jpg

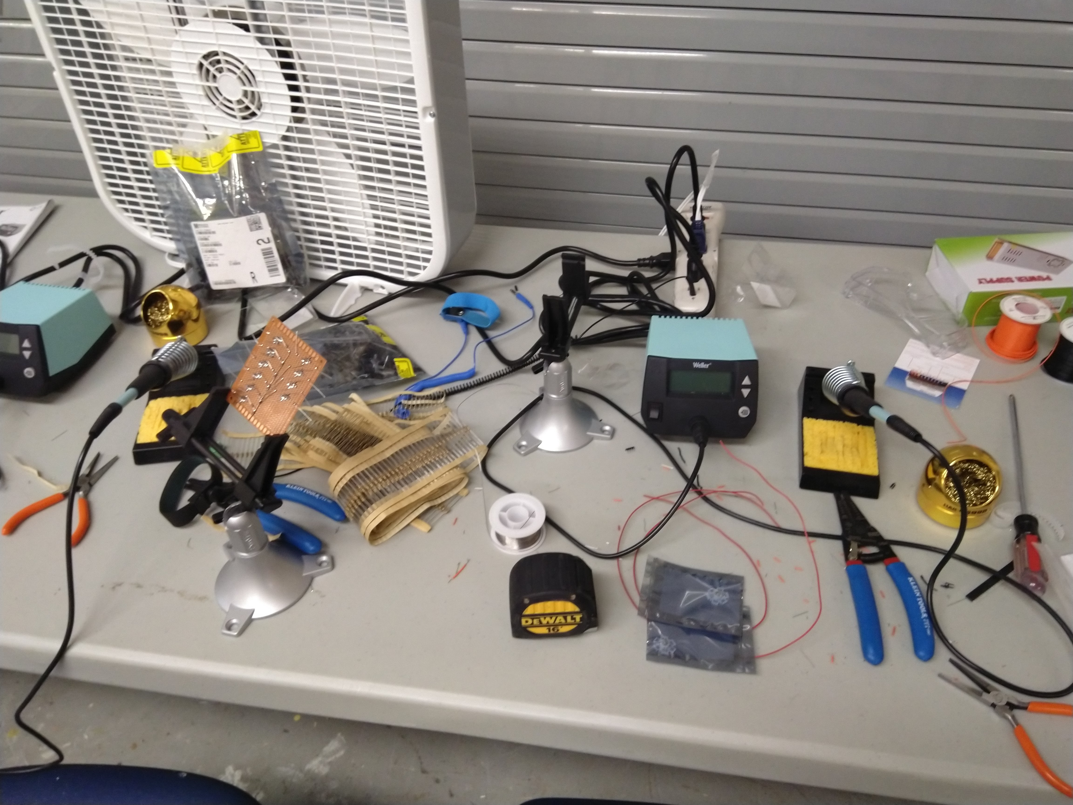
electronics/current-sources/soldering_station_2.jpg
