asterane/the-grid/electronics/current-sources/soldering_station_3.jpg

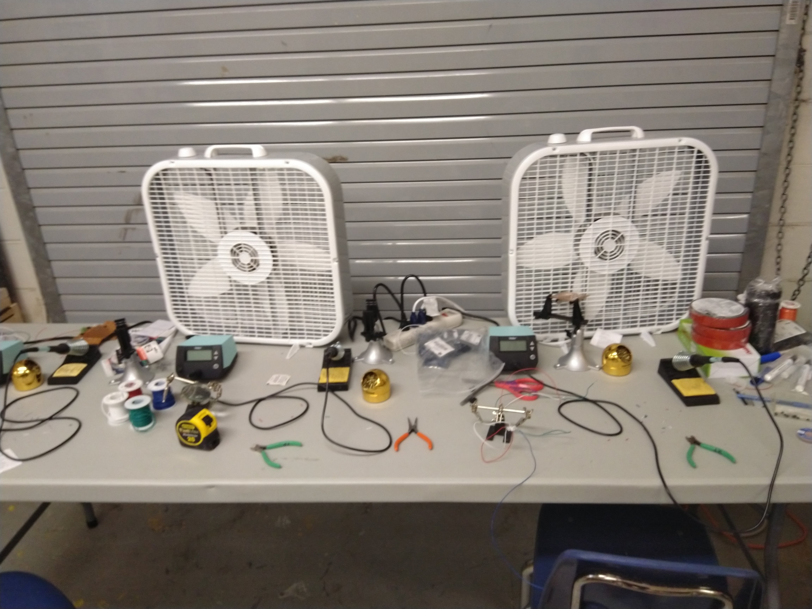
electronics/current-sources/soldering_station_3.jpg
