asterane/the-grid/electronics/current-sources/soldering_station_4.jpg

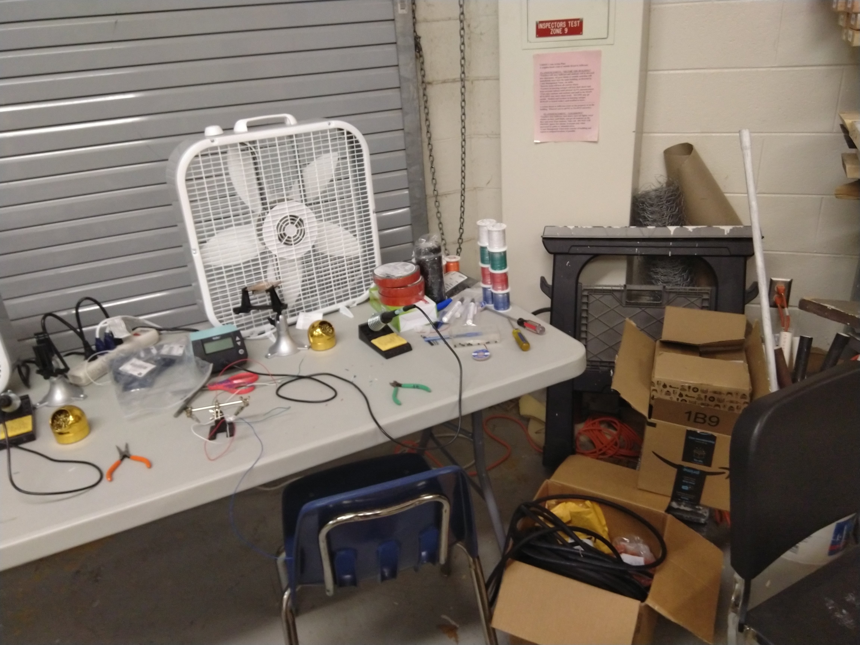
electronics/current-sources/soldering_station_4.jpg
