asterane/the-grid/electronics/current-sources/soldering_station_5.jpg

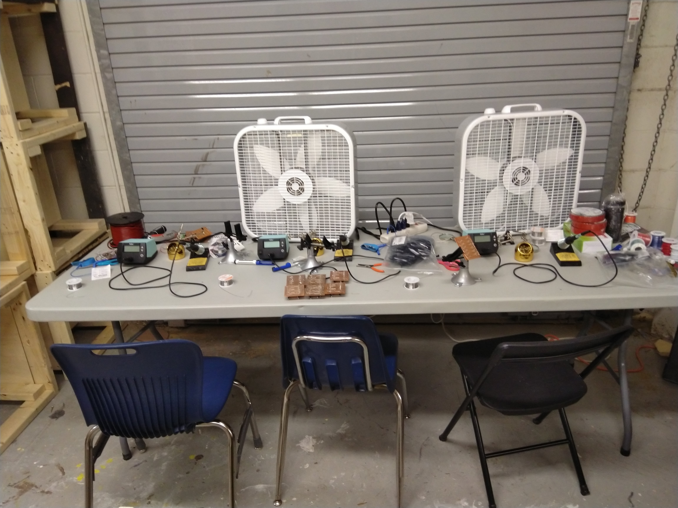
electronics/current-sources/soldering_station_5.jpg
