asterane/the-grid/electronics/power-supplies/psu_assembly_1.jpg

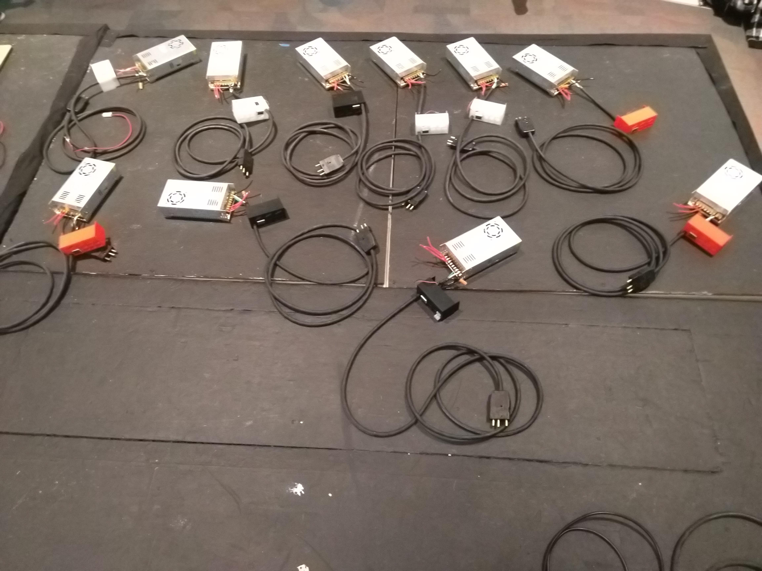
electronics/power-supplies/psu_assembly_1.jpg
