asterane/the-grid/electronics/power-supplies/psu_assembly_2.jpg

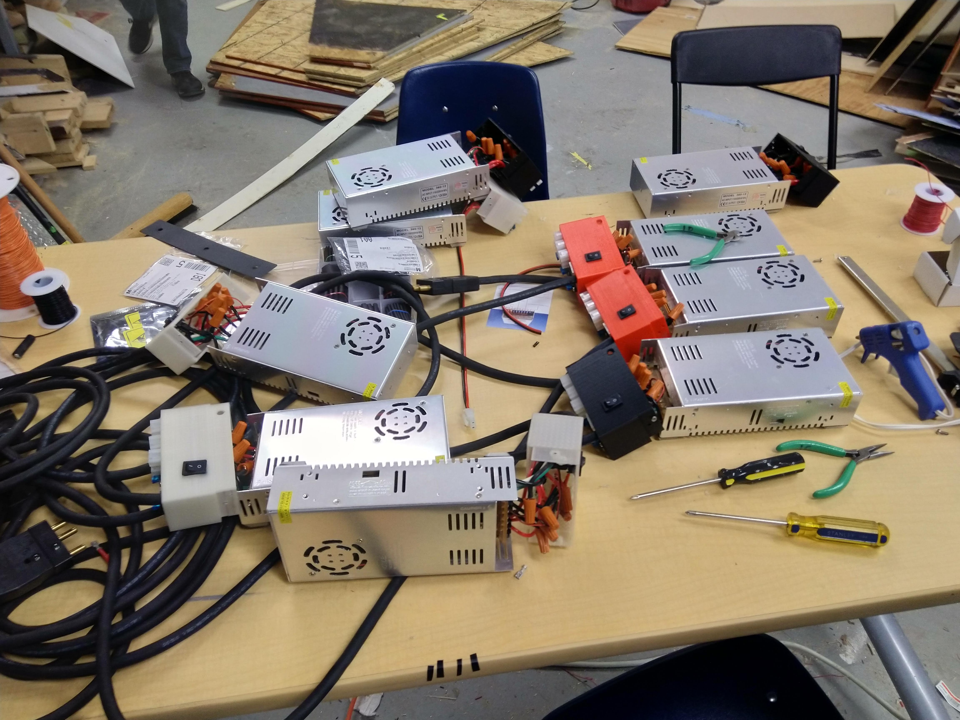
electronics/power-supplies/psu_assembly_2.jpg
