asterane/the-grid/electronics/power-supplies/psu_assembly_3.jpg

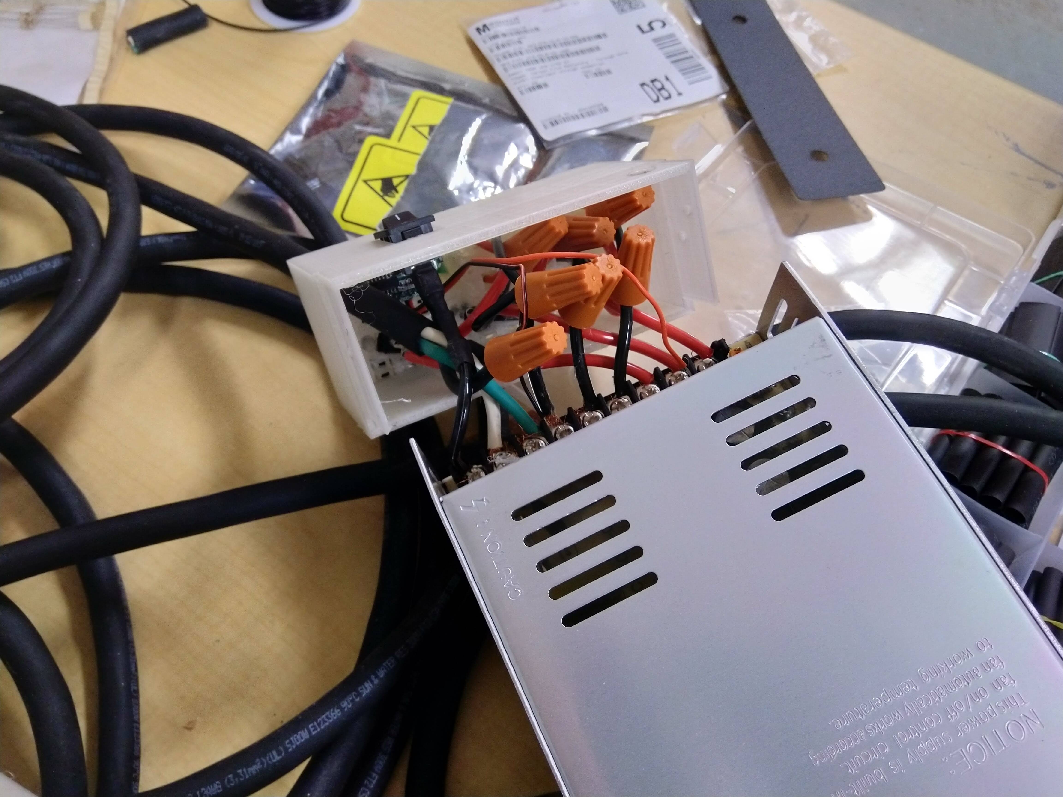
electronics/power-supplies/psu_assembly_3.jpg
