asterane/the-grid/electronics/power-supplies/psu_assembly_4.jpg

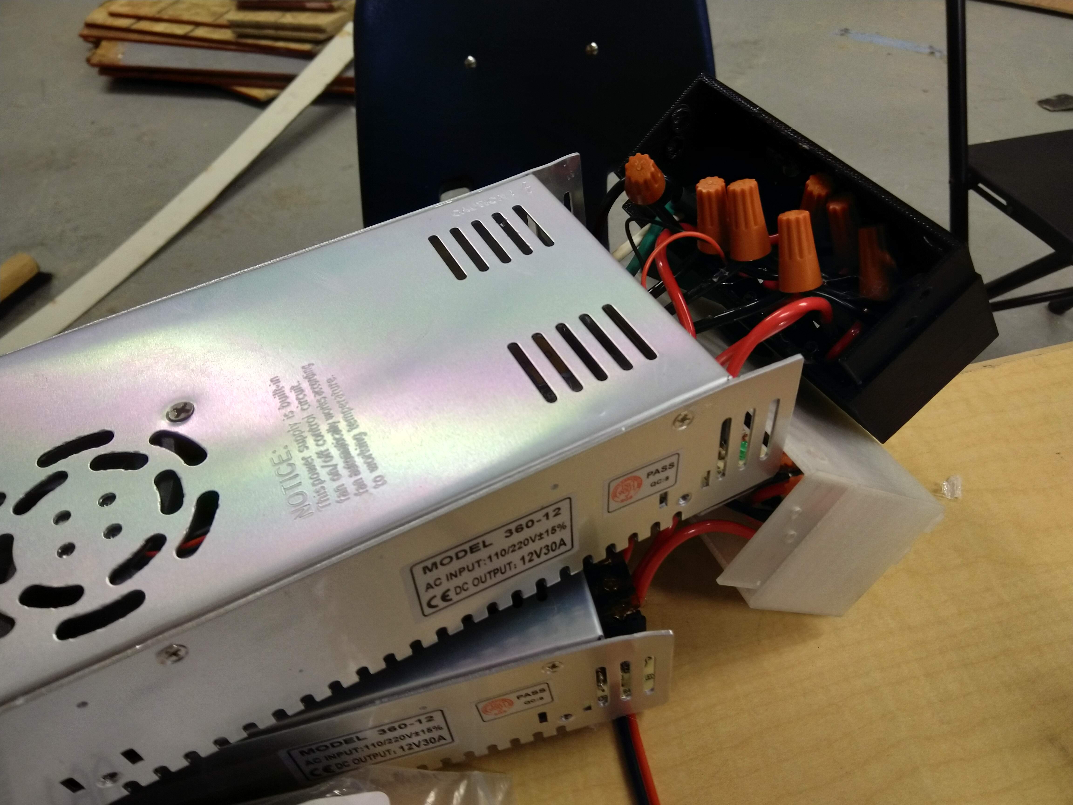
electronics/power-supplies/psu_assembly_4.jpg
