asterane/the-grid/electronics/current-sources/board_testing.jpg

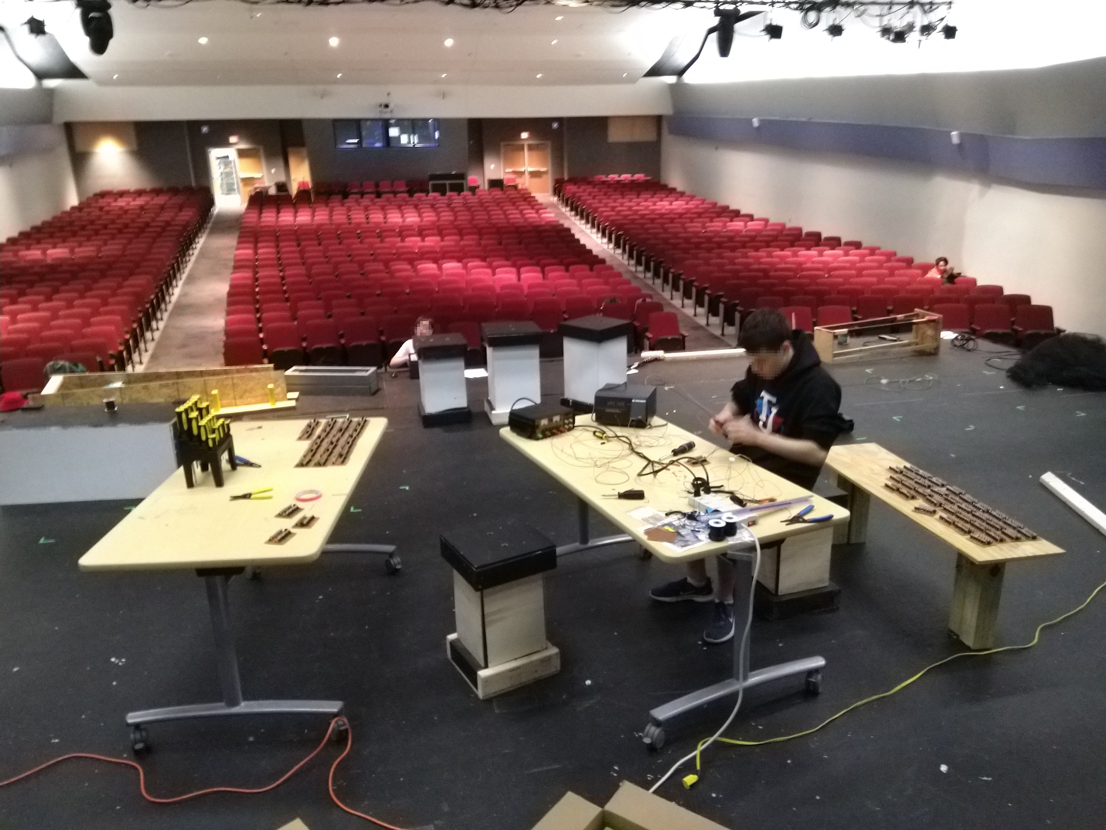
electronics/current-sources/board_testing.jpg
