asterane/the-grid/electronics/current-sources/circuit_test_1.jpg

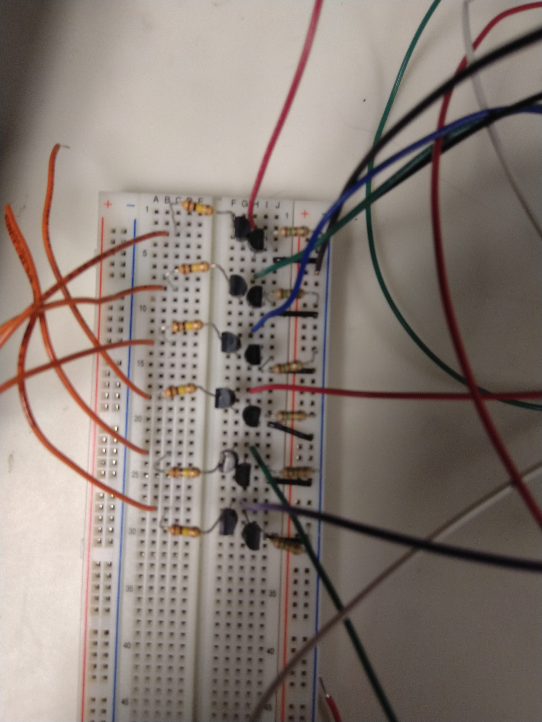
electronics/current-sources/circuit_test_1.jpg
