asterane/the-grid/electronics/current-sources/circuit_test_2.jpg

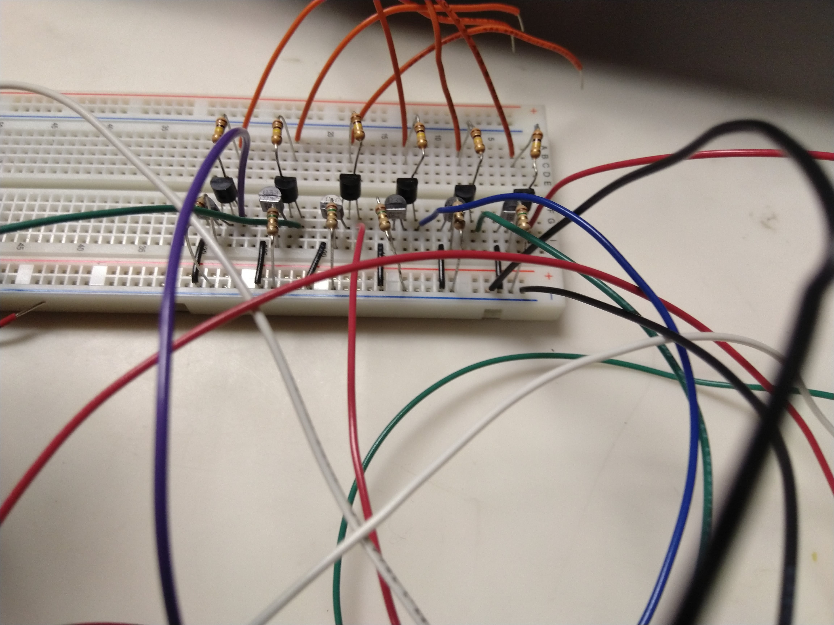
electronics/current-sources/circuit_test_2.jpg
