asterane/the-grid/electronics/current-sources/circuit_test_3.jpg

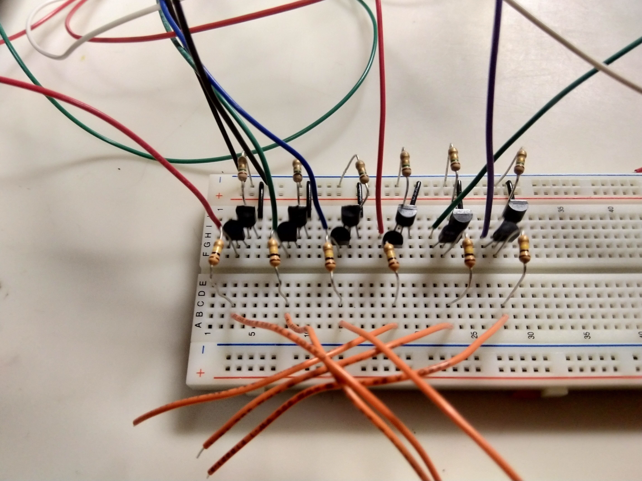
electronics/current-sources/circuit_test_3.jpg
