asterane/the-grid/electronics/current-sources/circuit_test_4.jpg

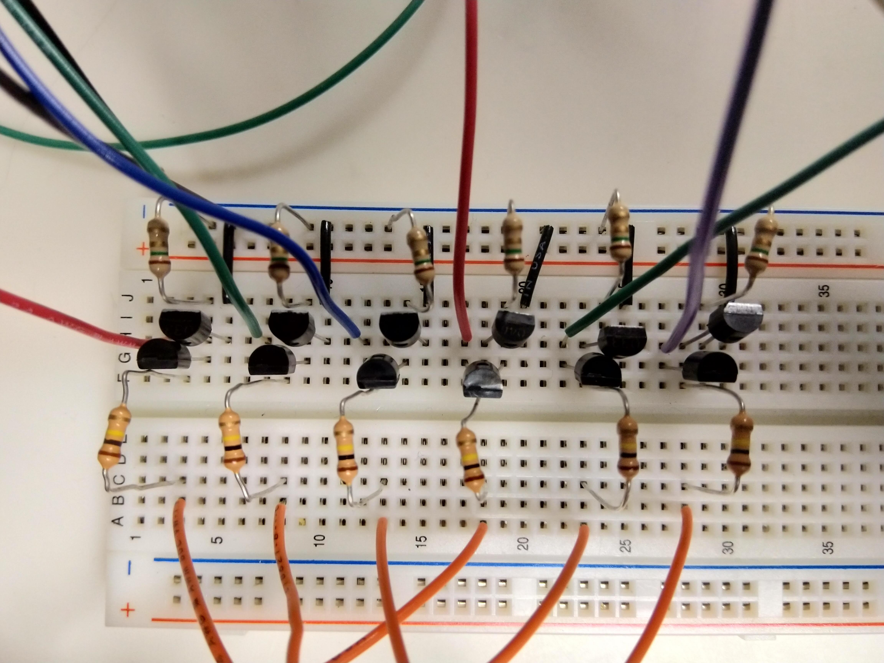
electronics/current-sources/circuit_test_4.jpg
