asterane/the-grid/electronics/current-sources/circuit_test_5.jpg

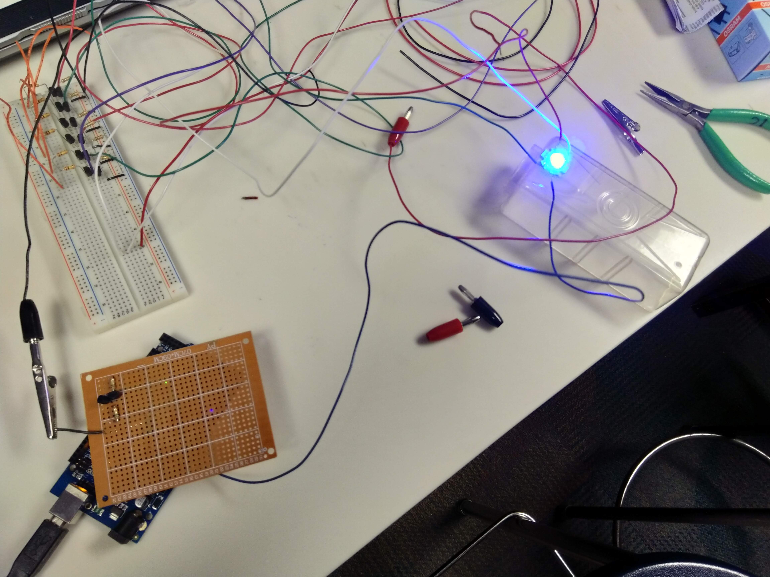
electronics/current-sources/circuit_test_5.jpg
