asterane/the-grid/electronics/current-sources/circuit_test_6.jpg

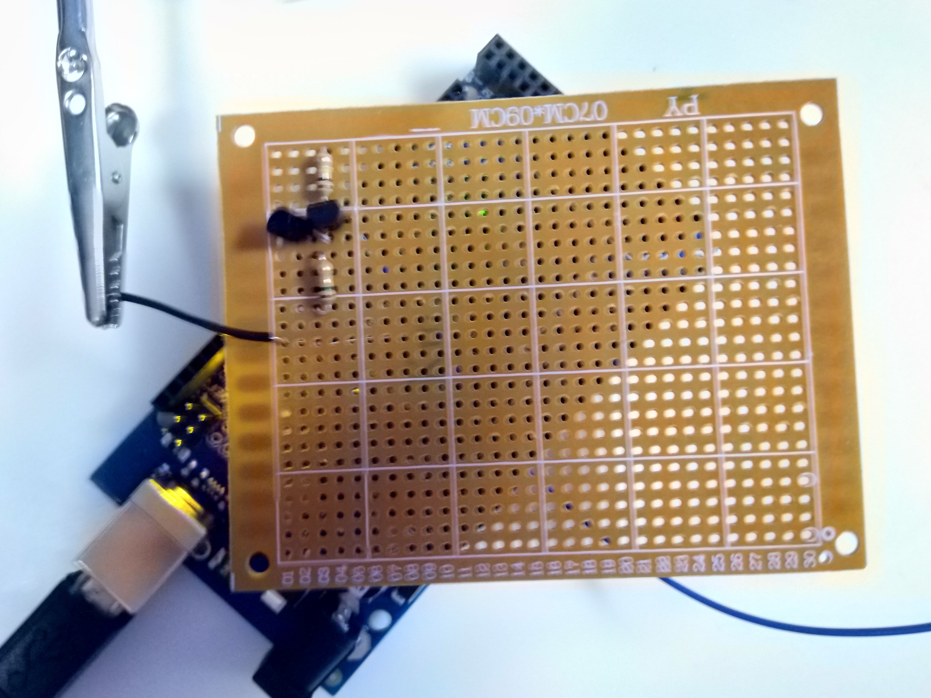
electronics/current-sources/circuit_test_6.jpg
