asterane/the-grid/electronics/current-sources/LED_test_1.jpg

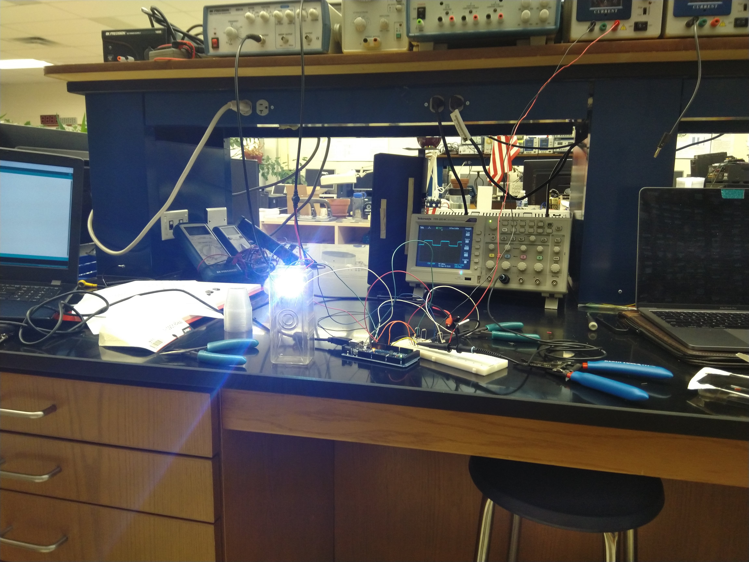
electronics/current-sources/LED_test_1.jpg
