asterane/the-grid/electronics/current-sources/LED_test_2.jpg

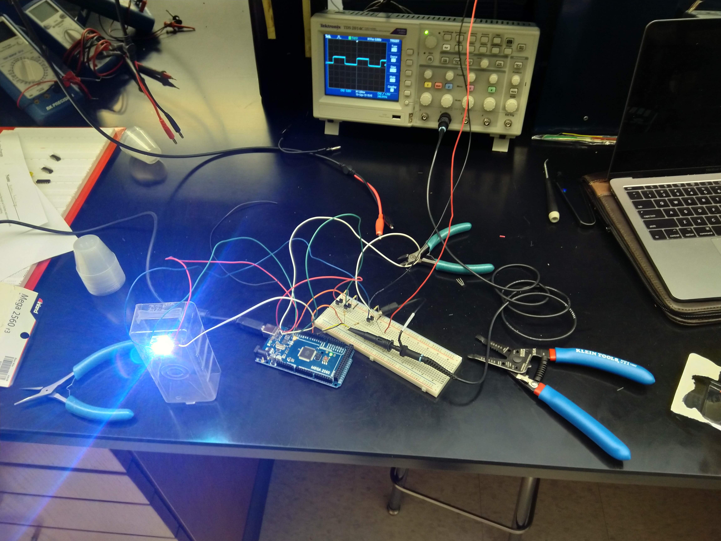
electronics/current-sources/LED_test_2.jpg
