asterane/the-grid/electronics/current-sources/LED_test_3.jpg

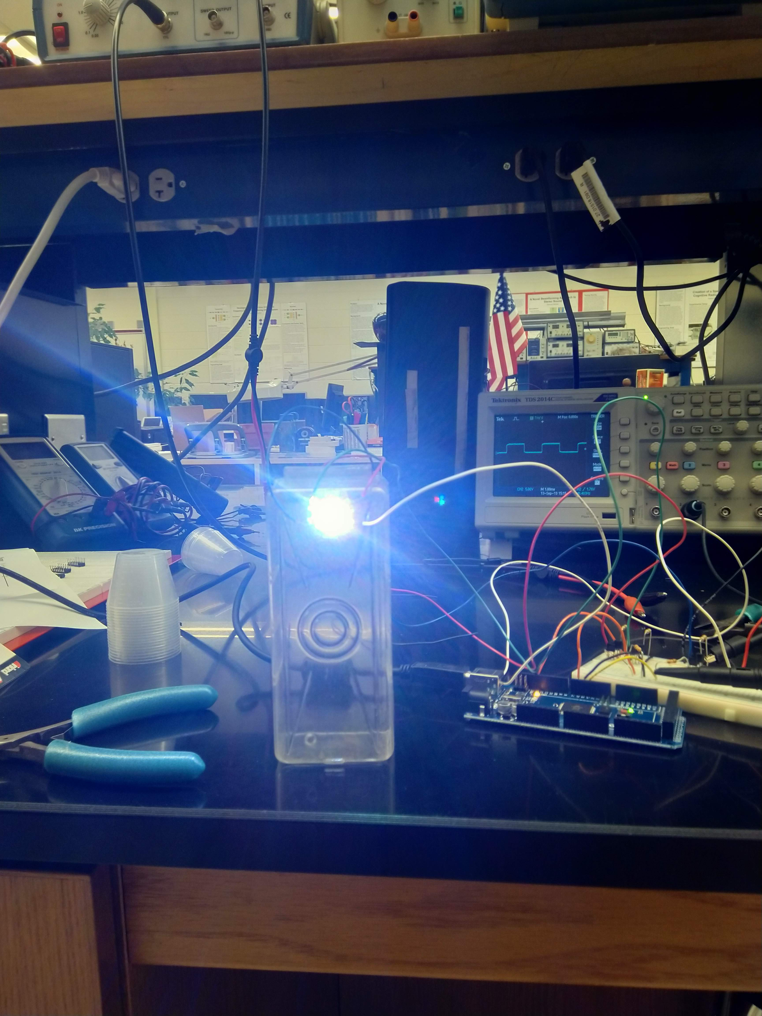
electronics/current-sources/LED_test_3.jpg
