asterane/the-grid/electronics/current-sources/LED_test_4.jpg

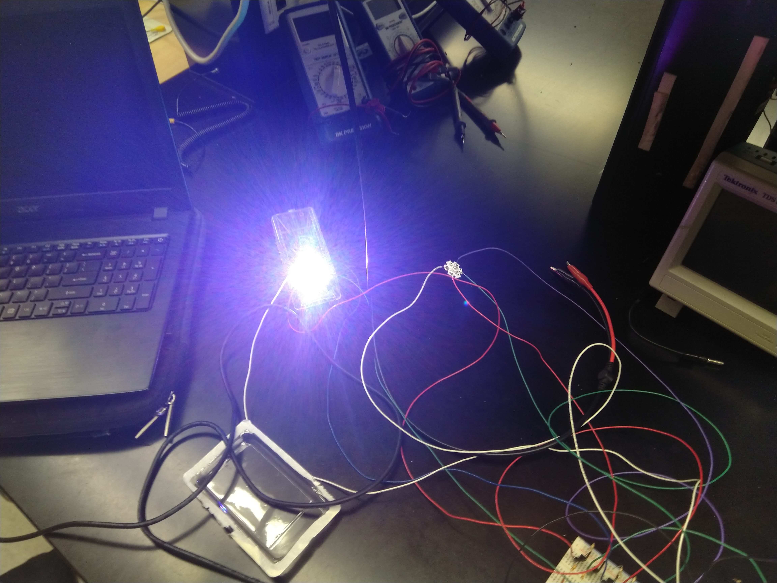
electronics/current-sources/LED_test_4.jpg
