asterane/the-grid/electronics/current-sources/solder_test.jpg

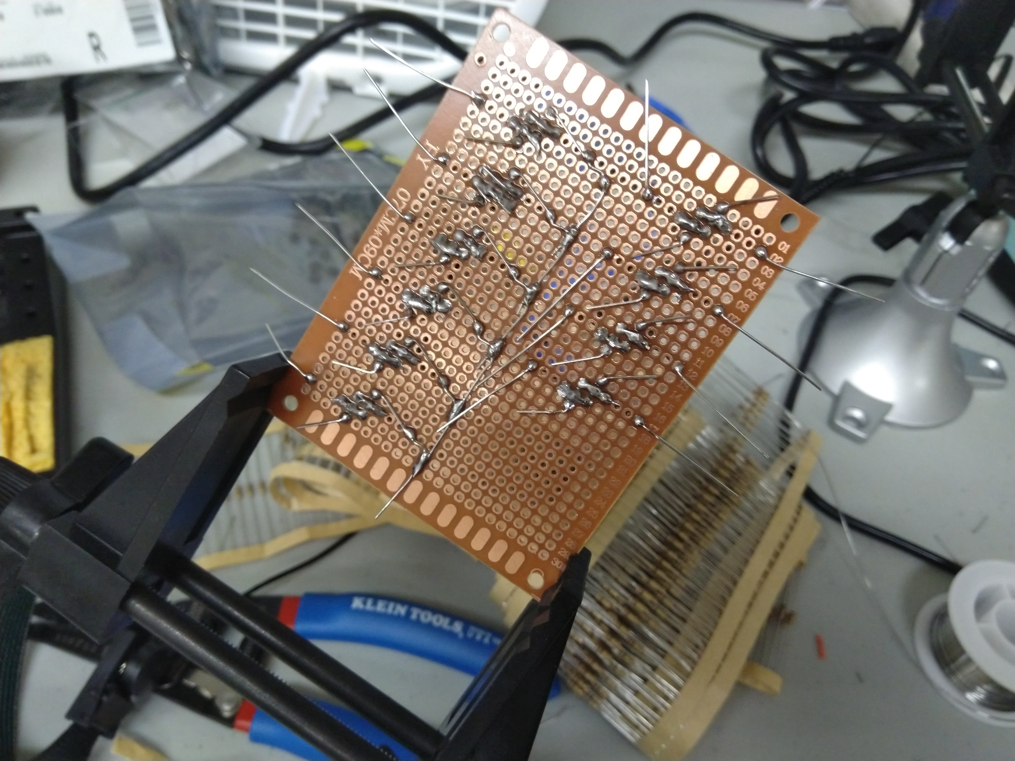
electronics/current-sources/solder_test.jpg
