asterane/the-grid/electronics/current-sources/test_bench.jpg

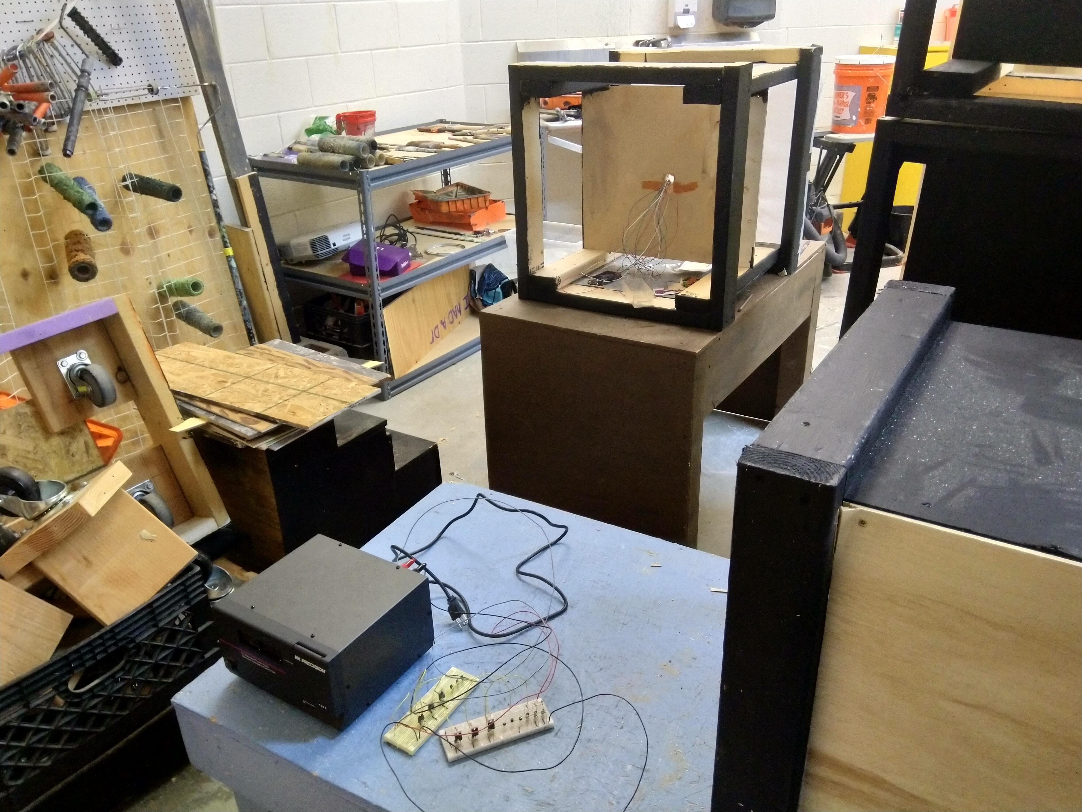
electronics/current-sources/test_bench.jpg
