asterane/the-grid/media/pictures/cube_test_1.jpg

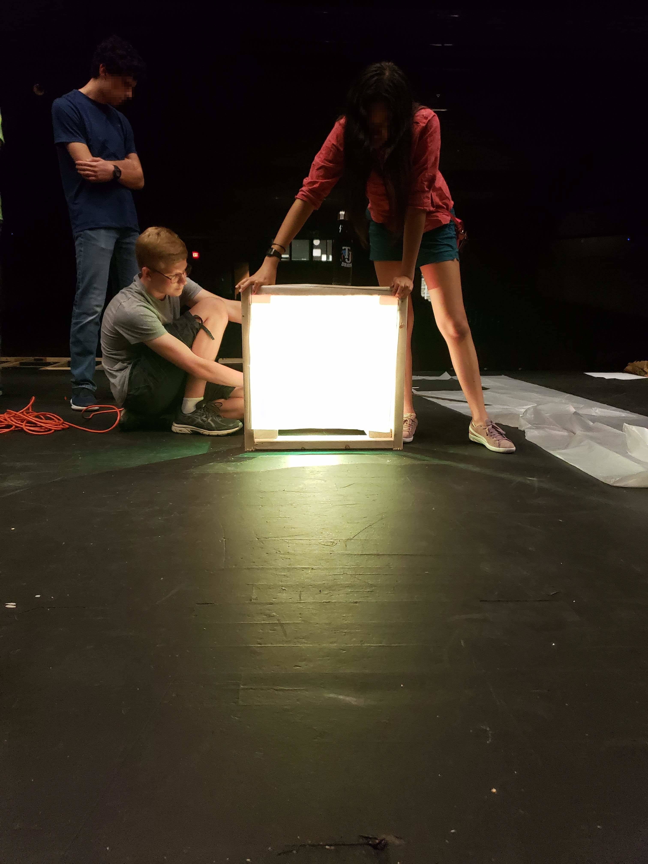
media/pictures/cube_test_1.jpg
