asterane/the-grid/media/pictures/cube_test_2.jpg

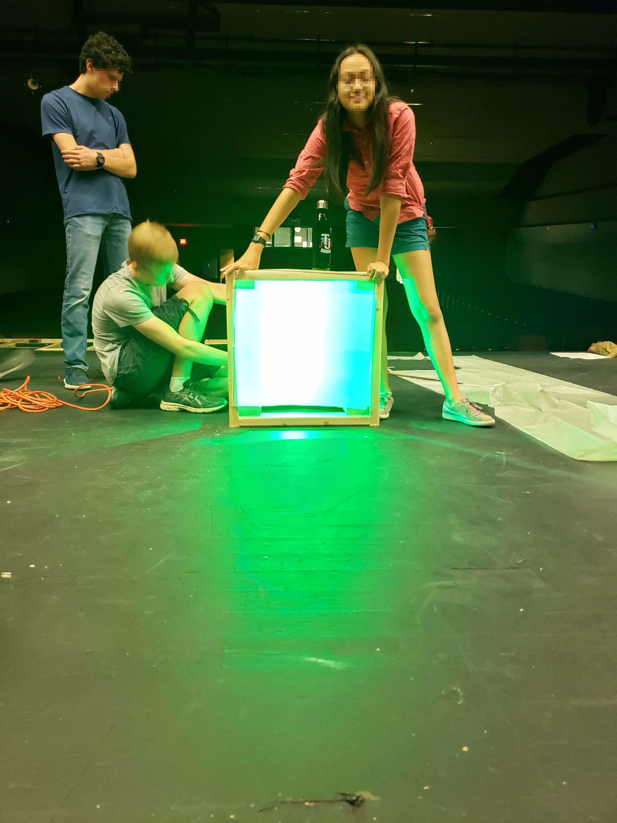
media/pictures/cube_test_2.jpg
