asterane/the-grid/media/pictures/maintenance.jpg

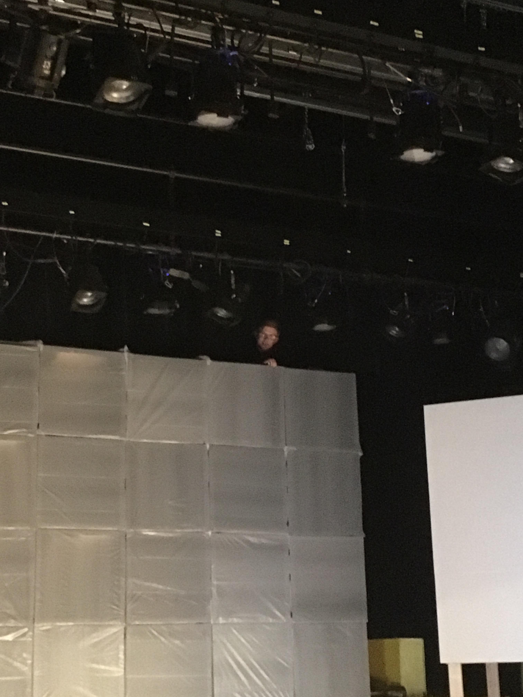
media/pictures/maintenance.jpg
