asterane/the-grid/media/pictures/troubleshooting.jpg

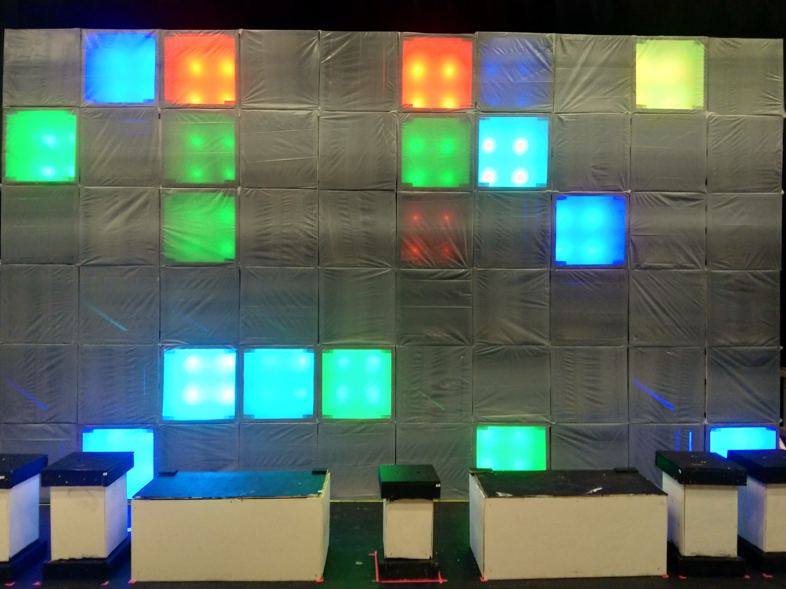
media/pictures/troubleshooting.jpg
