asterane/the-grid/electronics/current-sources/schematics/circuit.pdf

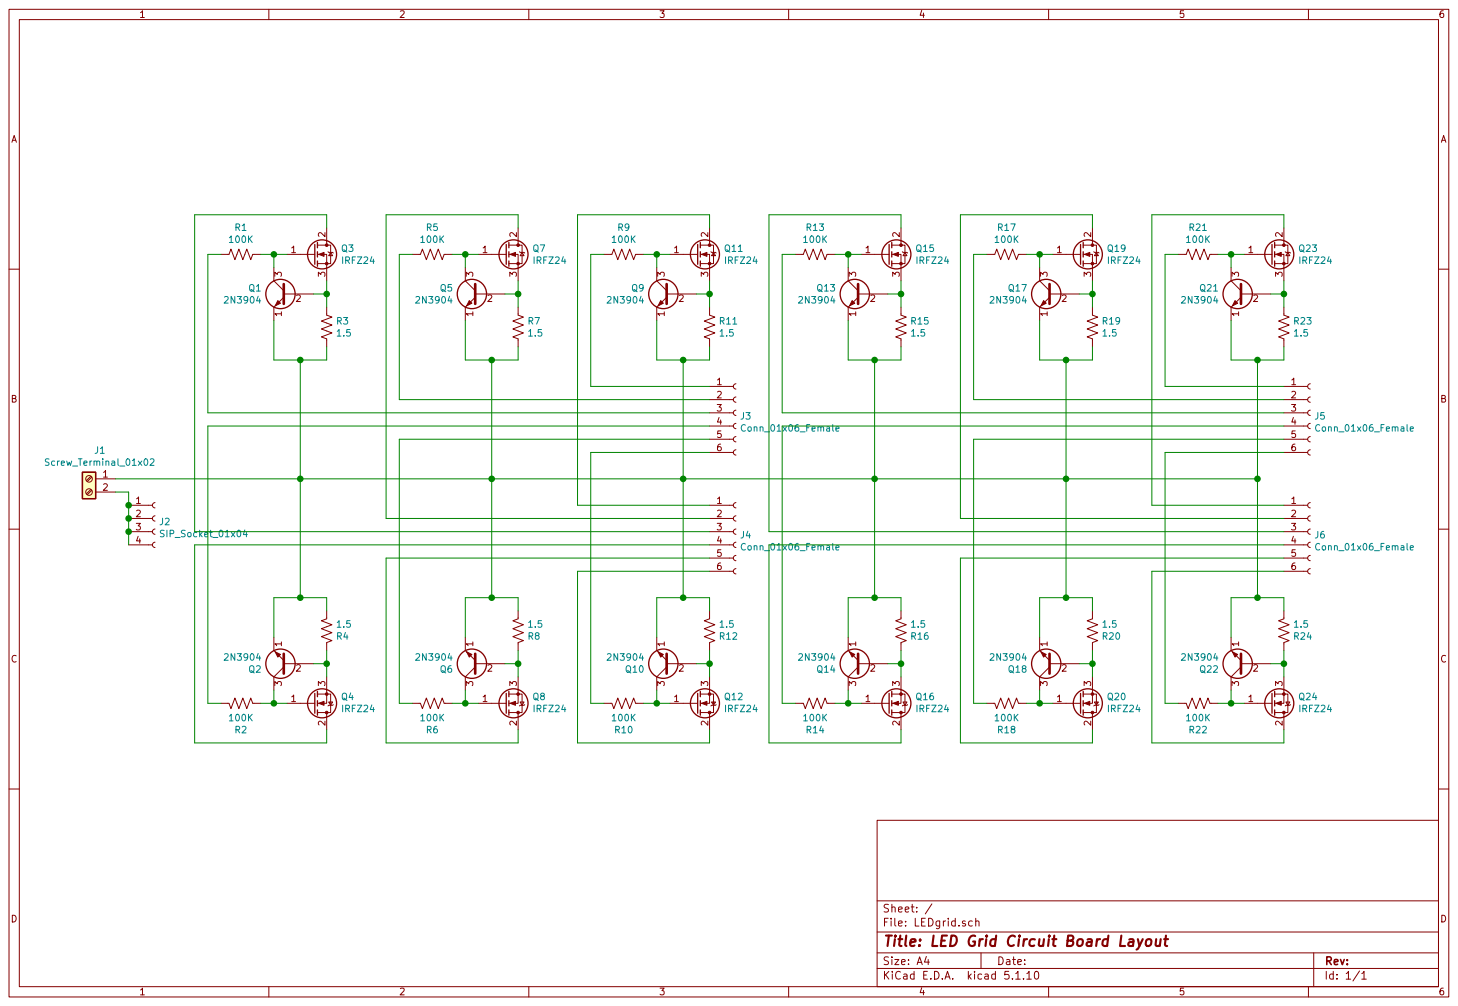
[picture p134: page 1]

File: LEDgrid.sch Sheet: / 1

Id: 1/1 Title: LED Grid Circuit Board Layout
