asterane/the-grid/structure/LED Cube.pdf

221

A

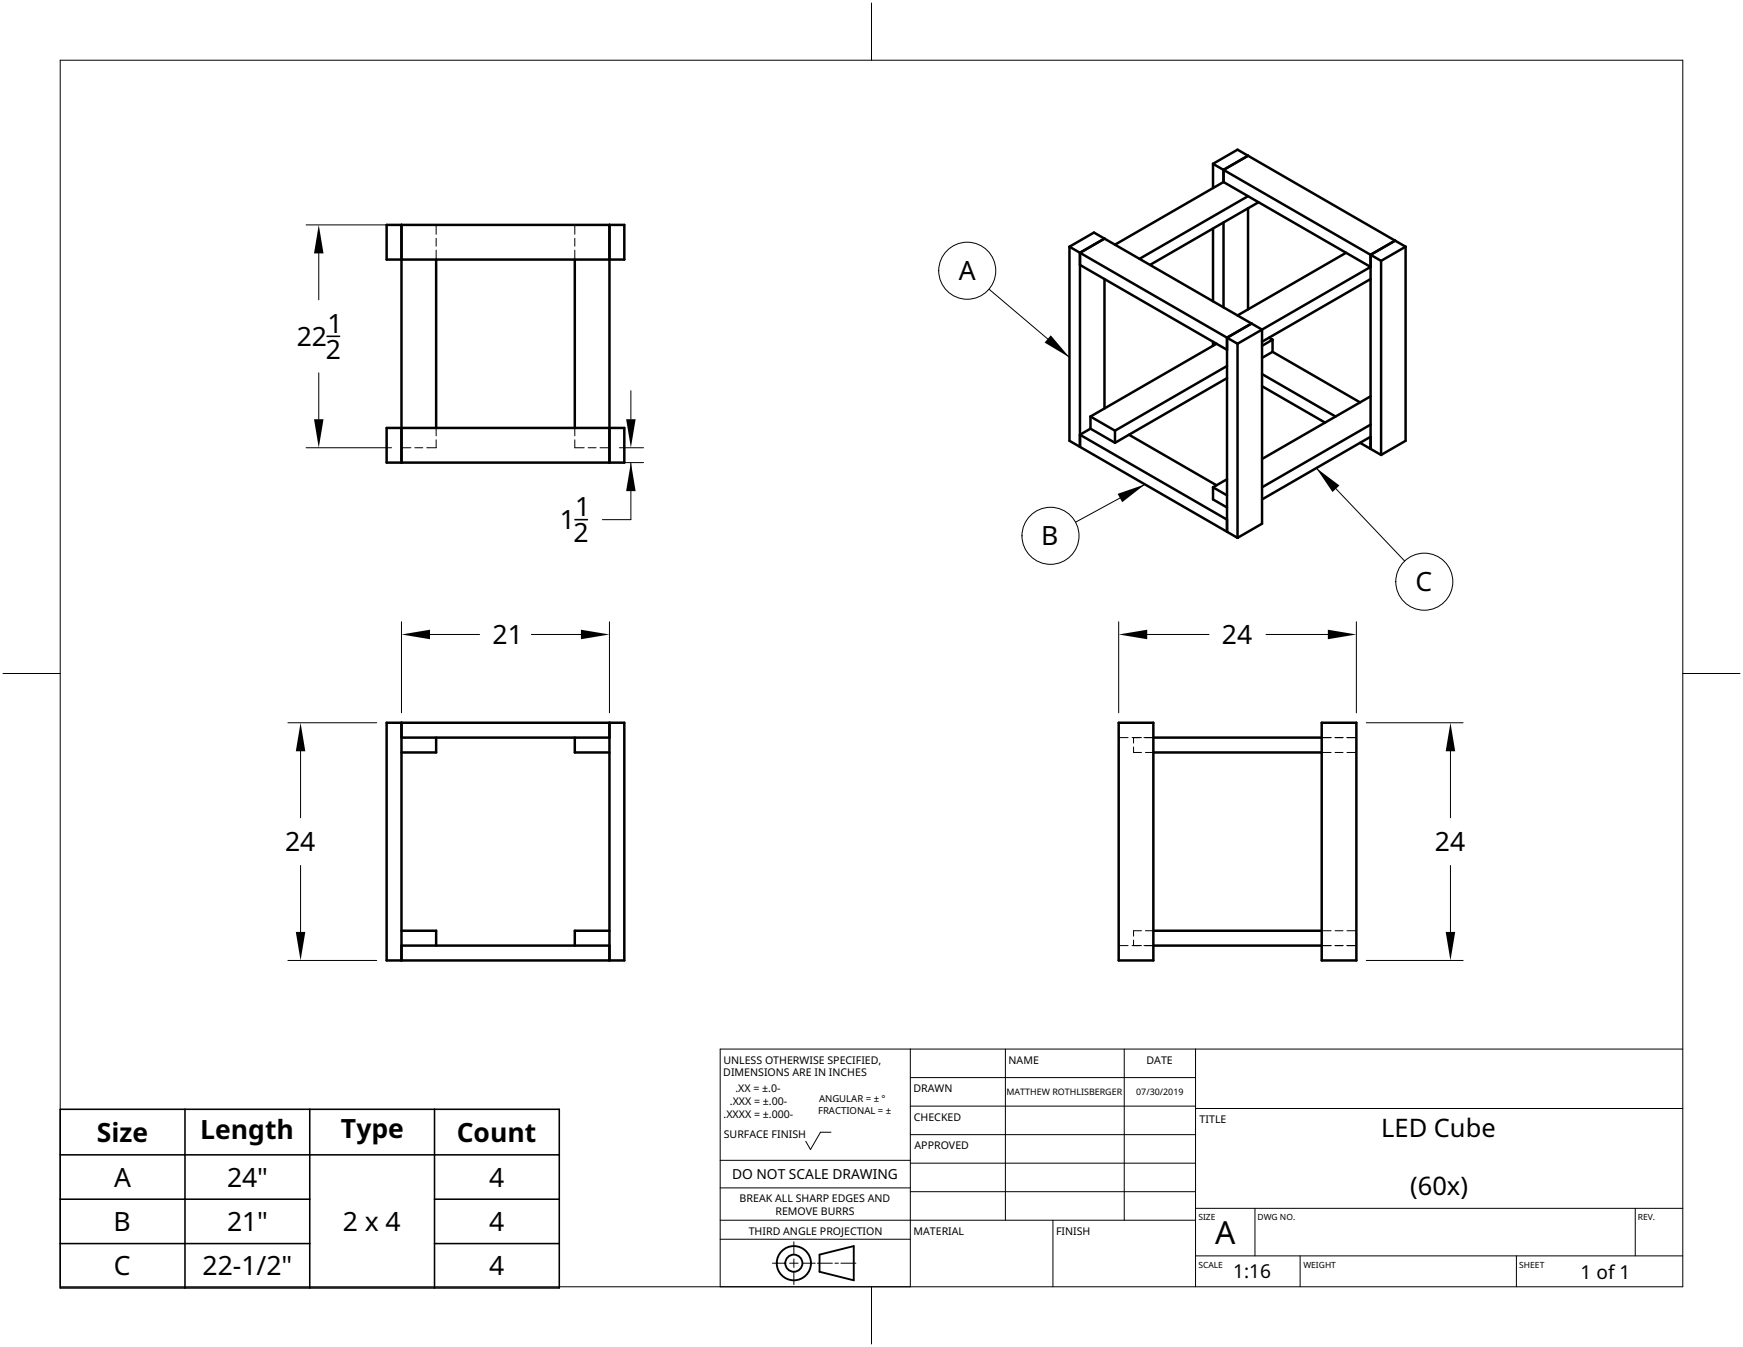
[picture p135: page 1]
REMOVE BURRS; CHECKED; APPROVED; TITLE; LED Cube; Size; Length; Type; Count

UNLESS OTHERWISE SPECIFIED, DIMENSIONS ARE IN INCHES .XX = ±.0-.XXX = ±.00-ANGULAR = ± ° .XXXX = ±.000-FRACTIONAL = ± SURFACE FINISH | | NAME | DATE

DRAWN | MATTHEW ROTHLISBERGER | 07/30/2019

DO NOT SCALE DRAWING

BREAK ALL SHARP EDGES AND

B | 21" | 4
C | 22-1/2" | 4

SIZE A | DWG NO. | REV.

THIRD ANGLE PROJECTION | MATERIAL | FINISH

SCALE 1:16 | WEIGHT | SHEET 1 of 1
