asterane/the-grid/electronics/current-sources/schematics/board.pdf

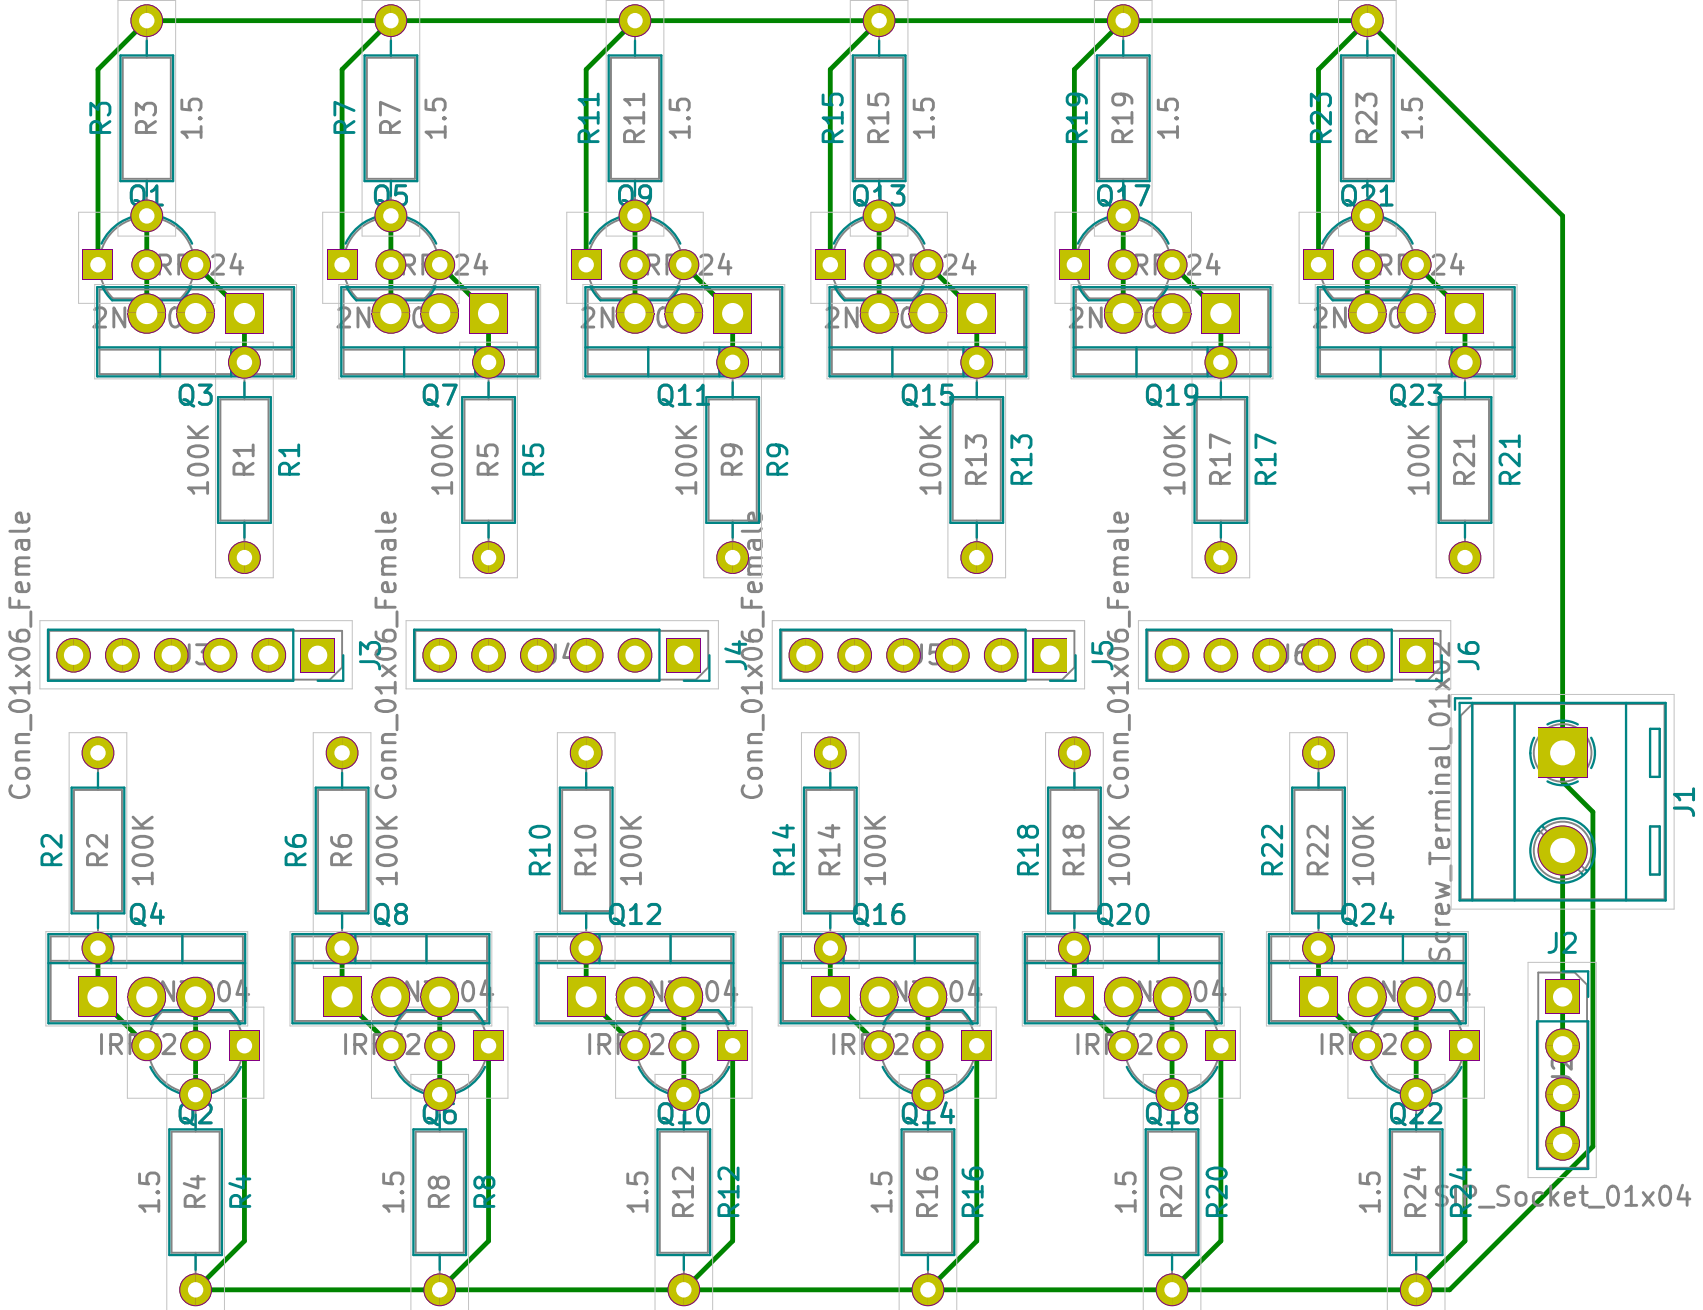
[picture p136: page 1]
