asterane/the-grid/electronics/current-sources/schematics/current_src.asc

D1: LED; LXHL-BW02
M1: nmos; IRFZ44V
Q1: npn; 2N3904
R1: res; 100k
R2: res; 5
V1: voltage; 12
V2: voltage; 5
Named nets: 0
.tran 1000m
