asterane/the-grid/electronics/current-sources/schematics/LEDgrid/LEDgrid.kicad_pcb

## KiCad design electronics/current-sources/schematics/LEDgrid/LEDgrid.kicad_pcb (2020-09-18)

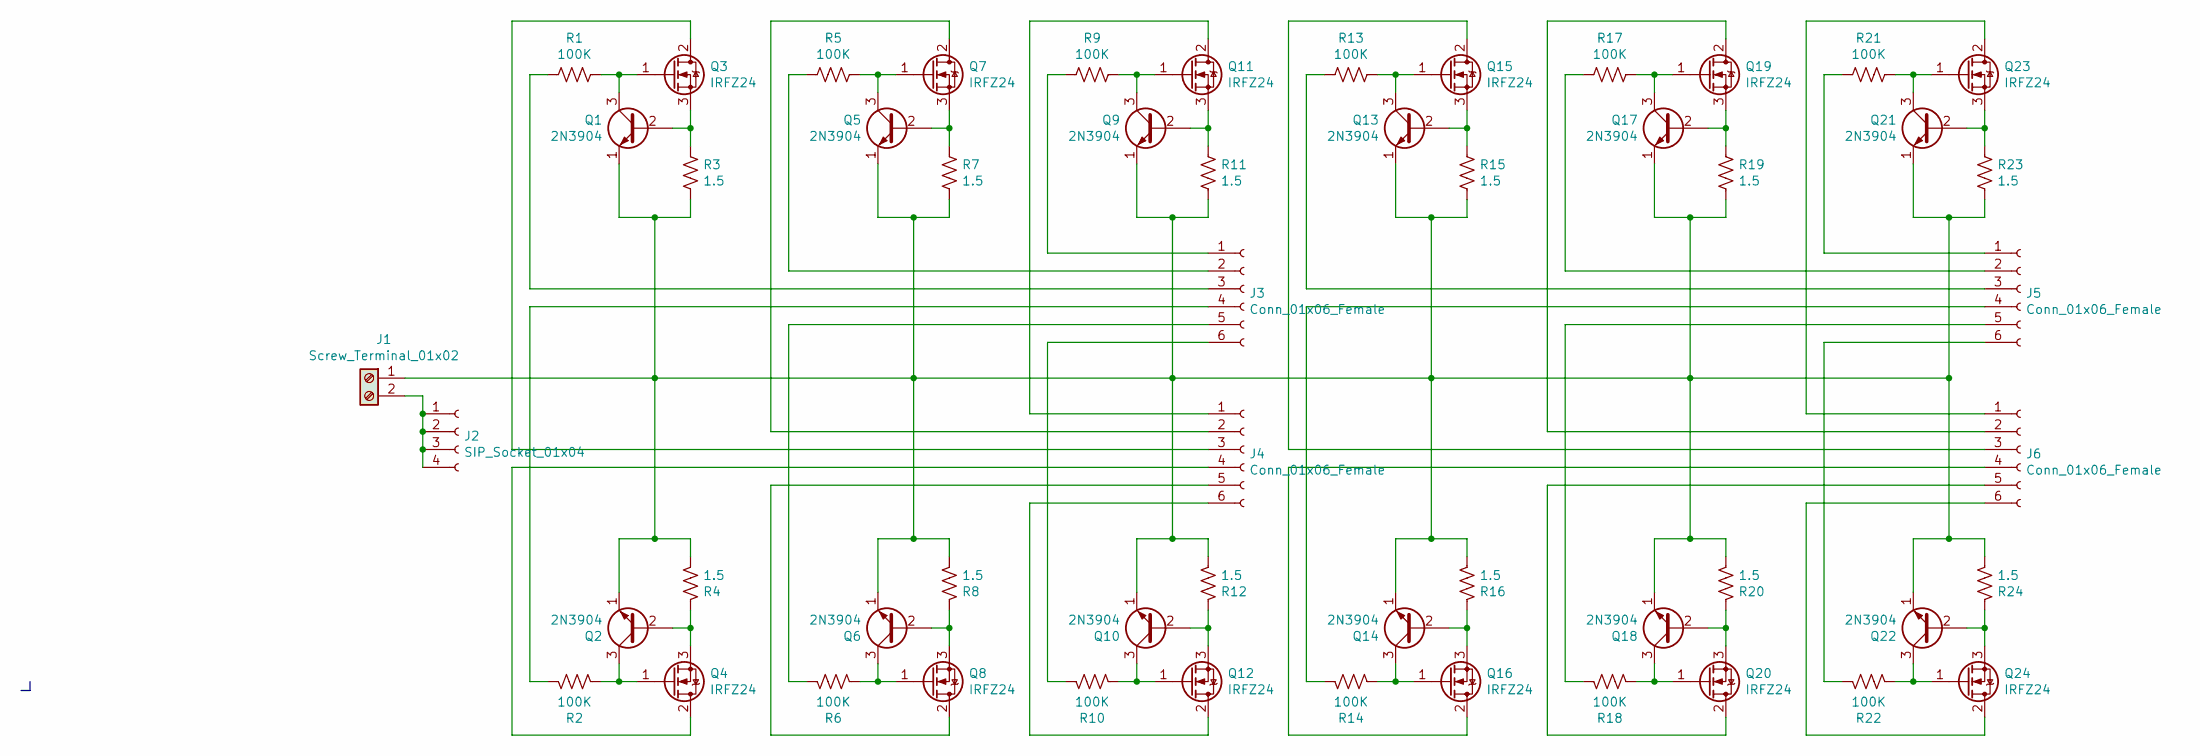
[picture p137: schematic LEDgrid.sch, LED Grid Circuit Board Layout]

Parts:
J1: Screw_Terminal_01x02; TerminalBlock_RND_205-00287_1x02_P5.08mm_Horizontal
J2: SIP_Socket_01x04; PinSocket_1x04_P2.54mm_Vertical
J3, J4, J5, J6: Conn_01x06_Female; PinSocket_1x06_P2.54mm_Vertical
Q1, Q2, Q5, Q6, Q9, Q10, Q13, Q14, Q17, Q18, Q21, Q22: 2N3904; TO-92_Inline_Wide
Q3, Q4, Q7, Q8, Q11, Q12, Q15, Q16, Q19, Q20, Q23, Q24: IRFZ24; TO-220-3_Vertical
R1, R2, R5, R6, R9, R10, R13, R14, R17, R18, R21, R22: 100K; R_Axial_DIN0207_L6.3mm_D2.5mm_P10.16mm_Horizontal
R3, R4, R7, R8, R11, R12, R15, R16, R19, R20, R23, R24: 1.5; R_Axial_DIN0207_L6.3mm_D2.5mm_P10.16mm_Horizontal

Connections:
unnamed: J1.1, Q1.1 (E), Q2.1 (E), Q5.1 (E), Q6.1 (E), Q9.1 (E), Q10.1 (E), Q13.1 (E), Q14.1 (E), Q17.1 (E), Q18.1 (E), Q21.1 (E), Q22.1 (E), R3.2, R4.2, R7.2, R8.2, R11.2, R12.2, R15.2, R16.2, R19.2, R20.2, R23.2, R24.2
unnamed: J1.2, J2.1, J2.2, J2.3, J2.4
unnamed: J3.1, R9.2
unnamed: J3.2, R5.2
unnamed: J3.3, R1.2
unnamed: J3.4, R2.2
unnamed: J3.5, R6.2
unnamed: J3.6, R10.2
unnamed: J4.1, Q11.2 (D)
unnamed: J4.2, Q7.2 (D)
unnamed: J4.3, Q3.2 (D)
unnamed: J4.4, Q4.2 (D)
unnamed: J4.5, Q8.2 (D)
unnamed: J4.6, Q12.2 (D)
unnamed: J5.1, R21.2
unnamed: J5.2, R17.2
unnamed: J5.3, R13.2
unnamed: J5.4, R14.2
unnamed: J5.5, R18.2
unnamed: J5.6, R22.2
unnamed: J6.1, Q23.2 (D)
unnamed: J6.2, Q19.2 (D)
unnamed: J6.3, Q15.2 (D)
unnamed: J6.4, Q16.2 (D)
unnamed: J6.5, Q20.2 (D)
unnamed: J6.6, Q24.2 (D)
unnamed: Q1.2 (B), Q3.3 (S), R3.1
unnamed: Q1.3 (C), Q3.1 (G), R1.1
unnamed: Q2.2 (B), Q4.3 (S), R4.1
unnamed: Q2.3 (C), Q4.1 (G), R2.1
unnamed: Q5.2 (B), Q7.3 (S), R7.1
unnamed: Q5.3 (C), Q7.1 (G), R5.1
unnamed: Q6.2 (B), Q8.3 (S), R8.1
unnamed: Q6.3 (C), Q8.1 (G), R6.1
unnamed: Q10.2 (B), Q12.3 (S), R12.1
unnamed: Q10.3 (C), Q12.1 (G), R10.1
unnamed: Q9.3 (C), Q11.1 (G), R9.1
unnamed: Q9.2 (B), Q11.3 (S), R11.1
unnamed: Q13.2 (B), Q15.3 (S), R15.1
unnamed: Q13.3 (C), Q15.1 (G), R13.1
unnamed: Q14.2 (B), Q16.3 (S), R16.1
unnamed: Q14.3 (C), Q16.1 (G), R14.1
unnamed: Q17.2 (B), Q19.3 (S), R19.1
unnamed: Q17.3 (C), Q19.1 (G), R17.1
unnamed: Q18.2 (B), Q20.3 (S), R20.1
unnamed: Q18.3 (C), Q20.1 (G), R18.1
unnamed: Q21.2 (B), Q23.3 (S), R23.1
unnamed: Q21.3 (C), Q23.1 (G), R21.1
unnamed: Q22.2 (B), Q24.3 (S), R24.1
unnamed: Q22.3 (C), Q24.1 (G), R22.1

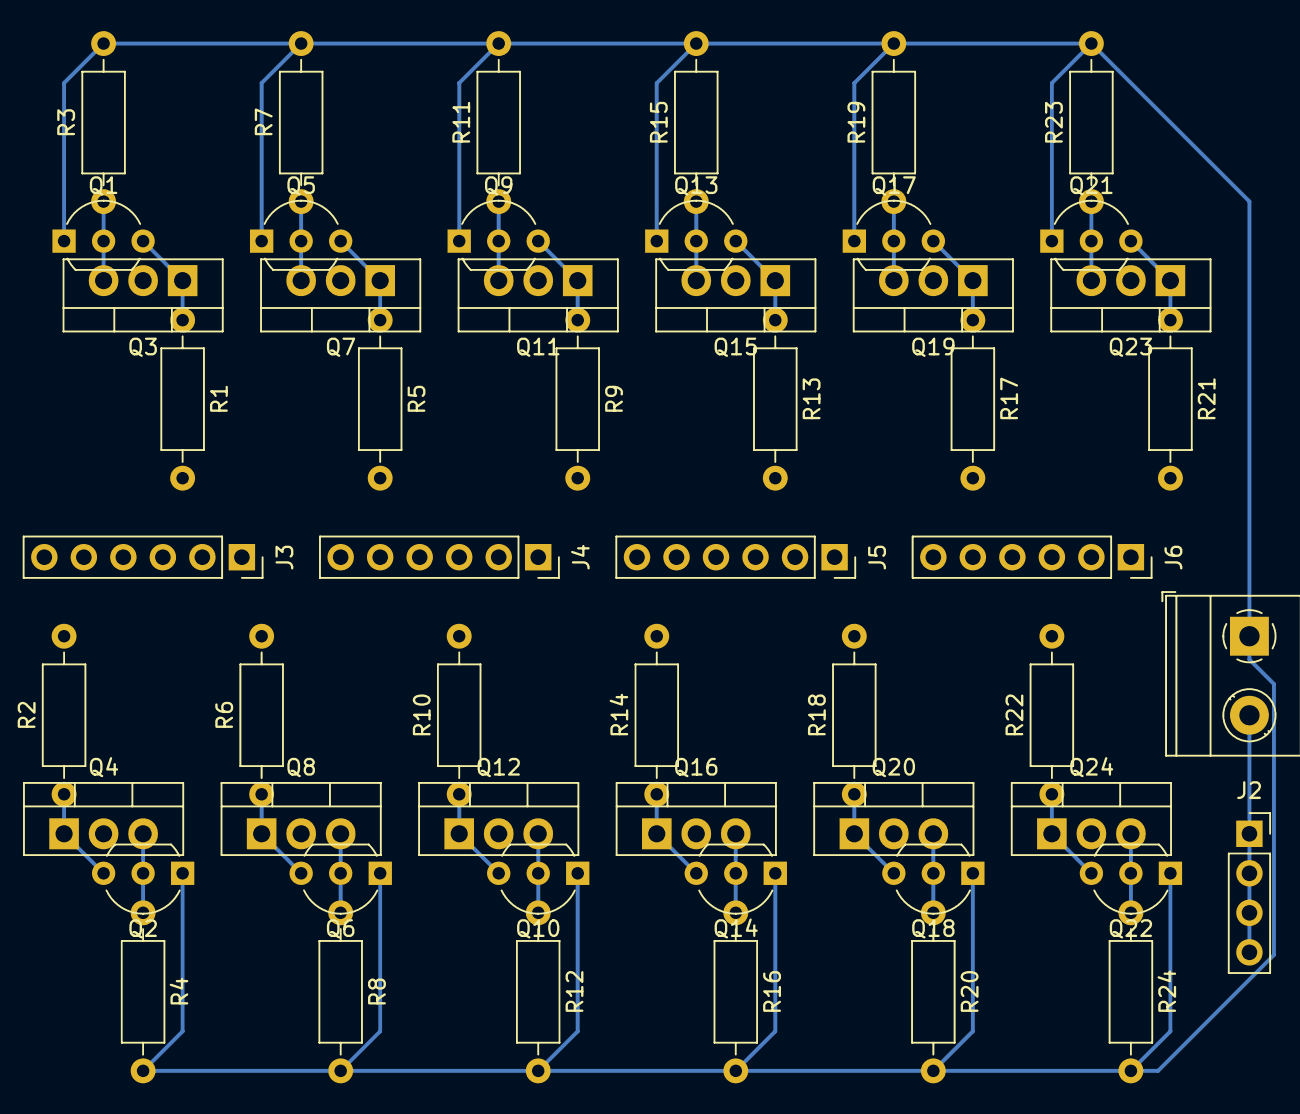
[picture p138: board LEDgrid.kicad_pcb from above]

Board: 2 copper layers, 54 parts (0 on the bottom side), 50 nets.
