asterane/the-grid/(commit log)

2021-12-15 adds additional circuit / board diagrams
2022-03-30 adds SVG version of board layout diagram
