asterane/the-grid/media/pictures/finished_5.jpg

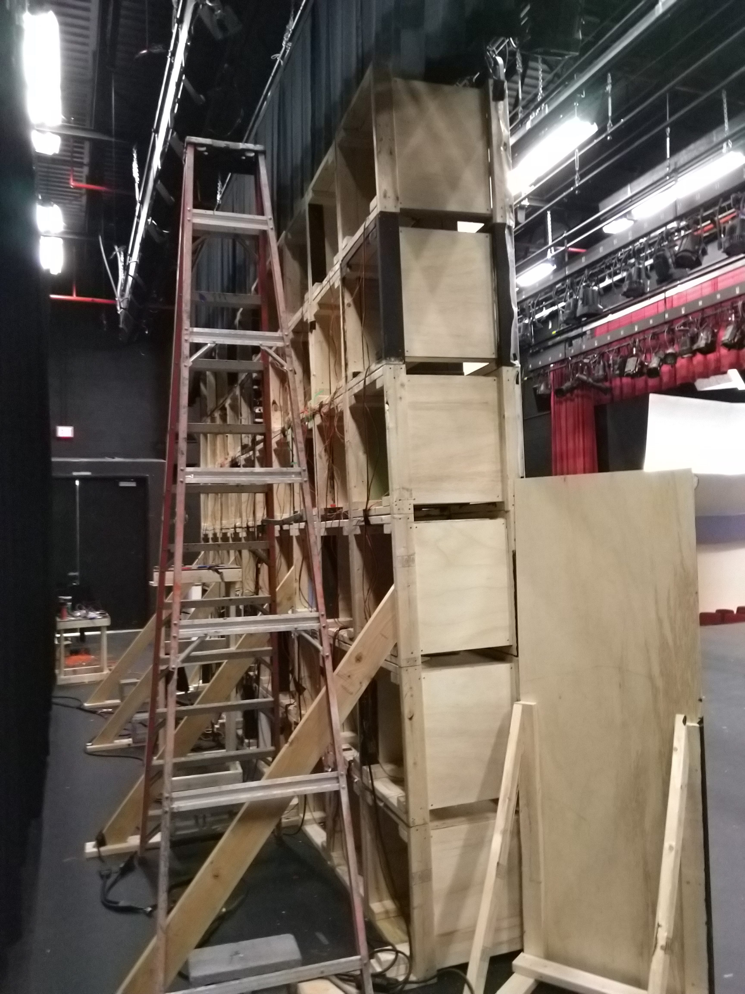
media/pictures/finished_5.jpg
