asterane/the-grid/electronics/current-sources/arduino_test.jpg

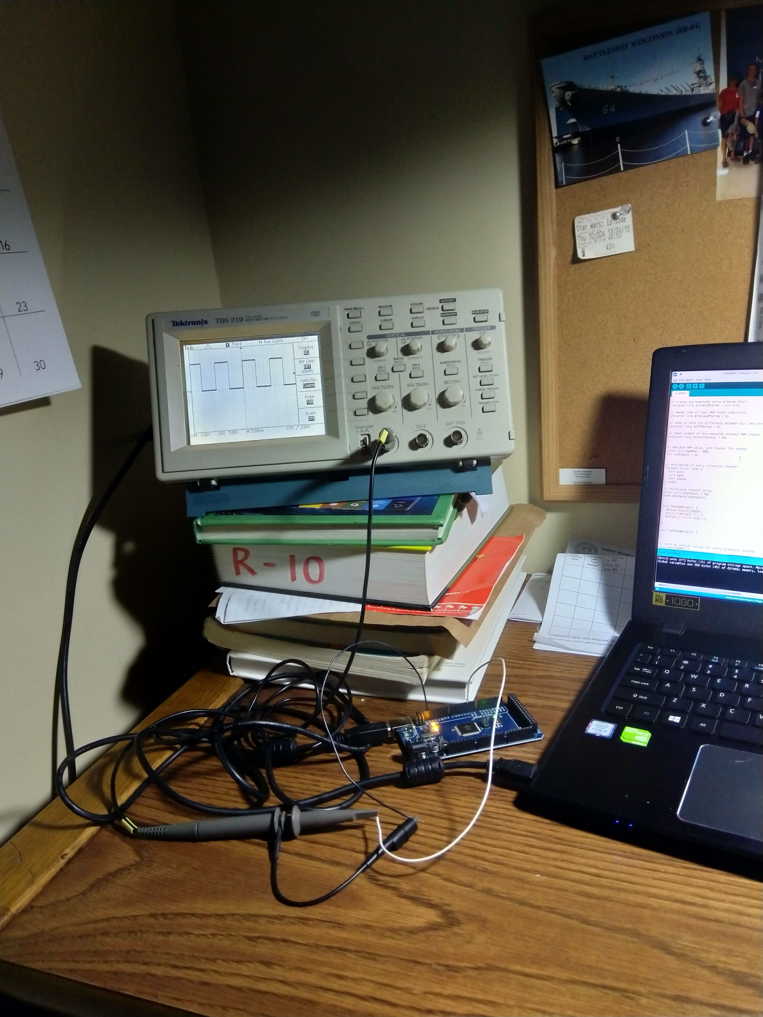
electronics/current-sources/arduino_test.jpg
